24beeca18ece-tech/Target-Landing/docs/history/Autonomous_Parafoil_Targeted_Landing_COMPLETE_CONTEXT.pdf

# Autonomous Parafoil / CanSat Targeted-Landing System

Complete Technical Context, Iteration History, Code Archive, Tests,

# Logs, and Open Issues

Compiled from the conversation history, user-provided source files, test logs, and project memory

## 5 October 2026

# Contents

1 Purpose of this document | 3
2 Executive project state | 3
3 Hardware and wiring history | 3
4 Known verified sensor and calibration details | 4
5 Servo control history and the “both motors move” issue | 5
6 Navigation algorithm history | 5
7 Iteration timeline | 5
8 Python navigation logic testing | 6
9 Targeted landing simulation | 6
10 MATLAB live-monitor concept | 7
11 Most recent MATLAB screenshot diagnosis | 7
12 Why the standalone servo test works but the full code did not | 8
13 Current control law in equations | 8

Autonomous Parafoil / CanSat Targeted Landing | Technical Context Archive
14 How glide speed, descent rate, wind, and steering response are to be obtained | 9
15 Recommended next engineering sequence | 9
16 Known open questions / do not silently assume | 10
17 Compile/environment history | 10
18 Command reference | 10
A Source-code archive | 11
A.2 Archived source 2: Autonomous_Parafoil_Teensy41_FINAL_WDT_T4.ino . . . . | 31
B Artifact inventory and provenance notes | 401
C Final hand-off summary for another AI | 401

# 1 Purpose of this document

This document is a hand-off/context package for another AI model or engineer who will continue development of the autonomous parafoil targeted-landing system. It intentionally records the project history rather than silently replacing earlier designs. The archive distinguishes between verified observations, implemented code, proposed changes, and unresolved questions.

## The immediate project goal is an autonomous parafoil/CanSat system in which a Teensy 4.1

receives GPS position, computes the direction to a fixed or user-specified target coordinate, determines the required left/right steering action, actuates two ST-3009 serial bus servos, and reports the live system state to MATLAB. A later stage is intended to move from simple bearing-following to a more robust precision-landing controller using measured glide speed, descent rate, wind, steering response, and eventually a PD or predicted-landing controller.

# 2 Executive project state

Item | Current state
MCU | Teensy 4.1
GPS | Foxeer M10Q 180; proven standalone GPS baud is 38400 on Serial3
GPS pins | GPS TX →Teensy 15 (RX3); GPS RX →Teensy 14 (TX3)
Navigation sensors | GPS course above speed threshold; QMC5883 compass as low-speed
| fallback in current code
Compass | QMC5883 at I2C 0x0D; calibration values documented below; navi-
| gation mirror enabled
IMU | LSM6DSO32 at 0x6A on I2C
Barometer | BMP581 0x46/0x47; diagnostic only in current controller
Steering servos | 2 x ST-3009 serial bus servos, IDs 1 and 2, Serial1 half duplex, 1
| Mbps
Servo neutral | 2048
Current desired steering architecture | Single-servo bench/mechanical test: Servo 1 = left, Servo 2 = right;
| only requested brake servo moves from center
Deployment | SG90 on pin 8, currently manual in lab mode; prior automatic
| deployment implementation exists
Target capture | 35 m reference exists, but capture action is disabled because passing
| within 35 m while still high above ground is not equivalent to final
| landing within 35 m
Control law today | Deadband + linear course-error steering, saturated at ±450 counts;
| not a PD controller
MATLAB | Live GPS/servo monitoring and logging over Teensy USB serial;
| machine-readable NAVMAT telemetry
Most recent observed fail- ure | Servo-only test code moves the ST-3009s, but the full navigation
| code does not; screenshot shows HDOP 5.13 while the older/current
| strict navigation gate requires HDOP ≤ 3.5, causing navigation
| heading to become invalid and steering demand to remain zero

# 3 Hardware and wiring history

## 3.1 Teensy, GPS and buses

## The verified GPS arrangement is: GPS TX →Teensy pin 15 / RX3; GPS RX →Teensy pin 14 / TX3; common ground; GPS UART on

Serial3 at 38400 baud. The PC/MATLAB USB serial is separate and normally runs at 115200 baud.

## The I2C bus is shared on SDA pin 18 and SCL pin 19. The QMC5883 is at 0x0D, the LSM6DSO32

at 0x6A, and the BMP581 has been seen at 0x46 or 0x47.

## 3.2 ST-3009 servo bus

The ST-3009 devices are serial bus servos. Servo ID 1 and Servo ID 2 share the same half-duplex communication bus; the IDs distinguish the devices. They are not connected as “servo 1 to RX and servo 2 to TX”. The physical bus must use the same known-good half-duplex interface/wiring that worked in the standalone servo test. The servo supply is external and must share ground with the Teensy.
The current software uses SMS_STS st; from SCServo library version 1.0.2. Earlier compilation failed when the wrong class name SCServo was used; the working class is SMS_STS.

## 3.3 Deployment servo

SG90 signal is on pin 8. The current lab version leaves automatic deployment disabled; manual DEPLOY is preferred during bench testing.

# 4 Known verified sensor and calibration details

## 4.1 GPS

A standalone TinyGPSPlus test on Serial3 at 38400 baud was explicitly verified as working. The final controller therefore uses 38400 rather than the earlier 115200 experiments.

## 4.2 QMC5883 compass

The standalone compass implementation was verified. Initialization used register 0x0B = 0x01 and

## control register 0x09 = 0x1D. Calibration values were:

OFFSETX = 180.0000, | SCALEX = 0.956484,
OFFSETY = 336.0000, | SCALEY = 0.904406,
OFFSETZ = 615.0000, | SCALEZ = 1.178127.

## The tested navigation orientation was mirrored, so the controller contains

## navHeading = 360◦ − compassHeading

when the mirror flag is enabled. The standalone compass test itself was not mirrored; the mirror was only added for navigation.

## 4.3 IMU

The working library/API is Adafruit_LSM6DSOX; the device address is 0x6A. Prior setup used a 16 g accelerometer range, 2000 dps gyro range, and 208 Hz accelerometer and gyro data rates.

## 4.4 BMP581

BMP581 is used as a diagnostic presence check in the current controller. No altitude-based steering or deployment decision has been integrated yet.

# 5 Servo control history and the “both motors move” issue

The original final-lab steering implementation used differential steering. A positive demand was

## mapped to S1 = 2048 − d, S2 = 2048 + d

and a negative demand used the opposite signs. Both ST-3009s were therefore commanded on every steering change. This was intentional differential steering, not a software bug.
The project requirement was later clarified as a single-brake style bench/mechanical test: a LEFT command should move only the left servo from neutral while the right stays at 2048, and vice

## versa for RIGHT. The single-servo mapping is therefore:

CENTER : S1 = 2048, S2 = 2048, LEFT : S1 ̸= 2048, S2 = 2048, RIGHT : S1 = 2048, S2 ̸= 2048.

A direct jump from LEFT to RIGHT can still make both physical servos move because one must return to center while the other leaves center.
The standalone ST-3009 test code uses a servo command speed of 2400 and acceleration 50; this became an important reference because the full controller initially used a slower speed of 500.

# 6 Navigation algorithm history

## 6.1 Original basic target-following algorithm

## The original controller logic is:

1. Read current GPS latitude/longitude.
2. Compute distance to target.
3. Compute target bearing using the current position and target coordinate.

## 4. Select current direction: GPS course when speed is above 1.5 m/s, otherwise QMC5883

compass.
5. Compute course error as target bearing minus current direction.

## 6. Wrap course error to −180◦

to +180◦

## 7. Apply a ±5

- deadband.

## 8. Linearly map error from the deadband to ±450 servo counts at ±90◦

error.
9. Apply slew limiting of 60 counts per navigation update.
This is a proportional-like controller with deadband, saturation, and slew limiting. It is not a PD controller.

## 6.2 Target capture realization

The early design used distance ≤ 35 m as “target captured” and centered the servos. Simulation later demonstrated why this is unsafe for a parafoil: entering a 35 m horizontal circle while hundreds of metres above the ground does not imply a final landing within 35 m. The current MATLAB/Teensy lab design therefore keeps the 35 m circle as a reference and disables the capture action by default.

# 7 Iteration timeline

Stage | Artifact / concept | Main result or change
Early | hard-
ware | GPS, compass, IMU, BMP, ST-3009, SG90 integration | Pin mapping and sensor addresses established.

## Compass calibration

## QMC5883 standalone test Calibration offsets/scales established; navigation

mirror discovered.

## GPS standalone

TinyGPSPlus / Serial3 | 38400 baud verified.

## Initial guided code

## Autonomous parafoil controller

## GPS-to-target bearing, GPS-course/compass head-

ing, servo steering, state machine.

## Servo-bus de-bugging

SCServo / ST-3009 | Correct class identified as SMS_STS; IDs 1/2 and
half-duplex bus verified.

## Differential steering stage

## Original

## commandSteering()

## Both servos moved in opposite directions; later determined to be unsuitable for the desired single-

brake bench test.

## Python logic stage

## parafoil_nav_test.py

## and corrected version

## Offline distance/bearing/error/servo mapping checks; discovered that mislabeled test headings

can make all commands saturate.

## Targeted-flight simulation

targeted_landing_simulation.py 600 m, assumed 8 m/s glide speed, 4 m/s descent,

## no wind; a sample run produced 617.7 m final error despite entering the 35 m circle, exposing the

capture-logic problem.

## MATLAB live monitoring

## MATLAB COM monitor + NAVMAT telemetry

## Live GPS path, distance, target bearing, GPS course, heading, servo command/feedback and ap-

proach status.

## Single-servo final lab code

Teensy_Parafoil_Final_SingleServo_MATLAB.ino Added single-servo mapping and MATLAB telemetry, but inherited strict GPS-quality gate.

## Servo-fixed at-tempt

## Teensy_Parafoil_FINAL_SERVO_FIXED.ino Bench-oriented servo timing/speed improvements

were proposed/generated.

## Latest user test User-pasted 20261005 controller

## Standalone servo test works but final navigation

code does not move servos when GPS is moved.

## Screenshot shows HDOP 5.13; strict quality thresh-

old 3.5 blocks navigation.

# 8 Python navigation logic testing

The first Python test bench was designed to simulate current GPS position and heading. It calculated

## distance to target, target bearing, wrapped course error, the ±5

## - deadband, steering demand up

to ±450, and servo positions around neutral 2048. A corrected normal Python file was produced after the user attempted to execute a Jupyter “.ipynb“ as a normal Python script and got the error “NameError: name ’null’ is not defined“. The corrected distribution included both a normal .py script and a valid Jupyter notebook.
A key test mistake was identified in the initial run. With target latitude 32.7593400 and current

## latitude 32.6438366 at the same longitude, the target was north (bearing approximately 0◦ ). A test labeled “ALIGNED“ used heading 180◦ , which is actually exactly opposite the target. The saturated

−450 result was therefore correct. This was an important validation of the angle-wrapping and saturation logic, not evidence of a controller bug.

# 9 Targeted landing simulation

## The simplified 2D simulator used:

- Initial altitude = 600 m.
- Glide speed = 8 m/s (explicitly an assumed placeholder, not a measured value).
- Descent rate = 4 m/s (also an assumed placeholder).
- Constant or random wind options.
- Simplified maximum turn rate = 25 deg/s (model assumption).

- Servo demand to heading turn-rate model.
- 35 m target capture reference.

## One sample output was:

Initial altitude | : 600.0 m
Glide speed | : 8.00 m/s
Descent rate | : 4.00 m/s
Wind | : N +0.00 m/s, E +0.00 m/s
Flight time | : 150.10 s
Landing offset | : N -529.68 m, E +317.81 m
Landing error | : 617.70 m
Target captured | : YES
35 m requirement | : FAIL

The result was not treated as a real-flight prediction because the parafoil parameters were guessed. It was instead used to expose a real algorithmic issue: current-distance capture is not the same as predicted landing-point capture.

# 10 MATLAB live-monitor concept

## The intended data flow is:

## GPS → Teensy Serial3 → navigation code

## and

ST-3009 bus → Teensy Serial1 → feedback,

with the Teensy forwarding a machine-readable telemetry line over USB to MATLAB.

## The telemetry includes:

NAVMAT,millis,lat,lon,alt,speed,gpsCourse,heading, distance,bearing,error,demand,cmdS1,cmdS2,

## fbS1,fbS2,sats,hdop,state,headingSource,compass

MATLAB uses GPS movement direction and distance trend to tell whether the vehicle is approaching or moving away from the target. Servo feedback is read using ReadPos(), distinguishing actual feedback from commanded servo position.

# 11 Most recent MATLAB screenshot diagnosis

## The latest screenshot contained approximately:

## TARGET LAT : 32.6323559 LON : 75.0143343

## CURRENT GPS

LAT | : 32.6399383
LON | : 75.0137900
ALT | : 516.6 m
SAT | : 8

## HDOP : 5.13

DISTANCE | : 878.37 m

## TARGET BEARING : 176.45 deg

GPS COURSE | : 51.13 deg

## CONTROLLER HDG : 148.57 deg HEADING SOURCE : NONE

STEERING | : 0

The controller code currently defines a strict GPS maximum HDOP of 3.5 and aborts navigation calculations when gpsQualityOK() is false. Since 5.13 > 3.5, the code marks heading as invalid and the steering function intentionally centers/does not command the servos. This provides a concrete explanation for the observed “motors do not move when GPS is moved” behavior in the latest full code.
The screenshot also reveals a display issue: the controller heading field can still show a stale numeric value while the source field says “NONE”. The telemetry line prints the numeric

## currentDirection whether or not headingValid is true. A future MATLAB display should show

“INVALID” whenever heading source is NONE rather than displaying a stale number.

# 12 Why the standalone servo test works but the full code did not

The pure ST-3009 test removes GPS quality, state-machine, heading-validity, and navigation condi-

## tions. It sends direct commands such as:

LEFT | -> ID1 = 1748, ID2 = 2048
RIGHT | -> ID1 = 2048, ID2 = 1748

## CENTER -> ID1 = 2048, ID2 = 2048

Therefore, when this program works, it proves that the electrical bus, IDs, SCServo library, and basic WritePosEx() transaction can work.

## The full controller contains additional gates:

1. Servo bus must be healthy.
2. State must be STATE_AUTONAV for autonomous steering.
3. GPS quality must pass the configured satellite, freshness, and HDOP conditions.
4. A valid heading must exist.
5. The course error must produce a nonzero demand outside the deadband.
The latest observed HDOP failure is therefore sufficient to explain a zero steering command even though the servo hardware itself works.

# 13 Current control law in equations

For valid heading,

e = wrap[−180,180](Btarget − Hcurrent).

## If |e| ≤ 5

◦

## , then

u = 0.

Otherwise,

## |u| = 450 sat

|e| − 5
90 − 5

, 0, 1

,

with the sign of u equal to the sign of e. The single-servo mapping is then determined by the left/right configuration. With Servo 1 as LEFT,

u > 0 : S1 = 2048 + d, S2 = 2048,

where d is the positive steering magnitude adjusted by the configured direction sign, and for u < 0 the right servo moves from center.

The controller is therefore currently a proportional/lookup-like heading-error law. A future PD

## law would have the generic form u = Kpe + Kde,˙

## or, preferably for a parafoil using an IMU, a damped form using yaw rate such as

u = Kpe − Kdr.

No final PD gains have been established or validated.

# 14 How glide speed, descent rate, wind, and steering response are to be obtained

These values must be measured rather than guessed.

## 14.1 Glide speed

GPS speed is ground speed, not necessarily airspeed. Measure representative straight descents and calculate horizontal ground travel over time. Combine with vertical descent to estimate glide ratio. If wind is separately estimated, a better air-relative speed can be inferred.

## 14.2 Descent rate

## Measure altitude loss over time during a stable descent:

Vd = −

∆h
∆t

The current BMP581 is available for future altitude diagnostics, while GPS altitude may be logged for an initial experiment.

## 14.3 Wind

## The fundamental relationship is

V⃗

ground = V⃗

air + V⃗wind.

With enough straight-flight measurements in multiple directions, wind can be estimated as a vector. A simple out-and-back example can give a first scalar estimate, but a proper vector solution is preferred.

## 14.4 Steering response

For several controlled servo demands (for example 50, 100, 150, 200, 300, 450 counts), record GPS course and/or gyro yaw rate versus time. Derive a table or fitted model of servo demand versus turn rate and latency. Those measurements should drive the future simulation rather than the placeholder 25 deg/s used in the first simulator.

# 15 Recommended next engineering sequence

1. Prove the pure servo bus test.
2. In the full controller, prove PING1/PING2, positions and manual LEFT/RIGHT commands.
3. In lab mode, relax HDOP only for walking tests so the GPS course can be exercised; restore strict values for flight.
4. Verify that MATLAB shows heading source correctly and does not display stale heading values.
5. Move the system physically while logging GPS course, distance, altitude, servo commands, servo feedback, and gyro Z.

6. Characterize descent rate, glide speed, glide ratio, wind response and steering response.
7. Use the measured response to build a realistic MATLAB model.
8. Tune a PD/damped steering controller.
9. Add predicted landing point / energy-to-go logic instead of “current distance < 35 m” capture.
10. Validate the full flight-state machine and failsafe behavior.

# 16 Known open questions / do not silently assume

- Whether the Foxeer M10Q internal compass is actually accessible through the same interface has not been resolved in the final software; the implemented navigation code still uses the separate QMC5883 path.
- The exact physical half-duplex interface between Teensy Serial1 pins 0/1 and the ST-3009

## DATA bus must remain the known-good hardware arrangement; do not invent a direct TX/RX

wiring change without checking the existing working setup.
- The mechanical sign of LEFT/RIGHT steering must be verified with the actual parafoil linkage. Software sign flags alone cannot establish aerodynamic turn direction.
- Glide speed, descent rate, wind, and turn response are not yet measured; simulation values 8 m/s, 4 m/s, and 25 deg/s are placeholders only.
- The current algorithm is not yet a validated precision-landing controller.

# 17 Compile/environment history

The known compile environment included Teensy 4.1, Teensy core 1.62.0, TinyGPSPlus 1.0.3, SCServo 1.0.2, Adafruit LSM6DS 4.7.4, and the Teensy Servo library. One historical compilation issue was the use of a nonexistent SCServo class; the correct library class for the tested configuration is SMS_STS. A previous user log also showed a successful Teensy toolchain invocation with GCC/Teensy compile tools and the relevant library include paths.

# 18 Command reference

Command | Meaning
STATUS | Print complete system state, GPS quality, navigation, compass and servo
| information.
PING1, PING2 | Directly test communication with ST-3009 IDs 1 and 2.
POS1, POS2 | Read actual servo positions.
CENTER | Command both servos to 2048 and return to wait state.
LEFT | Manual left command; current single-servo design intends to move only
| the left servo.
RIGHT | Manual right command; current single-servo design intends to move only
| the right servo.
MOTORTEST | Automatic center-left-center-right-center sequence.
AUTONAV | Enable autonomous steering when GPS and servos pass readiness gates.
TARGET lat lon | Update the target coordinate without recompiling.
DEPLOY | Manually start the SG90 deployment sequence.
PREP | Move SG90 to preparation angle and detach.
RESET | Stop active tests/deployment state and return to waiting.
HELP | Print command list.

# A Source-code archive

The following appendices contain the actual project source files available in the working environment. The archive includes near-duplicate files where those files existed as separate conversation artifacts so that a future AI can reconstruct the iteration history rather than relying only on a summarized diff.

## A.1 Archived source 1: Autonomous_Parafoil_Teensy41_Final.ino

## Source file: Autonomous_Parafoil_Teensy41_Final.ino

1 | /*
2 | =====================================================================
3 | TEENSY 4.1 AUTONOMOUS PARAFOIL / TARGETED-LANDING SYSTEM
4 | =====================================================================

5
6 | REFERENCE USED:
7 | R2Home_rls_V0_9

8
9 | CURRENT HARDWARE:
10 | MCU | : Teensy 4.1
11 | GPS | : Foxeer M10Q 180 GPS + QMC5883 Compass
12 | Compass | : QMC5883 @ 0x0D
13 | IMU | : LSM6DSO32 @ 0x6A
14 | Barometer : BMP581 @ 0x46 / 0x47
15 | Servos | : 2 x ST-3009 serial bus TTL servos
16 | | Servo 1 = ID 1
17 | | Servo 2 = ID 2
18 | Deploy | : SG90
19 | SD | : Teensy 4.1 BUILTIN_SDCARD

20
21 | UARTS:
22 | Serial1 | : ST-3009 half-duplex servo bus
23 | | TX1 = pin 1, RX1 = pin 0
24 | Serial3 | : Foxeer GPS
25 | | GPS TX -> pin 15 / RX3
26 | | GPS RX -> pin 14 / TX3

27
28 | I2C:
29 | SDA = pin 18
30 | SCL = pin 19

31
32 | IMPORTANT:
33 | - System starts DISARMED.
34 | - Steering stays neutral until the wing is deployed.
35 | - TARGET,<lat>,<lon> sets the target.
36 | - ARM starts autonomous flight-state detection.
37 | - Deployment occurs at DEPLOY_ALTITUDE_M above the launch
38 | barometric level while descending.
39 | - The final left/right mechanical steering sign MUST be verified
40 | with the real parafoil/linkage. That mapping cannot be proven
41 | from bench servo rotation alone.

42
43 | =====================================================================
44 | */

45
46 | #include <Wire.h>
47 | #include <math.h>
48 | #include <string.h>
49 | #include <stdio.h>
50 | #include <stdlib.h>

51
52 | #include <TinyGPSPlus.h>
53 | #include <Adafruit_LSM6DSOX.h>
54 | #include <Adafruit_BMP5xx.h>
55 | #include <SCServo.h>
56 | #include <Servo.h>
57 | #include <SD.h>
58 | #include <Watchdog.h>

59
60 | // =====================================================================
61 | // | USER CONFIGURATION

62 // =====================================================================

63
64 | // ----------------------------- GPS ---------------------------------
65 | #define GPS_SERIAL Serial3
66 | #define GPS_BAUD 115200

67
68 | // ----------------------------- I2C ---------------------------------
69 | #define QMC5883_ADDR | 0x0D
70 | #define LSM6DSO32_ADDR 0x6A
71 | #define BMP_ADDR_1 | 0x46
72 | #define BMP_ADDR_2 | 0x47

73
74 | // ----------------------------- GPS PINS -----------------------------
75 | // Foxeer TX -> Teensy Pin 15 / RX3
76 | // Foxeer RX -> Teensy Pin 14 / TX3

77
78 | // ----------------------------- SERVO -------------------------------
79 | #define SERVO1_ID 1
80 | #define SERVO2_ID 2

81
82 | // ST-3009 position range used by your tested library/code
83 | const int SERVO_NEUTRAL = 2048;
84 | const int SERVO_MIN_POS = 200;
85 | const int SERVO_MAX_POS = 3895;

86
87 | // Maximum steering displacement from neutral.
88 | // 450 counts is about 39.6 degrees of encoder travel.
89 | const int MAX_STEER_COUNTS = 450;

90
91 | // Target-bearing error that produces full steering.
92 | const float FULL_STEER_ERROR_DEG = 90.0f;

93
94 | // Do not react aggressively to tiny GPS/heading errors.
95 | const float HEADING_DEADBAND_DEG = 5.0f;

96
97 | // GPS course is used when there is enough ground speed.
98 | const float GPS_COURSE_MIN_SPEED_MPS = 1.5f;

99
100 | // GPS navigation quality limits
101 | const uint32_t GPS_DATA_TIMEOUT_MS = 1500;
102 | const uint8_t | GPS_MIN_SATS = 5;
103 | const float | GPS_MAX_HDOP = 3.5f;

104
105 | // ------------------------ STEERING MAPPING --------------------------
106 | //
107 | // Positive steer means the target is to the RIGHT of the current
108 | // direction. With the default mapping:
109 | // | positive steer -> Servo 1 lower, Servo 2 higher
110 | // | negative steer -> Servo 1 higher, Servo 2 lower
111 | //
112 | // Change TURN_SIGN to -1 after mechanical testing if the parafoil
113 | // turns in the opposite direction.
114 | //
115 | const int TURN_SIGN = 1;

116
117 | // Individual servo direction reversal options.
118 | // The servos themselves were verified as:
119 | // lower position -> CCW
120 | // higher position -> CW
121 | //
122 | // These flags are for the actual linkage/mounting geometry.
123 | const bool SERVO1_REVERSE = false;
124 | const bool SERVO2_REVERSE = false;

125
126 | // Servo command rate
127 | const uint32_t SERVO_UPDATE_MS = 100;

128
129 | // Servo movement settings from your working ST-3009 tests
130 | const int SERVO_SPEED = 500;
131 | const int SERVO_ACCEL = 50;

132
133 | // -------------------------- DEPLOYMENT ------------------------------
134 | // R2Home reference used a PWM command corresponding to about 140 deg
135 | // before release and about 70 deg after release.
136 | #define DEPLOY_SERVO_PIN 8

137 | const int DEPLOY_PRELAUNCH_ANGLE = 140;
138 | const int DEPLOY_RELEASE_ANGLE | = 70;

139
140 | // Required deployment point above launch level.
141 | const float DEPLOY_ALTITUDE_M = 600.0f;

142
143 | // Wait for the parafoil to inflate/stabilize before steering.
144 | const uint32_t DEPLOY_STABILIZE_MS = 5000;

145
146 | // ------------------------- FLIGHT DETECTION -------------------------
147 | const float LAUNCH_ASCENT_VS_MPS = 1.0f;
148 | const uint32_t LAUNCH_CONFIRM_MS = 1000;

149
150 | const float DESCENT_VS_MPS = -0.5f;
151 | const uint32_t DESCENT_CONFIRM_MS = 1000;

152
153 | // --------------------------- LANDING -------------------------------
154 | const float LANDING_ALTITUDE_M = 12.0f;
155 | const float LANDING_MAX_ABS_VS_MPS = 0.6f;
156 | const uint32_t LANDING_CONFIRM_MS = 6000;

157
158 | // Target capture / final approach
159 | const float TARGET_CAPTURE_RADIUS_M = 35.0f;
160 | const float TARGET_RELEASE_RADIUS_M = 60.0f;

161
162 | // Reduce steering authority near the ground.
163 | const float FINAL_APPROACH_ALT_M = 120.0f;
164 | const float FINAL_STEER_SCALE = 0.70f;

165
166 | // -------------------------- COMPASS --------------------------------
167 | // Your existing compass code is used exactly for the numeric heading.
168 | // Leave this at 0 unless a fixed installation offset is measured.
169 | const float COMPASS_HEADING_OFFSET_DEG = 0.0f;

170
171 | // Your existing calibration values
172 | const float OFFSET_X = 180.0000f;
173 | const float OFFSET_Y = 336.0000f;
174 | const float OFFSET_Z = 615.0000f;

175
176 | const float SCALE_X = 0.956484f;
177 | const float SCALE_Y = 0.904406f;
178 | const float SCALE_Z = 1.178127f;

179
180 | // ------------------------- BAROMETER -------------------------------
181 | // Relative altitude is computed from the pressure captured at ARM.
182 | const float BARO_EXPONENT = 0.19029496f;

183
184 | // ------------------------------ SD ---------------------------------
185 | const int SD_CS = BUILTIN_SDCARD;
186 | const char *LOG_FILE = "AUTONAV.CSV";

187
188 | // =====================================================================
189 | // | OBJECTS / GLOBALS
190 | // =====================================================================

191
192 | TinyGPSPlus gps;
193 | Adafruit_LSM6DSOX lsm6dso;
194 | Adafruit_BMP5xx bmp;
195 | SMS_STS st;
196 | Servo deployServo;
197 | Watchdog watchdog;

198
199 | bool compassOK = false;
200 | bool imuOK = false;
201 | bool bmpOK = false;
202 | bool servo1OK = false;
203 | bool servo2OK = false;
204 | bool sdOK = false;

205
206 | // ------------------------------ Target ------------------------------
207 | double targetLat = 0.0;
208 | double targetLon = 0.0;
209 | bool targetSet = false;

210
211 // ------------------------------- GPS -------------------------------

212 | double gpsLat = 0.0;
213 | double gpsLon = 0.0;
214 | double gpsAlt = 0.0;
215 | double gpsSpeedMps = 0.0;
216 | double gpsCourseDeg = 0.0;
217 | uint32_t gpsSats = 0;
218 | double gpsHDOP = 99.9;
219 | bool gpsFix = false;
220 | uint32_t lastGPSLocationMs = 0;

221
222 | // ----------------------------- Compass -----------------------------
223 | int16_t rawX = 0;
224 | int16_t rawY = 0;
225 | int16_t rawZ = 0;
226 | float magX = 0.0f;
227 | float magY = 0.0f;
228 | float magZ = 0.0f;
229 | float compassHeading = 0.0f;

230
231 | // ------------------------------- IMU -------------------------------
232 | float ax = 0.0f;
233 | float ay = 0.0f;
234 | float az = 0.0f;
235 | float gx = 0.0f;
236 | float gy = 0.0f;
237 | float gz = 0.0f;
238 | float imuTemp = 0.0f;

239
240 | // ----------------------------- BMP581 ------------------------------
241 | float pressurePa = 0.0f;
242 | float bmpTemp = 0.0f;
243 | float baroAltRaw = 0.0f;
244 | float baroAltFiltered = 0.0f;
245 | float relativeAlt = 0.0f;
246 | float verticalSpeed = 0.0f;
247 | float launchPressurePa = 0.0f;
248 | bool baroFilterInitialized = false;

249
250 | // -------------------------- Navigation -----------------------------
251 | double targetDistanceM = 0.0;
252 | double targetBearingDeg = 0.0;
253 | float currentDirectionDeg = 0.0f;
254 | float courseErrorDeg = 0.0f;
255 | int steeringDemand = 0;
256 | char directionSource[8] = "NONE";

257
258 | // ----------------------------- Servos ------------------------------
259 | int servo1Command = SERVO_NEUTRAL;
260 | int servo2Command = SERVO_NEUTRAL;
261 | int servo1Actual = -1;
262 | int servo2Actual = -1;
263 | uint32_t lastServoWriteMs = 0;
264 | uint32_t lastServoHealthMs = 0;
265 | uint32_t lastServoReadMs = 0;

266
267 | // --------------------------- Deployment ----------------------------
268 | bool deployed = false;
269 | uint32_t deploymentMs = 0;

270
271 | // ------------------------- State machine ---------------------------
272 | enum FlightState
273 | {
274 | STATE_DISARMED = 0,
275 | STATE_ARMED = 1,
276 | STATE_ASCENT = 2,
277 | STATE_DESCENT = 3,
278 | STATE_DEPLOY_STABILIZE = 4,
279 | STATE_AUTONAV = 5,
280 | STATE_CAPTURED = 6,
281 | STATE_LANDED = 7,
282 | STATE_FAILSAFE = 8
283 | };

284
285 | FlightState state = STATE_DISARMED;
286 | FlightState previousState = STATE_DISARMED;

287
288 | uint32_t ascentStartMs = 0;
289 | uint32_t descentStartMs = 0;
290 | uint32_t landingStartMs = 0;
291 | uint32_t gpsGoodStartMs = 0;

292
293 | // ------------------------------ Timers -----------------------------
294 | uint32_t lastSensorMs = 0;
295 | uint32_t lastPrintMs = 0;
296 | uint32_t lastLogMs = 0;
297 | uint32_t lastNavMs = 0;

298
299 | // =====================================================================
300 | // | HELPER FUNCTIONS
301 | // =====================================================================

302
303 | float wrap360(float a)
304 | {
305 | while (a < 0.0f) a += 360.0f;
306 | while (a >= 360.0f) a -= 360.0f;
307 | return a;
308 | }

309
310 | float wrap180(float a)
311 | {
312 | while (a > 180.0f) a -= 360.0f;
313 | while (a <= -180.0f) a += 360.0f;
314 | return a;
315 | }

316
317 | int clampServoPosition(int p)
318 | {
319 | if (p < SERVO_MIN_POS) return SERVO_MIN_POS;
320 | if (p > SERVO_MAX_POS) return SERVO_MAX_POS;
321 | return p;
322 | }

323
324 | const char* stateName(FlightState s)
325 | {
326 | switch (s)
327 | {
328 | case STATE_DISARMED: | return "DISARMED";
329 | case STATE_ARMED: | return "ARMED";
330 | case STATE_ASCENT: | return "ASCENT";
331 | case STATE_DESCENT: | return "DESCENT";
332 | case STATE_DEPLOY_STABILIZE: return "DEPLOY_STAB";
333 | case STATE_AUTONAV: | return "AUTONAV";
334 | case STATE_CAPTURED: | return "CAPTURED";
335 | case STATE_LANDED: | return "LANDED";
336 | case STATE_FAILSAFE: | return "FAILSAFE";
337 | default: | return "UNKNOWN";
338 | }
339 | }

340
341 | bool gpsQualityOK()
342 | {
343 | if (!gpsFix) return false;
344 | if ((millis() - lastGPSLocationMs) > GPS_DATA_TIMEOUT_MS) return false;
345 | if (gpsSats < GPS_MIN_SATS) return false;
346 | if (gps.hdop.isValid() && gpsHDOP > GPS_MAX_HDOP) return false;
347 | return true;
348 | }

349
350 | // =====================================================================
351 | // | QMC5883 COMPASS
352 | // | EXACT WORKING IMPLEMENTATION STYLE
353 | // =====================================================================

354
355 | void writeRegister(byte reg, byte value)
356 | {
357 | Wire.beginTransmission(QMC5883_ADDR);
358 | Wire.write(reg);
359 | Wire.write(value);
360 | Wire.endTransmission();
361 | }

362
363 | bool readQMC5883(int16_t &x, int16_t &y, int16_t &z)
364 | {
365 | Wire.beginTransmission(QMC5883_ADDR);
366 | Wire.write(0x00);

367
368 | if (Wire.endTransmission(false) != 0)
369 | return false;

370
371 Wire.requestFrom(QMC5883_ADDR, 6);

372
373 | if (Wire.available() < 6)
374 | return false;

375
376 | uint8_t xl = Wire.read();
377 | uint8_t xh = Wire.read();
378 | uint8_t yl = Wire.read();
379 | uint8_t yh = Wire.read();
380 | uint8_t zl = Wire.read();
381 | uint8_t zh = Wire.read();

382
383 | x = (int16_t)((xh << 8) | xl);
384 | y = (int16_t)((yh << 8) | yl);
385 | z = (int16_t)((zh << 8) | zl);

386
387 | return true;
388 | }

389
390 | bool initializeQMC5883()
391 | {
392 | Wire.beginTransmission(QMC5883_ADDR);

393
394 | if (Wire.endTransmission() != 0)
395 | return false;

396
397 | // Same initialization as your verified compass code.
398 | writeRegister(0x0B, 0x01);
399 | delay(10);
400 | writeRegister(0x09, 0x1D);
401 | delay(100);

402
403 | return true;
404 | }

405
406 | bool updateCompass()
407 | {
408 | if (!readQMC5883(rawX, rawY, rawZ))
409 | return false;

410
411 | magX = (rawX - OFFSET_X) * SCALE_X;
412 | magY = (rawY - OFFSET_Y) * SCALE_Y;
413 | magZ = (rawZ - OFFSET_Z) * SCALE_Z;

414
415 float angle = atan2(magY, magX) * 180.0f / PI;

416
417 | if (angle < 0.0f)
418 | angle += 360.0f;

419
420 compassHeading = wrap360(angle + COMPASS_HEADING_OFFSET_DEG);

421
422 | return true;
423 | }

424
425 | // Same direction labels as your verified compass test. The numeric
426 | // heading used by navigation is unaffected by these display labels.
427 | const char* directionName(float h)
428 | {
429 | if (h >= 337.5f || h < 22.5f) return "NORTH";
430 | if (h < 67.5f) return "NORTH-EAST";
431 | if (h < 112.5f) return "WEST";
432 | if (h < 157.5f) return "SOUTH-EAST";
433 | if (h < 202.5f) return "SOUTH";
434 | if (h < 247.5f) return "SOUTH-WEST";
435 | if (h < 292.5f) return "EAST";
436 | return "NORTH-WEST";

437 }

438
439 | // =====================================================================
440 | // | IMU
441 | // =====================================================================

442
443 | bool initializeIMU()
444 | {
445 | | if (!lsm6dso.begin_I2C(LSM6DSO32_ADDR, &Wire))
446 | return false;

447
448 | | // Same ranges/data rates as your known working sensor code.
449 | | lsm6dso.setAccelRange(LSM6DS_ACCEL_RANGE_16_G);
450 | | lsm6dso.setGyroRange(LSM6DS_GYRO_RANGE_2000_DPS);
451 | | lsm6dso.setAccelDataRate(LSM6DS_RATE_208_HZ);
452 | | lsm6dso.setGyroDataRate(LSM6DS_RATE_208_HZ);

453
454 | return true;
455 | }

456
457 | void updateIMU()
458 | {
459 | if (!imuOK) return;

460
461 | sensors_event_t accel;
462 | sensors_event_t gyro;
463 | sensors_event_t temp;

464
465 | | lsm6dso.getEvent(&accel, &gyro, &temp);

466
467 | | ax = accel.acceleration.x / 9.80665f;
468 | | ay = accel.acceleration.y / 9.80665f;
469 | | az = accel.acceleration.z / 9.80665f;

470
471 | | gx = gyro.gyro.x * 57.2957795f;
472 | | gy = gyro.gyro.y * 57.2957795f;
473 | | gz = gyro.gyro.z * 57.2957795f;

474
475 | imuTemp = temp.temperature;
476 | }

477
478 | // =====================================================================
479 | // | BMP581
480 | // =====================================================================

481
482 | bool initializeBMP()
483 | {
484 | | if (bmp.begin(BMP_ADDR_1, &Wire))
485 | return true;

486
487 | | if (bmp.begin(BMP_ADDR_2, &Wire))
488 | return true;

489
490 | return false;
491 | }

492
493 | float pressureToRelativeAltitude(float p)
494 | {
495 | | if (!isfinite(p) || p <= 0.0f || launchPressurePa <= 0.0f)
496 | return 0.0f;

497
498 | return 44330.0f *
499 | | (1.0f - powf(p / launchPressurePa, BARO_EXPONENT));
500 | }

501
502 | void updateBMP()
503 | {
504 | if (!bmpOK) return;

505
506 | | float p = bmp.readPressure();
507 | | float t = bmp.readTemperature();

508
509 | | if (!isfinite(p) || !isfinite(t) || p <= 0.0f)
510 | return;

512 | pressurePa = p;
513 | bmpTemp = t;
514 | | baroAltRaw = pressureToRelativeAltitude(p);

515
516 | | // Slow filter to reduce pressure noise while retaining useful
517 | | // vertical-speed information.
518 | | if (!baroFilterInitialized)
519 | {
520 | | baroAltFiltered = baroAltRaw;
521 | | baroFilterInitialized = true;
522 | }
523 | else
524 | {
525 | | const float ALT_ALPHA = 0.25f;
526 | | baroAltFiltered += ALT_ALPHA * (baroAltRaw - baroAltFiltered);
527 | }

528
529 | | relativeAlt = baroAltFiltered;
530 | }

531
532 | // =====================================================================
533 | // | GPS
534 | // =====================================================================

535
536 | void updateGPS()
537 | {
538 | | while (GPS_SERIAL.available())
539 | | gps.encode(GPS_SERIAL.read());

540
541 | | // Update the timestamp only when a NEW position sentence has been
542 | | // decoded. This makes the GPS timeout a real communication timeout.
543 | | if (gps.location.isUpdated())
544 | {
545 | | gpsLat = gps.location.lat();
546 | | gpsLon = gps.location.lng();
547 | | lastGPSLocationMs = millis();
548 | }

549
550 | | gpsFix = gps.location.isValid();

551
552 | | if (gps.altitude.isValid())
553 | | gpsAlt = gps.altitude.meters();

554
555 | if (gps.speed.isValid())
556 | | gpsSpeedMps = gps.speed.mps();

557
558 | | if (gps.course.isValid())
559 | | gpsCourseDeg = gps.course.deg();

560
561 | | if (gps.satellites.isValid())
562 | | gpsSats = gps.satellites.value();

563
564 | if (gps.hdop.isValid())
565 | | gpsHDOP = gps.hdop.hdop();
566 | }

567
568 | // =====================================================================
569 | // | NAVIGATION CALCULATION
570 | // =====================================================================

571
572 | void updateNavigation()
573 | {
574 | | if (!targetSet || !gpsFix)
575 | {
576 | targetDistanceM = 0.0;
577 | | targetBearingDeg = 0.0;
578 | courseErrorDeg = 0.0f;
579 | steeringDemand = 0;
580 | | strcpy(directionSource, "NONE");
581 | return;
582 | }

583
584 | | targetDistanceM = TinyGPSPlus::distanceBetween(
585 | gpsLat,
586 | gpsLon,

587 | targetLat,
588 | targetLon
589 | );

590
591 | | targetBearingDeg = TinyGPSPlus::courseTo(
592 | gpsLat,
593 | gpsLon,
594 | targetLat,
595 | targetLon
596 | );

597
598 | bool gpsCourseUsable =
599 | gpsQualityOK() &&
600 | gps.course.isValid() &&
601 | | gpsSpeedMps >= GPS_COURSE_MIN_SPEED_MPS;

602
603 | if (gpsCourseUsable)
604 | {
605 | | currentDirectionDeg = wrap360((float)gpsCourseDeg);
606 | | strcpy(directionSource, "GPS");
607 | }
608 | else if (compassOK)
609 | {
610 | | currentDirectionDeg = compassHeading;
611 | | strcpy(directionSource, "COMPASS");
612 | }
613 | else
614 | {
615 | steeringDemand = 0;
616 | courseErrorDeg = 0.0f;
617 | | strcpy(directionSource, "NONE");
618 | return;
619 | }

620
621 | courseErrorDeg = wrap180(
622 | | (float)targetBearingDeg - currentDirectionDeg
623 | );

624
625 | | float absError = fabsf(courseErrorDeg);

626
627 | | if (absError <= HEADING_DEADBAND_DEG)
628 | {
629 | steeringDemand = 0;
630 | return;
631 | }

632
633 | | float normalized = absError / FULL_STEER_ERROR_DEG;
634 | | if (normalized > 1.0f) normalized = 1.0f;

635
636 | | float demand = normalized * MAX_STEER_COUNTS;

637
638 | | // Positive error = target to the right.
639 | | if (courseErrorDeg > 0.0f)
640 | demand = fabsf(demand);
641 | else
642 | | demand = -fabsf(demand);

643
644 demand *= TURN_SIGN;

645
646 | | // Reduce authority during final low-altitude approach.
647 | | if (relativeAlt < FINAL_APPROACH_ALT_M)
648 | | demand *= FINAL_STEER_SCALE;

649
650 | | steeringDemand = (int)roundf(demand);

651
652 | | // Capture zone: stop aggressive steering inside the target radius.
653 | | if (targetDistanceM <= TARGET_CAPTURE_RADIUS_M)
654 | {
655 | steeringDemand = 0;
656 | }
657 | }

658
659 | // =====================================================================
660 | // | SERVO CONTROL
661 | // =====================================================================

662
663 | int applyReverse(int position, bool reverse)
664 | {
665 | if (!reverse)
666 | return position;

667
668 | return SERVO_NEUTRAL - (position - SERVO_NEUTRAL);
669 | }

670
671 | void setSteeringNeutral(bool immediate = false)
672 | {
673 | servo1Command = SERVO_NEUTRAL;
674 | servo2Command = SERVO_NEUTRAL;

675
676 | if (immediate)
677 | {
678 | st.WritePosEx(SERVO1_ID, servo1Command, SERVO_SPEED, SERVO_ACCEL);
679 | st.WritePosEx(SERVO2_ID, servo2Command, SERVO_SPEED, SERVO_ACCEL);
680 | }
681 | }

682
683 | void setSteeringFromDemand(int demand)
684 | {
685 | demand = constrain(demand, -MAX_STEER_COUNTS, MAX_STEER_COUNTS);

686
687 | // Default differential-brake mapping:
688 | // demand > 0: Servo 1 lower, Servo 2 higher
689 | int s1 = SERVO_NEUTRAL - demand;
690 | int s2 = SERVO_NEUTRAL + demand;

691
692 | s1 = applyReverse(s1, SERVO1_REVERSE);
693 | s2 = applyReverse(s2, SERVO2_REVERSE);

694
695 | servo1Command = clampServoPosition(s1);
696 | servo2Command = clampServoPosition(s2);
697 | }

698
699 | void updateServos()
700 | {
701 | if (millis() - lastServoWriteMs < SERVO_UPDATE_MS)
702 | return;

703
704 lastServoWriteMs = millis();

705
706 | if (!deployed || state != STATE_AUTONAV)
707 | {
708 | servo1Command = SERVO_NEUTRAL;
709 | servo2Command = SERVO_NEUTRAL;
710 | }

711
712 | st.WritePosEx(
713 | SERVO1_ID,
714 | servo1Command,
715 | SERVO_SPEED,
716 | SERVO_ACCEL
717 | );

718
719 | st.WritePosEx(
720 | SERVO2_ID,
721 | servo2Command,
722 | SERVO_SPEED,
723 | SERVO_ACCEL
724 | );
725 | }

726
727 | void checkServoHealth()
728 | {
729 | if (millis() - lastServoHealthMs >= 2000)
730 | {
731 | lastServoHealthMs = millis();

732
733 | servo1OK = (st.Ping(SERVO1_ID) != -1);
734 | servo2OK = (st.Ping(SERVO2_ID) != -1);
735 | }

737 | | if (millis() - lastServoReadMs >= 500)
738 | {
739 | | lastServoReadMs = millis();

740
741 | | servo1Actual = st.ReadPos(SERVO1_ID);
742 | | servo2Actual = st.ReadPos(SERVO2_ID);
743 | }
744 | }

745
746 | bool servoBusOK()
747 | {
748 | | return servo1OK && servo2OK;
749 | }

750
751 | // =====================================================================
752 | // | DEPLOYMENT
753 | // =====================================================================

754
755 | void deployWing()
756 | {
757 | if (deployed)
758 | return;

759
760 | deployed = true;
761 | | deploymentMs = millis();

762
763 | | // R2Home reference behavior:
764 | | // pre-deployment approximately 140 deg, then return to approximately
765 | | // 70 deg after release.
766 | | deployServo.write(DEPLOY_RELEASE_ANGLE);

767
768 | | setSteeringNeutral(true);

769
770 | | Serial.println("*** WING DEPLOYED ***");
771 | }

772
773 | // =====================================================================
774 | // | LAUNCH / LANDING LOGIC
775 | // =====================================================================

776
777 | void updateLaunchAndDescentDetection()
778 | {
779 | | if (state == STATE_ARMED)
780 | {
781 | | if (verticalSpeed >= LAUNCH_ASCENT_VS_MPS)
782 | {
783 | | if (ascentStartMs == 0)
784 | | ascentStartMs = millis();

785
786 | | if (millis() - ascentStartMs >= LAUNCH_CONFIRM_MS)
787 | {
788 | | state = STATE_ASCENT;
789 | | ascentStartMs = 0;
790 | }
791 | }
792 | else
793 | {
794 | ascentStartMs = 0;
795 | }
796 | }

797
798 | | if (state == STATE_ASCENT)
799 | {
800 | | if (verticalSpeed <= DESCENT_VS_MPS)
801 | {
802 | | if (descentStartMs == 0)
803 | | descentStartMs = millis();

804
805 | | if (millis() - descentStartMs >= DESCENT_CONFIRM_MS)
806 | {
807 | | state = STATE_DESCENT;
808 | | descentStartMs = 0;
809 | }
810 | }
811 | else

812 | {
813 | descentStartMs = 0;
814 | }
815 | }

816
817 | | if (state == STATE_DESCENT)
818 | {
819 | | if (relativeAlt <= DEPLOY_ALTITUDE_M && verticalSpeed < 0.0f)
820 | {
821 | deployWing();
822 | | state = STATE_DEPLOY_STABILIZE;
823 | }
824 | }
825 | }

826
827 | void updateLandingDetection()
828 | {
829 | if (!deployed)
830 | return;

831
832 | | if (relativeAlt <= LANDING_ALTITUDE_M &&
833 | | fabsf(verticalSpeed) <= LANDING_MAX_ABS_VS_MPS)
834 | {
835 | | if (landingStartMs == 0)
836 | | landingStartMs = millis();

837
838 | | if (millis() - landingStartMs >= LANDING_CONFIRM_MS)
839 | {
840 | state = STATE_LANDED;
841 | | setSteeringNeutral(true);
842 | }
843 | }
844 | else
845 | {
846 | landingStartMs = 0;
847 | }
848 | }

849
850 | // =====================================================================
851 | // | AUTONOMOUS STATE MACHINE
852 | // =====================================================================

853
854 | void handleStateMachine()
855 | {
856 | switch (state)
857 | {
858 | case STATE_DISARMED:
859 | | setSteeringNeutral(false);
860 | break;

861
862 | case STATE_ARMED:
863 | | setSteeringNeutral(false);
864 | | updateLaunchAndDescentDetection();
865 | break;

866
867 | case STATE_ASCENT:
868 | | setSteeringNeutral(false);
869 | | updateLaunchAndDescentDetection();
870 | break;

871
872 | case STATE_DESCENT:
873 | | setSteeringNeutral(false);
874 | | updateLaunchAndDescentDetection();
875 | break;

876
877 | | case STATE_DEPLOY_STABILIZE:
878 | | setSteeringNeutral(false);

879
880 | | if (millis() - deploymentMs >= DEPLOY_STABILIZE_MS)
881 | {
882 | | if (gpsQualityOK() && targetSet && servoBusOK())
883 | | state = STATE_AUTONAV;
884 | else
885 | | state = STATE_FAILSAFE;
886 | }

887 | break;

888
889 | case STATE_AUTONAV:
890 | if (!targetSet || !gpsQualityOK() || !servoBusOK())
891 | {
892 | state = STATE_FAILSAFE;
893 | setSteeringNeutral(false);
894 | break;
895 | }

896
897 | if (targetDistanceM <= TARGET_CAPTURE_RADIUS_M)
898 | {
899 | state = STATE_CAPTURED;
900 | setSteeringNeutral(false);
901 | break;
902 | }

903
904 | if (targetDistanceM > TARGET_RELEASE_RADIUS_M)
905 | {
906 | state = STATE_AUTONAV;
907 | }
908 | break;

909
910 | case STATE_CAPTURED:
911 | setSteeringNeutral(false);

912
913 | // Allow re-entry if the vehicle drifts back out of the capture
914 | // radius before landing.
915 | if (targetDistanceM > TARGET_RELEASE_RADIUS_M)
916 | {
917 | state = STATE_AUTONAV;
918 | }
919 | break;

920
921 | case STATE_LANDED:
922 | setSteeringNeutral(false);
923 | break;

924
925 | case STATE_FAILSAFE:
926 | setSteeringNeutral(false);

927
928 | // Recover automatically after a stable GPS/servo recovery.
929 | if (deployed && targetSet && gpsQualityOK() && servoBusOK())
930 | {
931 | if (gpsGoodStartMs == 0)
932 | gpsGoodStartMs = millis();

933
934 | if (millis() - gpsGoodStartMs >= 3000)
935 | {
936 | state = STATE_AUTONAV;
937 | gpsGoodStartMs = 0;
938 | }
939 | }
940 | else
941 | {
942 | gpsGoodStartMs = 0;
943 | }
944 | break;
945 | }

946
947 | // Navigation commands are generated only in AUTONAV.
948 | if (state == STATE_AUTONAV)
949 | {
950 | if (millis() - lastNavMs >= 100)
951 | {
952 | lastNavMs = millis();
953 | updateNavigation();
954 | setSteeringFromDemand(steeringDemand);
955 | }
956 | }
957 | else
958 | {
959 | steeringDemand = 0;
960 | }

962 updateLandingDetection();

963
964 | | // Immediate neutral outside autonomous navigation.
965 | | if (state != STATE_AUTONAV)
966 | {
967 | | servo1Command = SERVO_NEUTRAL;
968 | | servo2Command = SERVO_NEUTRAL;
969 | }
970 | }

971
972 | // =====================================================================
973 | // | ARM / DISARM
974 | // =====================================================================

975
976 | bool armSystem()
977 | {
978 | if (!targetSet)
979 | {
980 | | Serial.println("ARM rejected: TARGET not set.");
981 | return false;
982 | }

983
984 | if (!gpsQualityOK())
985 | {
986 | | Serial.println("ARM rejected: GPS quality is not good.");
987 | return false;
988 | }

989
990 | if (!bmpOK)
991 | {
992 | | Serial.println("ARM rejected: BMP581 unavailable.");
993 | return false;
994 | }

995
996 | if (!servoBusOK())
997 | {
998 | | Serial.println("ARM rejected: ST-3009 servos not detected.");
999 | return false;
1000 | }

1001
1002 | | float p = bmp.readPressure();
1003 | | if (!isfinite(p) || p <= 0.0f)
1004 | {
1005 | | Serial.println("ARM rejected: invalid launch pressure.");
1006 | return false;
1007 | }

1008
1009 | launchPressurePa = p;
1010 | baroAltFiltered = 0.0f;
1011 | | baroFilterInitialized = false;
1012 | relativeAlt = 0.0f;
1013 | verticalSpeed = 0.0f;

1014
1015 | deployed = false;
1016 | deploymentMs = 0;
1017 | ascentStartMs = 0;
1018 | descentStartMs = 0;
1019 | landingStartMs = 0;
1020 | gpsGoodStartMs = 0;

1021
1022 | | deployServo.write(DEPLOY_PRELAUNCH_ANGLE);
1023 | setSteeringNeutral(true);

1024
1025 state = STATE_ARMED;

1026
1027 | | Serial.println("SYSTEM ARMED.");
1028 | | Serial.println("Waiting for ascent...");

1029
1030 | return true;
1031 | }

1032
1033 | void disarmSystem()
1034 | {
1035 | state = STATE_DISARMED;
1036 | deployed = false;

1037 | steeringDemand = 0;
1038 | setSteeringNeutral(true);
1039 | deployServo.write(DEPLOY_PRELAUNCH_ANGLE);

1040
1041 | Serial.println("SYSTEM DISARMED.");
1042 | }

1043
1044 | // =====================================================================
1045 | // | SERIAL COMMANDS
1046 | // =====================================================================

1047
1048 | void printHelp()
1049 | {
1050 | Serial.println();
1051 | Serial.println("COMMANDS:");
1052 | Serial.println(" | TARGET,<latitude>,<longitude>");
1053 | Serial.println(" | ARM");
1054 | Serial.println(" | DISARM");
1055 | Serial.println(" | STATUS");
1056 | Serial.println(" | ZERO | (reset launch barometer while disarmed)");
1057 | Serial.println(" | NEUTRAL | (center steering servos)");
1058 | Serial.println(" | HELP");
1059 | Serial.println();
1060 | }

1061
1062 | void printStatus()
1063 | {
1064 | Serial.println();
1065 | Serial.println("================ STATUS ================");
1066 | Serial.print("State | : "); Serial.println(stateName(state));
1067 | Serial.print("Target set | : "); Serial.println(targetSet ? "YES" : "NO");

1068
1069 | if (targetSet)
1070 | {
1071 | Serial.print("Target latitude | : "); Serial.println(targetLat, 7);
1072 | Serial.print("Target longitude | : "); Serial.println(targetLon, 7);
1073 | }

1074
1075 | Serial.print("GPS fix | : "); Serial.println(gpsFix ? "YES" : "NO");
1076 | Serial.print("GPS sats | : "); Serial.println(gpsSats);
1077 | Serial.print("GPS HDOP | : "); Serial.println(gpsHDOP, 2);
1078 | Serial.print("GPS speed | : "); Serial.println(gpsSpeedMps, 2);
1079 | Serial.print("GPS course | : "); Serial.println(gpsCourseDeg, 1);

1080
1081 | Serial.print("Compass heading | : "); Serial.print(compassHeading, 1);
1082 | Serial.print(" deg ("); Serial.print(directionName(compassHeading)); Serial.println(")");
1083 | Serial.print("Baro rel altitude : "); Serial.println(relativeAlt, 2);
1084 | Serial.print("Vertical speed | : "); Serial.println(verticalSpeed, 2);

1085
1086 | Serial.print("Distance to target: "); Serial.println(targetDistanceM, 1);
1087 | Serial.print("Target bearing | : "); Serial.println(targetBearingDeg, 1);
1088 | Serial.print("Current direction : "); Serial.println(currentDirectionDeg, 1);
1089 | Serial.print("Direction source | : "); Serial.println(directionSource);
1090 | Serial.print("Course error | : "); Serial.println(courseErrorDeg, 1);
1091 | Serial.print("Steering demand | : "); Serial.println(steeringDemand);

1092
1093 | Serial.print("Servo 1 command | : "); Serial.println(servo1Command);
1094 | Serial.print("Servo 2 command | : "); Serial.println(servo2Command);
1095 | Serial.print("Servo 1 actual | : "); Serial.println(servo1Actual);
1096 | Serial.print("Servo 2 actual | : "); Serial.println(servo2Actual);

1097
1098 | Serial.print("Deployed | : "); Serial.println(deployed ? "YES" : "NO");
1099 | Serial.print("Servo 1 bus | : "); Serial.println(servo1OK ? "OK" : "FAIL");
1100 | Serial.print("Servo 2 bus | : "); Serial.println(servo2OK ? "OK" : "FAIL");
1101 | Serial.println("========================================");
1102 | }

1103
1104 | void processCommand(char *cmd)
1105 | {
1106 | // Convert command to uppercase only for the command word.
1107 | // TARGET numeric values are left untouched because they are parsed
1108 | // from the remainder of the string.

1109
1110 | if (strncmp(cmd, "TARGET,", 7) == 0)
1111 | {

1112 | char *p = cmd + 7;
1113 | char *comma = strchr(p, ’,’);

1114
1115 | if (comma == NULL)
1116 | {
1117 | Serial.println("Invalid TARGET format.");
1118 | Serial.println("Use: TARGET,latitude,longitude");
1119 | return;
1120 | }

1121
1122 | *comma = ’\0’;

1123
1124 | double newLat = atof(p);
1125 | double newLon = atof(comma + 1);

1126
1127 | if (newLat < -90.0 || newLat > 90.0 ||
1128 | newLon < -180.0 || newLon > 180.0)
1129 | {
1130 | Serial.println("Invalid latitude/longitude range.");
1131 | return;
1132 | }

1133
1134 | targetLat = newLat;
1135 | targetLon = newLon;
1136 | targetSet = true;

1137
1138 | Serial.print("TARGET SET: ");
1139 | Serial.print(targetLat, 7);
1140 | Serial.print(", ");
1141 | Serial.println(targetLon, 7);
1142 | return;
1143 | }

1144
1145 | if (strcmp(cmd, "ARM") == 0)
1146 | {
1147 | armSystem();
1148 | return;
1149 | }

1150
1151 | if (strcmp(cmd, "DISARM") == 0)
1152 | {
1153 | disarmSystem();
1154 | return;
1155 | }

1156
1157 | if (strcmp(cmd, "STATUS") == 0)
1158 | {
1159 | printStatus();
1160 | return;
1161 | }

1162
1163 | if (strcmp(cmd, "ZERO") == 0)
1164 | {
1165 | if (state != STATE_DISARMED)
1166 | {
1167 | Serial.println("ZERO allowed only when DISARMED.");
1168 | return;
1169 | }

1170
1171 | if (bmpOK)
1172 | {
1173 | float p = bmp.readPressure();
1174 | if (isfinite(p) && p > 0.0f)
1175 | {
1176 | launchPressurePa = p;
1177 | relativeAlt = 0.0f;
1178 | baroAltFiltered = 0.0f;
1179 | Serial.println("Barometer zeroed.");
1180 | }
1181 | }
1182 | return;
1183 | }

1184
1185 | if (strcmp(cmd, "NEUTRAL") == 0)
1186 | {

1187 | setSteeringNeutral(true);
1188 | | Serial.println("Steering servos commanded to 2048.");
1189 | return;
1190 | }

1191
1192 | if (strcmp(cmd, "HELP") == 0)
1193 | {
1194 | printHelp();
1195 | return;
1196 | }

1197
1198 | | Serial.print("Unknown command: ");
1199 | Serial.println(cmd);
1200 | }

1201
1202 | void processSerialCommands()
1203 | {
1204 | static char line[100];
1205 | static uint8_t index = 0;

1206
1207 | while (Serial.available())
1208 | {
1209 | char c = Serial.read();

1210
1211 | if (c == ’\r’)
1212 | continue;

1213
1214 | if (c == ’\n’)
1215 | {
1216 | line[index] = ’\0’;

1217
1218 | if (index > 0)
1219 | {
1220 | processCommand(line);
1221 | }

1222
1223 | index = 0;
1224 | }
1225 | else
1226 | {
1227 | | if (index < sizeof(line) - 1)
1228 | {
1229 | line[index++] = c;
1230 | }
1231 | }
1232 | }
1233 | }

1234
1235 | // =====================================================================
1236 | // | SD LOGGING
1237 | // =====================================================================

1238
1239 | void initSD()
1240 | {
1241 | if (!SD.begin(SD_CS))
1242 | {
1243 | sdOK = false;
1244 | return;
1245 | }

1246
1247 sdOK = true;

1248
1249 | if (!SD.exists(LOG_FILE))
1250 | {
1251 | | File f = SD.open(LOG_FILE, FILE_WRITE);

1252
1253 | if (f)
1254 | {
1255 | f.println(
1256 | | "ms,state,targetLat,targetLon,lat,lon,gpsAlt,gpsSpeed,gpsCourse,sats,hdop,"
1257 | | "compass,baroAlt,verticalSpeed,targetDistance,targetBearing,currentDirection,"
1258 | | "directionSource,courseError,steerDemand,servo1Cmd,servo2Cmd,servo1Actual,"
1259 | | "servo2Actual,deployed,ax,ay,az,gx,gy,gz,bmpTemp,pressure"
1260 | );
1261 | f.close();

1262 | }
1263 | }
1264 | }

1265
1266 | void logData()
1267 | {
1268 | if (!sdOK)
1269 | return;

1270
1271 | | if (millis() - lastLogMs < 500)
1272 | return;

1273
1274 lastLogMs = millis();

1275
1276 | | File f = SD.open(LOG_FILE, FILE_WRITE);

1277
1278 | if (!f)
1279 | return;

1280
1281 | | f.print(millis()); f.print(’,’);
1282 | | f.print(stateName(state)); f.print(’,’);
1283 | | f.print(targetLat, 7); f.print(’,’);
1284 | | f.print(targetLon, 7); f.print(’,’);
1285 | | f.print(gpsLat, 7); f.print(’,’);
1286 | | f.print(gpsLon, 7); f.print(’,’);
1287 | | f.print(gpsAlt, 2); f.print(’,’);
1288 | | f.print(gpsSpeedMps, 2); f.print(’,’);
1289 | | f.print(gpsCourseDeg, 2); f.print(’,’);
1290 | | f.print(gpsSats); f.print(’,’);
1291 | | f.print(gpsHDOP, 2); f.print(’,’);
1292 | | f.print(compassHeading, 2); f.print(’,’);
1293 | | f.print(relativeAlt, 2); f.print(’,’);
1294 | | f.print(verticalSpeed, 2); f.print(’,’);
1295 | | f.print(targetDistanceM, 2); f.print(’,’);
1296 | | f.print(targetBearingDeg, 2); f.print(’,’);
1297 | | f.print(currentDirectionDeg, 2); f.print(’,’);
1298 | | f.print(directionSource); f.print(’,’);
1299 | | f.print(courseErrorDeg, 2); f.print(’,’);
1300 | | f.print(steeringDemand); f.print(’,’);
1301 | | f.print(servo1Command); f.print(’,’);
1302 | | f.print(servo2Command); f.print(’,’);
1303 | | f.print(servo1Actual); f.print(’,’);
1304 | | f.print(servo2Actual); f.print(’,’);
1305 | | f.print(deployed ? 1 : 0); f.print(’,’);
1306 | | f.print(ax, 3); f.print(’,’);
1307 | | f.print(ay, 3); f.print(’,’);
1308 | | f.print(az, 3); f.print(’,’);
1309 | | f.print(gx, 2); f.print(’,’);
1310 | | f.print(gy, 2); f.print(’,’);
1311 | | f.print(gz, 2); f.print(’,’);
1312 | | f.print(bmpTemp, 2); f.print(’,’);
1313 | f.println(pressurePa, 1);

1314
1315 | f.close();
1316 | }

1317
1318 | // =====================================================================
1319 | // | SERIAL MONITOR
1320 | // =====================================================================

1321
1322 | void printLiveData()
1323 | {
1324 | | if (millis() - lastPrintMs < 500)
1325 | return;

1326
1327 lastPrintMs = millis();

1328
1329 | Serial.println();
1330 | | Serial.println("----------------------------------------------------------");
1331 | | Serial.print("STATE = "); Serial.println(stateName(state));

1332
1333 | Serial.print("GPS: ");
1334 | if (gpsFix)
1335 | {
1336 | Serial.print(gpsLat, 7);

1337 | Serial.print(", ");
1338 | Serial.print(gpsLon, 7);
1339 | Serial.print(" | Sats=");
1340 | Serial.print(gpsSats);
1341 | Serial.print(" HDOP=");
1342 | Serial.print(gpsHDOP, 1);
1343 | Serial.print(" Speed=");
1344 | Serial.print(gpsSpeedMps, 2);
1345 | Serial.print("m/s Course=");
1346 | Serial.print(gpsCourseDeg, 1);
1347 | Serial.println("deg");
1348 | }
1349 | else
1350 | {
1351 | Serial.println("NO FIX");
1352 | }

1353
1354 | Serial.print("Compass: ");
1355 | if (compassOK)
1356 | {
1357 | Serial.print(compassHeading, 1);
1358 | Serial.println(" deg");
1359 | }
1360 | else
1361 | {
1362 | Serial.println("FAIL");
1363 | }

1364
1365 | Serial.print("Baro: Alt=");
1366 | Serial.print(relativeAlt, 2);
1367 | Serial.print("m VS=");
1368 | Serial.print(verticalSpeed, 2);
1369 | Serial.println("m/s");

1370
1371 | if (targetSet && gpsFix)
1372 | {
1373 | Serial.print("NAV: Bearing=");
1374 | Serial.print(targetBearingDeg, 1);
1375 | Serial.print("deg Distance=");
1376 | Serial.print(targetDistanceM, 1);
1377 | Serial.print("m Current=");
1378 | Serial.print(currentDirectionDeg, 1);
1379 | Serial.print("deg Error=");
1380 | Serial.print(courseErrorDeg, 1);
1381 | Serial.print("deg Source=");
1382 | Serial.println(directionSource);
1383 | }
1384 | else
1385 | {
1386 | Serial.println("NAV: target/GPS not ready");
1387 | }

1388
1389 | Serial.print("Steering: ");
1390 | Serial.print(servo1Command);
1391 | Serial.print(" / ");
1392 | Serial.print(servo2Command);
1393 | Serial.print(" | actual=");
1394 | Serial.print(servo1Actual);
1395 | Serial.print(" / ");
1396 | Serial.println(servo2Actual);

1397
1398 | Serial.print("Deploy=");
1399 | Serial.print(deployed ? "YES" : "NO");
1400 | Serial.print(" | ServoBus=");
1401 | Serial.println(servoBusOK() ? "OK" : "FAIL");

1402
1403 | Serial.println("----------------------------------------------------------");
1404 | }

1405
1406 | // =====================================================================
1407 | // | SETUP
1408 | // =====================================================================

1409
1410 | void setup()
1411 | {

1412 | Serial.begin(115200);
1413 | Serial.setTimeout(20);

1414
1415 delay(1500);

1416
1417 | Serial.println();
1418 | Serial.println("============================================================");
1419 | Serial.println(" | TEENSY 4.1 AUTONOMOUS PARAFOIL CONTROLLER");
1420 | Serial.println("============================================================");

1421
1422 | // ------------------------------ I2C ------------------------------
1423 | Wire.begin();
1424 | Wire.setClock(400000);

1425
1426 Serial.println("I2C: SDA 18 / SCL 19");

1427
1428 | // ---------------------------- Compass ---------------------------
1429 | compassOK = initializeQMC5883();
1430 | Serial.print("QMC5883: ");
1431 | Serial.println(compassOK ? "OK @ 0x0D" : "FAIL");

1432
1433 | // ------------------------------ IMU -----------------------------
1434 | imuOK = initializeIMU();
1435 | Serial.print("LSM6DSO32: ");
1436 | Serial.println(imuOK ? "OK @ 0x6A" : "FAIL");

1437
1438 | // ---------------------------- BMP581 ----------------------------
1439 | bmpOK = initializeBMP();
1440 | Serial.print("BMP581: ");
1441 | Serial.println(bmpOK ? "OK" : "FAIL");

1442
1443 | // ------------------------------- GPS ----------------------------
1444 | GPS_SERIAL.begin(GPS_BAUD);
1445 | Serial.println("GPS: Serial3 @ 115200");
1446 | Serial.println(" | GPS TX -> pin 15 / RX3");
1447 | Serial.println(" | GPS RX -> pin 14 / TX3");

1448
1449 | // ------------------------------ Servo ---------------------------
1450 | Serial1.begin(1000000, SERIAL_8N1_HALF_DUPLEX);
1451 | st.pSerial = &Serial1;

1452
1453 delay(1000);

1454
1455 | servo1OK = (st.Ping(SERVO1_ID) != -1);
1456 | servo2OK = (st.Ping(SERVO2_ID) != -1);

1457
1458 | Serial.print("ST-3009 ID1: ");
1459 | Serial.println(servo1OK ? "FOUND" : "NOT FOUND");

1460
1461 | Serial.print("ST-3009 ID2: ");
1462 | Serial.println(servo2OK ? "FOUND" : "NOT FOUND");

1463
1464 setSteeringNeutral(true);

1465
1466 | // -------------------------- Deploy servo ------------------------
1467 | deployServo.attach(DEPLOY_SERVO_PIN);
1468 | deployServo.write(DEPLOY_PRELAUNCH_ANGLE);
1469 | Serial.print("SG90 deploy pin: ");
1470 | Serial.println(DEPLOY_SERVO_PIN);

1471
1472 | // ------------------------------- SD -----------------------------
1473 | initSD();
1474 | Serial.print("SD logging: ");
1475 | Serial.println(sdOK ? "OK" : "FAIL");

1476
1477 | // ---------------------------- Watchdog --------------------------
1478 | watchdog.enable(Watchdog::TIMEOUT_2S);

1479
1480 | // ------------------------------ Info ----------------------------
1481 | Serial.println();
1482 | Serial.println("SYSTEM STARTED DISARMED");
1483 | Serial.println();
1484 | printHelp();
1485 | }

1487 | // =====================================================================
1488 | // | LOOP
1489 | // =====================================================================

1490
1491 | void loop()
1492 | {
1493 | // Keep serial parsing responsive.
1494 | processSerialCommands();

1495
1496 | // GPS must be serviced continuously.
1497 | updateGPS();

1498
1499 | // Sensors at approximately 100 Hz.
1500 | if (millis() - lastSensorMs >= 10)
1501 | {
1502 | lastSensorMs = millis();

1503
1504 | compassOK = updateCompass();
1505 | updateIMU();
1506 | updateBMP();
1507 | }

1508
1509 | // Navigation/flight-state logic.
1510 | updateLaunchAndDescentDetection();
1511 | handleStateMachine();

1512
1513 | // Servo bus health / encoder positions.
1514 | checkServoHealth();

1515
1516 | // In an active flight, losing both servos immediately forces neutral.
1517 | if (deployed && state == STATE_AUTONAV && !servoBusOK())
1518 | {
1519 | state = STATE_FAILSAFE;
1520 | setSteeringNeutral(true);
1521 | Serial.println("FAILSAFE: SERVO BUS FAULT");
1522 | }

1523
1524 updateServos();

1525
1526 | logData();
1527 | printLiveData();

1528
1529 | watchdog.reset();
1530 | }
A.2 | Archived source 2: Autonomous_Parafoil_Teensy41_FINAL_WDT_T4.ino

## Source file: Autonomous_Parafoil_Teensy41_FINAL_WDT_T4.ino

1 | /*
2 | =====================================================================
3 | TEENSY 4.1 AUTONOMOUS PARAFOIL / TARGETED-LANDING SYSTEM
4 | =====================================================================

5
6 | REFERENCE USED:
7 | R2Home_rls_V0_9

8
9 | CURRENT HARDWARE:
10 | MCU | : Teensy 4.1
11 | GPS | : Foxeer M10Q 180 GPS + QMC5883 Compass
12 | Compass | : QMC5883 @ 0x0D
13 | IMU | : LSM6DSO32 @ 0x6A
14 | Barometer : BMP581 @ 0x46 / 0x47
15 | Servos | : 2 x ST-3009 serial bus TTL servos
16 | | Servo 1 = ID 1
17 | | Servo 2 = ID 2
18 | Deploy | : SG90
19 | SD | : Teensy 4.1 BUILTIN_SDCARD

20
21 | UARTS:
22 | Serial1 | : ST-3009 half-duplex servo bus
23 | | TX1 = pin 1, RX1 = pin 0
24 | Serial3 | : Foxeer GPS

25 | GPS TX -> pin 15 / RX3
26 | GPS RX -> pin 14 / TX3

27
28 | I2C:
29 | SDA = pin 18
30 | SCL = pin 19

31
32 | IMPORTANT:
33 | - System starts DISARMED.
34 | - Steering stays neutral until the wing is deployed.
35 | - TARGET,<lat>,<lon> sets the target.
36 | - ARM starts autonomous flight-state detection.
37 | - Deployment occurs at DEPLOY_ALTITUDE_M above the launch
38 | barometric level while descending.
39 | - The final left/right mechanical steering sign MUST be verified
40 | with the real parafoil/linkage. That mapping cannot be proven
41 | from bench servo rotation alone.

42
43 | =====================================================================
44 | */

45
46 | #include <Wire.h>
47 | #include <math.h>
48 | #include <string.h>
49 | #include <stdio.h>
50 | #include <stdlib.h>

51
52 | #include <TinyGPSPlus.h>
53 | #include <Adafruit_LSM6DSOX.h>
54 | #include <Adafruit_BMP5xx.h>
55 | #include <SCServo.h>
56 | #include <Servo.h>
57 | #include <SD.h>
58 | // Optional Teensy 4.x hardware watchdog.
59 | // Install "Watchdog_t4" from Arduino Library Manager.
60 | #if __has_include(<Watchdog_t4.h>)
61 | #include <Watchdog_t4.h>
62 | #define HAVE_WATCHDOG_T4 1
63 | WDT_T4<WDT1> watchdog;
64 | #else
65 | #define HAVE_WATCHDOG_T4 0
66 | #endif

67
68 | // =====================================================================
69 | // | USER CONFIGURATION
70 | // =====================================================================

71
72 | // ----------------------------- GPS ---------------------------------
73 | #define GPS_SERIAL Serial3
74 | #define GPS_BAUD 115200

75
76 | // ----------------------------- I2C ---------------------------------
77 | #define QMC5883_ADDR | 0x0D
78 | #define LSM6DSO32_ADDR 0x6A
79 | #define BMP_ADDR_1 | 0x46
80 | #define BMP_ADDR_2 | 0x47

81
82 | // ----------------------------- GPS PINS -----------------------------
83 | // Foxeer TX -> Teensy Pin 15 / RX3
84 | // Foxeer RX -> Teensy Pin 14 / TX3

85
86 | // ----------------------------- SERVO -------------------------------
87 | #define SERVO1_ID 1
88 | #define SERVO2_ID 2

89
90 | // ST-3009 position range used by your tested library/code
91 | const int SERVO_NEUTRAL = 2048;
92 | const int SERVO_MIN_POS = 200;
93 | const int SERVO_MAX_POS = 3895;

94
95 | // Maximum steering displacement from neutral.
96 | // 450 counts is about 39.6 degrees of encoder travel.
97 | const int MAX_STEER_COUNTS = 450;

98
99 // Target-bearing error that produces full steering.

100 const float FULL_STEER_ERROR_DEG = 90.0f;

101
102 | // Do not react aggressively to tiny GPS/heading errors.
103 | const float HEADING_DEADBAND_DEG = 5.0f;

104
105 | // GPS course is used when there is enough ground speed.
106 | const float GPS_COURSE_MIN_SPEED_MPS = 1.5f;

107
108 | // GPS navigation quality limits
109 | const uint32_t GPS_DATA_TIMEOUT_MS = 1500;
110 | const uint8_t | GPS_MIN_SATS = 5;
111 | const float | GPS_MAX_HDOP = 3.5f;

112
113 | // ------------------------ STEERING MAPPING --------------------------
114 | //
115 | // Positive steer means the target is to the RIGHT of the current
116 | // direction. With the default mapping:
117 | // | positive steer -> Servo 1 lower, Servo 2 higher
118 | // | negative steer -> Servo 1 higher, Servo 2 lower
119 | //
120 | // Change TURN_SIGN to -1 after mechanical testing if the parafoil
121 | // turns in the opposite direction.
122 | //
123 | const int TURN_SIGN = 1;

124
125 | // Individual servo direction reversal options.
126 | // The servos themselves were verified as:
127 | // lower position -> CCW
128 | // higher position -> CW
129 | //
130 | // These flags are for the actual linkage/mounting geometry.
131 | const bool SERVO1_REVERSE = false;
132 | const bool SERVO2_REVERSE = false;

133
134 | // Servo command rate
135 | const uint32_t SERVO_UPDATE_MS = 100;

136
137 | // Servo movement settings from your working ST-3009 tests
138 | const int SERVO_SPEED = 500;
139 | const int SERVO_ACCEL = 50;

140
141 | // -------------------------- DEPLOYMENT ------------------------------
142 | // R2Home reference used a PWM command corresponding to about 140 deg
143 | // before release and about 70 deg after release.
144 | #define DEPLOY_SERVO_PIN 8
145 | const int DEPLOY_PRELAUNCH_ANGLE = 140;
146 | const int DEPLOY_RELEASE_ANGLE | = 70;

147
148 | // Required deployment point above launch level.
149 | const float DEPLOY_ALTITUDE_M = 600.0f;

150
151 | // Wait for the parafoil to inflate/stabilize before steering.
152 | const uint32_t DEPLOY_STABILIZE_MS = 5000;

153
154 | // ------------------------- FLIGHT DETECTION -------------------------
155 | const float LAUNCH_ASCENT_VS_MPS = 1.0f;
156 | const uint32_t LAUNCH_CONFIRM_MS = 1000;

157
158 | const float DESCENT_VS_MPS = -0.5f;
159 | const uint32_t DESCENT_CONFIRM_MS = 1000;

160
161 | // --------------------------- LANDING -------------------------------
162 | const float LANDING_ALTITUDE_M = 12.0f;
163 | const float LANDING_MAX_ABS_VS_MPS = 0.6f;
164 | const uint32_t LANDING_CONFIRM_MS = 6000;

165
166 | // Target capture / final approach
167 | const float TARGET_CAPTURE_RADIUS_M = 35.0f;
168 | const float TARGET_RELEASE_RADIUS_M = 60.0f;

169
170 | // Reduce steering authority near the ground.
171 | const float FINAL_APPROACH_ALT_M = 120.0f;
172 | const float FINAL_STEER_SCALE = 0.70f;

173
174 // -------------------------- COMPASS --------------------------------

175 | // Your existing compass code is used exactly for the numeric heading.
176 | // Leave this at 0 unless a fixed installation offset is measured.
177 | const float COMPASS_HEADING_OFFSET_DEG = 0.0f;
178 | // Your earlier 360-degree test showed the compass angle changed in the
179 | // opposite rotational sense to a normal clockwise compass heading.
180 | // Keep the tested raw code, but mirror the numeric heading for navigation
181 | // so GNSS true-course and compass fallback use the same clockwise frame.
182 | const bool COMPASS_MIRROR_FOR_NAV = true;

183
184 | // Your existing calibration values
185 | const float OFFSET_X = 180.0000f;
186 | const float OFFSET_Y = 336.0000f;
187 | const float OFFSET_Z = 615.0000f;

188
189 | const float SCALE_X = 0.956484f;
190 | const float SCALE_Y = 0.904406f;
191 | const float SCALE_Z = 1.178127f;

192
193 | // ------------------------- BAROMETER -------------------------------
194 | // Relative altitude is computed from the pressure captured at ARM.
195 | const float BARO_EXPONENT = 0.19029496f;

196
197 | // ------------------------------ SD ---------------------------------
198 | const int SD_CS = BUILTIN_SDCARD;
199 | const char *LOG_FILE = "AUTONAV.CSV";

200
201 | // =====================================================================
202 | // | OBJECTS / GLOBALS
203 | // =====================================================================

204
205 | TinyGPSPlus gps;
206 | Adafruit_LSM6DSOX lsm6dso;
207 | Adafruit_BMP5xx bmp;
208 | SMS_STS st;
209 | Servo deployServo;

210
211 | bool compassOK = false;
212 | bool imuOK = false;
213 | bool bmpOK = false;
214 | bool servo1OK = false;
215 | bool servo2OK = false;
216 | bool sdOK = false;

217
218 | // ------------------------------ Target ------------------------------
219 | double targetLat = 0.0;
220 | double targetLon = 0.0;
221 | bool targetSet = false;

222
223 | // ------------------------------- GPS -------------------------------
224 | double gpsLat = 0.0;
225 | double gpsLon = 0.0;
226 | double gpsAlt = 0.0;
227 | double gpsSpeedMps = 0.0;
228 | double gpsCourseDeg = 0.0;
229 | uint32_t gpsSats = 0;
230 | double gpsHDOP = 99.9;
231 | bool gpsFix = false;
232 | uint32_t lastGPSLocationMs = 0;

233
234 | // ----------------------------- Compass -----------------------------
235 | int16_t rawX = 0;
236 | int16_t rawY = 0;
237 | int16_t rawZ = 0;
238 | float magX = 0.0f;
239 | float magY = 0.0f;
240 | float magZ = 0.0f;
241 | float compassHeading = 0.0f;
242 | uint8_t compassReadFailCount = 0;
243 | uint32_t lastCompassRetryMs = 0;

244
245 | // ------------------------------- IMU -------------------------------
246 | float ax = 0.0f;
247 | float ay = 0.0f;
248 | float az = 0.0f;
249 | float gx = 0.0f;

250 | float gy = 0.0f;
251 | float gz = 0.0f;
252 | float imuTemp = 0.0f;

253
254 | // ----------------------------- BMP581 ------------------------------
255 | float pressurePa = 0.0f;
256 | float bmpTemp = 0.0f;
257 | float baroAltRaw = 0.0f;
258 | float baroAltFiltered = 0.0f;
259 | float relativeAlt = 0.0f;
260 | float verticalSpeed = 0.0f;
261 | float launchPressurePa = 0.0f;
262 | bool baroFilterInitialized = false;
263 | uint32_t lastBaroAltitudeMs = 0;
264 | float lastBaroAltitude = 0.0f;

265
266 | // -------------------------- Navigation -----------------------------
267 | double targetDistanceM = 0.0;
268 | double targetBearingDeg = 0.0;
269 | float currentDirectionDeg = 0.0f;
270 | float courseErrorDeg = 0.0f;
271 | int steeringDemand = 0;
272 | char directionSource[8] = "NONE";

273
274 | // ----------------------------- Servos ------------------------------
275 | int servo1Command = SERVO_NEUTRAL;
276 | int servo2Command = SERVO_NEUTRAL;
277 | int servo1Actual = -1;
278 | int servo2Actual = -1;
279 | uint32_t lastServoWriteMs = 0;
280 | uint32_t lastServoHealthMs = 0;
281 | uint32_t lastServoReadMs = 0;

282
283 | // --------------------------- Deployment ----------------------------
284 | bool deployed = false;
285 | uint32_t deploymentMs = 0;

286
287 | // ------------------------- State machine ---------------------------
288 | enum FlightState
289 | {
290 | STATE_DISARMED = 0,
291 | STATE_ARMED = 1,
292 | STATE_ASCENT = 2,
293 | STATE_DESCENT = 3,
294 | STATE_DEPLOY_STABILIZE = 4,
295 | STATE_AUTONAV = 5,
296 | STATE_CAPTURED = 6,
297 | STATE_LANDED = 7,
298 | STATE_FAILSAFE = 8
299 | };

300
301 | FlightState state = STATE_DISARMED;
302 | FlightState previousState = STATE_DISARMED;

303
304 | uint32_t ascentStartMs = 0;
305 | uint32_t descentStartMs = 0;
306 | uint32_t landingStartMs = 0;
307 | uint32_t gpsGoodStartMs = 0;

308
309 | // ------------------------------ Timers -----------------------------
310 | uint32_t lastSensorMs = 0;
311 | uint32_t lastPrintMs = 0;
312 | uint32_t lastLogMs = 0;
313 | uint32_t lastNavMs = 0;

314
315 | // =====================================================================
316 | // | HELPER FUNCTIONS
317 | // =====================================================================

318
319 | float wrap360(float a)
320 | {
321 | | while (a < 0.0f) a += 360.0f;
322 | | while (a >= 360.0f) a -= 360.0f;
323 | return a;
324 | }

325
326 | float wrap180(float a)
327 | {
328 | while (a > 180.0f) a -= 360.0f;
329 | while (a <= -180.0f) a += 360.0f;
330 | return a;
331 | }

332
333 | int clampServoPosition(int p)
334 | {
335 | if (p < SERVO_MIN_POS) return SERVO_MIN_POS;
336 | if (p > SERVO_MAX_POS) return SERVO_MAX_POS;
337 | return p;
338 | }

339
340 | const char* stateName(FlightState s)
341 | {
342 | switch (s)
343 | {
344 | case STATE_DISARMED: | return "DISARMED";
345 | case STATE_ARMED: | return "ARMED";
346 | case STATE_ASCENT: | return "ASCENT";
347 | case STATE_DESCENT: | return "DESCENT";
348 | case STATE_DEPLOY_STABILIZE: return "DEPLOY_STAB";
349 | case STATE_AUTONAV: | return "AUTONAV";
350 | case STATE_CAPTURED: | return "CAPTURED";
351 | case STATE_LANDED: | return "LANDED";
352 | case STATE_FAILSAFE: | return "FAILSAFE";
353 | default: | return "UNKNOWN";
354 | }
355 | }

356
357 | bool gpsQualityOK()
358 | {
359 | if (!gpsFix) return false;
360 | if ((millis() - lastGPSLocationMs) > GPS_DATA_TIMEOUT_MS) return false;
361 | if (gpsSats < GPS_MIN_SATS) return false;
362 | if (gps.hdop.isValid() && gpsHDOP > GPS_MAX_HDOP) return false;
363 | return true;
364 | }

365
366 | // =====================================================================
367 | // | QMC5883 COMPASS
368 | // | EXACT WORKING IMPLEMENTATION STYLE
369 | // =====================================================================

370
371 | void writeRegister(byte reg, byte value)
372 | {
373 | Wire.beginTransmission(QMC5883_ADDR);
374 | Wire.write(reg);
375 | Wire.write(value);
376 | Wire.endTransmission();
377 | }

378
379 | bool readQMC5883(int16_t &x, int16_t &y, int16_t &z)
380 | {
381 | Wire.beginTransmission(QMC5883_ADDR);
382 | Wire.write(0x00);

383
384 | if (Wire.endTransmission(false) != 0)
385 | return false;

386
387 Wire.requestFrom(QMC5883_ADDR, 6);

388
389 | if (Wire.available() < 6)
390 | return false;

391
392 | uint8_t xl = Wire.read();
393 | uint8_t xh = Wire.read();
394 | uint8_t yl = Wire.read();
395 | uint8_t yh = Wire.read();
396 | uint8_t zl = Wire.read();
397 | uint8_t zh = Wire.read();

398
399 x = (int16_t)((xh << 8) | xl);

400 | y = (int16_t)((yh << 8) | yl);
401 | z = (int16_t)((zh << 8) | zl);

402
403 | return true;
404 | }

405
406 | bool initializeQMC5883()
407 | {
408 | | Wire.beginTransmission(QMC5883_ADDR);

409
410 | | if (Wire.endTransmission() != 0)
411 | return false;

412
413 | | // Same initialization as your verified compass code.
414 | writeRegister(0x0B, 0x01);
415 | delay(10);
416 | writeRegister(0x09, 0x1D);
417 | delay(100);

418
419 | return true;
420 | }

421
422 | bool updateCompass()
423 | {
424 | | if (!readQMC5883(rawX, rawY, rawZ))
425 | return false;

426
427 | magX = (rawX - OFFSET_X) * SCALE_X;
428 | magY = (rawY - OFFSET_Y) * SCALE_Y;
429 | magZ = (rawZ - OFFSET_Z) * SCALE_Z;

430
431 | | // This is the exact numeric calculation from your proven compass test.
432 | | float angle = atan2(magY, magX) * 180.0f / PI;

433
434 | if (angle < 0.0f)
435 | angle += 360.0f;

436
437 | | compassHeading = wrap360(angle + COMPASS_HEADING_OFFSET_DEG);

438
439 | return true;
440 | }

441
442 | float navigationCompassHeading()
443 | {
444 | if (COMPASS_MIRROR_FOR_NAV)
445 | | return wrap360(360.0f - compassHeading);

446
447 | return compassHeading;
448 | }

449
450 | // Same direction labels as your verified compass test. The numeric
451 | // heading used by navigation is unaffected by these display labels.
452 | const char* directionName(float h)
453 | {
454 | | if (h >= 337.5f || h < 22.5f) return "NORTH";
455 | | if (h < 67.5f) return "NORTH-EAST";
456 | if (h < 112.5f) return "WEST";
457 | | if (h < 157.5f) return "SOUTH-EAST";
458 | | if (h < 202.5f) return "SOUTH";
459 | | if (h < 247.5f) return "SOUTH-WEST";
460 | if (h < 292.5f) return "EAST";
461 | return "NORTH-WEST";
462 | }

463
464 | // =====================================================================
465 | // | IMU
466 | // =====================================================================

467
468 | bool initializeIMU()
469 | {
470 | | if (!lsm6dso.begin_I2C(LSM6DSO32_ADDR, &Wire))
471 | return false;

472
473 | | // Same ranges/data rates as your known working sensor code.
474 | | lsm6dso.setAccelRange(LSM6DS_ACCEL_RANGE_16_G);

475 | | lsm6dso.setGyroRange(LSM6DS_GYRO_RANGE_2000_DPS);
476 | | lsm6dso.setAccelDataRate(LSM6DS_RATE_208_HZ);
477 | | lsm6dso.setGyroDataRate(LSM6DS_RATE_208_HZ);

478
479 | return true;
480 | }

481
482 | void updateIMU()
483 | {
484 | if (!imuOK) return;

485
486 | sensors_event_t accel;
487 | sensors_event_t gyro;
488 | sensors_event_t temp;

489
490 | | lsm6dso.getEvent(&accel, &gyro, &temp);

491
492 | | ax = accel.acceleration.x / 9.80665f;
493 | | ay = accel.acceleration.y / 9.80665f;
494 | | az = accel.acceleration.z / 9.80665f;

495
496 | | gx = gyro.gyro.x * 57.2957795f;
497 | | gy = gyro.gyro.y * 57.2957795f;
498 | | gz = gyro.gyro.z * 57.2957795f;

499
500 | imuTemp = temp.temperature;
501 | }

502
503 | // =====================================================================
504 | // | BMP581
505 | // =====================================================================

506
507 | bool initializeBMP()
508 | {
509 | | if (bmp.begin(BMP_ADDR_1, &Wire))
510 | return true;

511
512 | | if (bmp.begin(BMP_ADDR_2, &Wire))
513 | return true;

514
515 | return false;
516 | }

517
518 | float pressureToRelativeAltitude(float p)
519 | {
520 | | if (!isfinite(p) || p <= 0.0f || launchPressurePa <= 0.0f)
521 | return 0.0f;

522
523 | return 44330.0f *
524 | | (1.0f - powf(p / launchPressurePa, BARO_EXPONENT));
525 | }

526
527 | void updateBMP()
528 | {
529 | if (!bmpOK) return;

530
531 | | float p = bmp.readPressure();
532 | | float t = bmp.readTemperature();

533
534 | | if (!isfinite(p) || !isfinite(t) || p <= 0.0f)
535 | return;

536
537 | pressurePa = p;
538 | bmpTemp = t;
539 | | baroAltRaw = pressureToRelativeAltitude(p);

540
541 | | // Slow filter to reduce pressure noise.
542 | if (!baroFilterInitialized)
543 | {
544 | | baroAltFiltered = baroAltRaw;
545 | | baroFilterInitialized = true;
546 | | relativeAlt = baroAltFiltered;
547 | | lastBaroAltitude = relativeAlt;
548 | | lastBaroAltitudeMs = millis();
549 | verticalSpeed = 0.0f;

550 | return;
551 | }
552 | else
553 | {
554 | | const float ALT_ALPHA = 0.25f;
555 | | baroAltFiltered += ALT_ALPHA * (baroAltRaw - baroAltFiltered);
556 | }

557
558 | | relativeAlt = baroAltFiltered;

559
560 | | // Calculate vertical speed from filtered relative altitude.
561 | uint32_t now = millis();
562 | | uint32_t dtMs = now - lastBaroAltitudeMs;

563
564 | | if (dtMs >= 20 && dtMs <= 1000)
565 | {
566 | | float dt = dtMs * 0.001f;
567 | | float instantVS = (relativeAlt - lastBaroAltitude) / dt;

568
569 | | // Low-pass the derivative to suppress barometric noise.
570 | | const float VS_ALPHA = 0.20f;
571 | | verticalSpeed += VS_ALPHA * (instantVS - verticalSpeed);

572
573 | | lastBaroAltitude = relativeAlt;
574 | | lastBaroAltitudeMs = now;
575 | }
576 | }

577
578 | // =====================================================================
579 | // | GPS
580 | // =====================================================================

581
582 | void updateGPS()
583 | {
584 | | while (GPS_SERIAL.available())
585 | | gps.encode(GPS_SERIAL.read());

586
587 | | // Update the timestamp only when a NEW position sentence has been
588 | | // decoded. This makes the GPS timeout a real communication timeout.
589 | | if (gps.location.isUpdated())
590 | {
591 | | gpsLat = gps.location.lat();
592 | | gpsLon = gps.location.lng();
593 | | lastGPSLocationMs = millis();
594 | }

595
596 | | gpsFix = gps.location.isValid();

597
598 | | if (gps.altitude.isValid())
599 | | gpsAlt = gps.altitude.meters();

600
601 | if (gps.speed.isValid())
602 | | gpsSpeedMps = gps.speed.mps();

603
604 | | if (gps.course.isValid())
605 | | gpsCourseDeg = gps.course.deg();

606
607 | | if (gps.satellites.isValid())
608 | | gpsSats = gps.satellites.value();

609
610 | if (gps.hdop.isValid())
611 | | gpsHDOP = gps.hdop.hdop();
612 | }

613
614 | // =====================================================================
615 | // | NAVIGATION CALCULATION
616 | // =====================================================================

617
618 | void updateNavigation()
619 | {
620 | | if (!targetSet || !gpsFix)
621 | {
622 | targetDistanceM = 0.0;
623 | | targetBearingDeg = 0.0;
624 | courseErrorDeg = 0.0f;

625 | steeringDemand = 0;
626 | strcpy(directionSource, "NONE");
627 | return;
628 | }

629
630 | targetDistanceM = TinyGPSPlus::distanceBetween(
631 | gpsLat,
632 | gpsLon,
633 | targetLat,
634 | targetLon
635 | );

636
637 | targetBearingDeg = TinyGPSPlus::courseTo(
638 | gpsLat,
639 | gpsLon,
640 | targetLat,
641 | targetLon
642 | );

643
644 | bool gpsCourseUsable =
645 | gpsQualityOK() &&
646 | gps.course.isValid() &&
647 | gpsSpeedMps >= GPS_COURSE_MIN_SPEED_MPS;

648
649 | if (gpsCourseUsable)
650 | {
651 | currentDirectionDeg = wrap360((float)gpsCourseDeg);
652 | strcpy(directionSource, "GPS");
653 | }
654 | else if (compassOK)
655 | {
656 | currentDirectionDeg = navigationCompassHeading();
657 | strcpy(directionSource, "COMPASS");
658 | }
659 | else
660 | {
661 | steeringDemand = 0;
662 | courseErrorDeg = 0.0f;
663 | strcpy(directionSource, "NONE");
664 | return;
665 | }

666
667 | courseErrorDeg = wrap180(
668 | (float)targetBearingDeg - currentDirectionDeg
669 | );

670
671 float absError = fabsf(courseErrorDeg);

672
673 | if (absError <= HEADING_DEADBAND_DEG)
674 | {
675 | steeringDemand = 0;
676 | return;
677 | }

678
679 | float normalized = absError / FULL_STEER_ERROR_DEG;
680 | if (normalized > 1.0f) normalized = 1.0f;

681
682 float demand = normalized * MAX_STEER_COUNTS;

683
684 | // Positive error = target to the right.
685 | if (courseErrorDeg > 0.0f)
686 | demand = fabsf(demand);
687 | else
688 | demand = -fabsf(demand);

689
690 demand *= TURN_SIGN;

691
692 | // Reduce authority during final low-altitude approach.
693 | if (relativeAlt < FINAL_APPROACH_ALT_M)
694 | demand *= FINAL_STEER_SCALE;

695
696 steeringDemand = (int)roundf(demand);

697
698 | // Capture zone: stop aggressive steering inside the target radius.
699 | if (targetDistanceM <= TARGET_CAPTURE_RADIUS_M)

700 | {
701 | steeringDemand = 0;
702 | }
703 | }

704
705 | // =====================================================================
706 | // | SERVO CONTROL
707 | // =====================================================================

708
709 | int applyReverse(int position, bool reverse)
710 | {
711 | if (!reverse)
712 | return position;

713
714 | | return SERVO_NEUTRAL - (position - SERVO_NEUTRAL);
715 | }

716
717 | void setSteeringNeutral(bool immediate = false)
718 | {
719 | | servo1Command = SERVO_NEUTRAL;
720 | | servo2Command = SERVO_NEUTRAL;

721
722 | if (immediate)
723 | {
724 | | st.WritePosEx(SERVO1_ID, servo1Command, SERVO_SPEED, SERVO_ACCEL);
725 | | st.WritePosEx(SERVO2_ID, servo2Command, SERVO_SPEED, SERVO_ACCEL);
726 | }
727 | }

728
729 | void setSteeringFromDemand(int demand)
730 | {
731 | | demand = constrain(demand, -MAX_STEER_COUNTS, MAX_STEER_COUNTS);

732
733 | | // Default differential-brake mapping:
734 | | // demand > 0: Servo 1 lower, Servo 2 higher
735 | | int s1 = SERVO_NEUTRAL - demand;
736 | | int s2 = SERVO_NEUTRAL + demand;

737
738 | | s1 = applyReverse(s1, SERVO1_REVERSE);
739 | | s2 = applyReverse(s2, SERVO2_REVERSE);

740
741 | | servo1Command = clampServoPosition(s1);
742 | | servo2Command = clampServoPosition(s2);
743 | }

744
745 | void updateServos()
746 | {
747 | | if (millis() - lastServoWriteMs < SERVO_UPDATE_MS)
748 | return;

749
750 | | lastServoWriteMs = millis();

751
752 | | if (!deployed || state != STATE_AUTONAV)
753 | {
754 | | servo1Command = SERVO_NEUTRAL;
755 | | servo2Command = SERVO_NEUTRAL;
756 | }

757
758 | st.WritePosEx(
759 | SERVO1_ID,
760 | servo1Command,
761 | SERVO_SPEED,
762 | SERVO_ACCEL
763 | );

764
765 | st.WritePosEx(
766 | SERVO2_ID,
767 | servo2Command,
768 | SERVO_SPEED,
769 | SERVO_ACCEL
770 | );
771 | }

772
773 | void checkServoHealth()
774 | {

775 | | if (millis() - lastServoHealthMs >= 2000)
776 | {
777 | | lastServoHealthMs = millis();

778
779 | | servo1OK = (st.Ping(SERVO1_ID) != -1);
780 | | servo2OK = (st.Ping(SERVO2_ID) != -1);
781 | }

782
783 | | if (millis() - lastServoReadMs >= 500)
784 | {
785 | | lastServoReadMs = millis();

786
787 | | servo1Actual = st.ReadPos(SERVO1_ID);
788 | | servo2Actual = st.ReadPos(SERVO2_ID);
789 | }
790 | }

791
792 | bool servoBusOK()
793 | {
794 | | return servo1OK && servo2OK;
795 | }

796
797 | // =====================================================================
798 | // | DEPLOYMENT
799 | // =====================================================================

800
801 | void deployWing()
802 | {
803 | if (deployed)
804 | return;

805
806 | deployed = true;
807 | | deploymentMs = millis();

808
809 | | // R2Home reference behavior:
810 | | // pre-deployment approximately 140 deg, then return to approximately
811 | | // 70 deg after release.
812 | | deployServo.write(DEPLOY_RELEASE_ANGLE);

813
814 | | setSteeringNeutral(true);

815
816 | | Serial.println("*** WING DEPLOYED ***");
817 | }

818
819 | // =====================================================================
820 | // | LAUNCH / LANDING LOGIC
821 | // =====================================================================

822
823 | void updateLaunchAndDescentDetection()
824 | {
825 | | if (state == STATE_ARMED)
826 | {
827 | | if (verticalSpeed >= LAUNCH_ASCENT_VS_MPS)
828 | {
829 | | if (ascentStartMs == 0)
830 | | ascentStartMs = millis();

831
832 | | if (millis() - ascentStartMs >= LAUNCH_CONFIRM_MS)
833 | {
834 | | state = STATE_ASCENT;
835 | | ascentStartMs = 0;
836 | }
837 | }
838 | else
839 | {
840 | ascentStartMs = 0;
841 | }
842 | }

843
844 | | if (state == STATE_ASCENT)
845 | {
846 | | if (verticalSpeed <= DESCENT_VS_MPS)
847 | {
848 | | if (descentStartMs == 0)
849 | | descentStartMs = millis();

850
851 | | if (millis() - descentStartMs >= DESCENT_CONFIRM_MS)
852 | {
853 | | state = STATE_DESCENT;
854 | descentStartMs = 0;
855 | }
856 | }
857 | else
858 | {
859 | descentStartMs = 0;
860 | }
861 | }

862
863 | | if (state == STATE_DESCENT)
864 | {
865 | | if (relativeAlt <= DEPLOY_ALTITUDE_M && verticalSpeed < 0.0f)
866 | {
867 | deployWing();
868 | | state = STATE_DEPLOY_STABILIZE;
869 | }
870 | }
871 | }

872
873 | void updateLandingDetection()
874 | {
875 | if (!deployed)
876 | return;

877
878 | | if (relativeAlt <= LANDING_ALTITUDE_M &&
879 | | fabsf(verticalSpeed) <= LANDING_MAX_ABS_VS_MPS)
880 | {
881 | | if (landingStartMs == 0)
882 | | landingStartMs = millis();

883
884 | | if (millis() - landingStartMs >= LANDING_CONFIRM_MS)
885 | {
886 | state = STATE_LANDED;
887 | | setSteeringNeutral(true);
888 | }
889 | }
890 | else
891 | {
892 | landingStartMs = 0;
893 | }
894 | }

895
896 | // =====================================================================
897 | // | AUTONOMOUS STATE MACHINE
898 | // =====================================================================

899
900 | void handleStateMachine()
901 | {
902 | switch (state)
903 | {
904 | case STATE_DISARMED:
905 | | setSteeringNeutral(false);
906 | break;

907
908 | case STATE_ARMED:
909 | | setSteeringNeutral(false);
910 | | updateLaunchAndDescentDetection();
911 | break;

912
913 | case STATE_ASCENT:
914 | | setSteeringNeutral(false);
915 | | updateLaunchAndDescentDetection();
916 | break;

917
918 | case STATE_DESCENT:
919 | | setSteeringNeutral(false);
920 | | updateLaunchAndDescentDetection();
921 | break;

922
923 | | case STATE_DEPLOY_STABILIZE:
924 | | setSteeringNeutral(false);

925
926 | if (millis() - deploymentMs >= DEPLOY_STABILIZE_MS)
927 | {
928 | if (gpsQualityOK() && targetSet && servoBusOK())
929 | state = STATE_AUTONAV;
930 | else
931 | state = STATE_FAILSAFE;
932 | }
933 | break;

934
935 | case STATE_AUTONAV:
936 | if (!targetSet || !gpsQualityOK() || !servoBusOK())
937 | {
938 | state = STATE_FAILSAFE;
939 | setSteeringNeutral(false);
940 | break;
941 | }

942
943 | if (targetDistanceM <= TARGET_CAPTURE_RADIUS_M)
944 | {
945 | state = STATE_CAPTURED;
946 | setSteeringNeutral(false);
947 | break;
948 | }

949
950 | if (targetDistanceM > TARGET_RELEASE_RADIUS_M)
951 | {
952 | state = STATE_AUTONAV;
953 | }
954 | break;

955
956 | case STATE_CAPTURED:
957 | setSteeringNeutral(false);

958
959 | // Allow re-entry if the vehicle drifts back out of the capture
960 | // radius before landing.
961 | if (targetDistanceM > TARGET_RELEASE_RADIUS_M)
962 | {
963 | state = STATE_AUTONAV;
964 | }
965 | break;

966
967 | case STATE_LANDED:
968 | setSteeringNeutral(false);
969 | break;

970
971 | case STATE_FAILSAFE:
972 | setSteeringNeutral(false);

973
974 | // Recover automatically after a stable GPS/servo recovery.
975 | if (deployed && targetSet && gpsQualityOK() && servoBusOK())
976 | {
977 | if (gpsGoodStartMs == 0)
978 | gpsGoodStartMs = millis();

979
980 | if (millis() - gpsGoodStartMs >= 3000)
981 | {
982 | state = STATE_AUTONAV;
983 | gpsGoodStartMs = 0;
984 | }
985 | }
986 | else
987 | {
988 | gpsGoodStartMs = 0;
989 | }
990 | break;
991 | }

992
993 | // Navigation commands are generated only in AUTONAV.
994 | if (state == STATE_AUTONAV)
995 | {
996 | if (millis() - lastNavMs >= 100)
997 | {
998 | lastNavMs = millis();
999 | updateNavigation();

1000 | | setSteeringFromDemand(steeringDemand);
1001 | }
1002 | }
1003 | else
1004 | {
1005 | steeringDemand = 0;
1006 | }

1007
1008 updateLandingDetection();

1009
1010 | | // Immediate neutral outside autonomous navigation.
1011 | | if (state != STATE_AUTONAV)
1012 | {
1013 | | servo1Command = SERVO_NEUTRAL;
1014 | | servo2Command = SERVO_NEUTRAL;
1015 | }
1016 | }

1017
1018 | // =====================================================================
1019 | // | ARM / DISARM
1020 | // =====================================================================

1021
1022 | bool armSystem()
1023 | {
1024 | if (!targetSet)
1025 | {
1026 | | Serial.println("ARM rejected: TARGET not set.");
1027 | return false;
1028 | }

1029
1030 | if (!gpsQualityOK())
1031 | {
1032 | | Serial.println("ARM rejected: GPS quality is not good.");
1033 | return false;
1034 | }

1035
1036 | if (!bmpOK)
1037 | {
1038 | | Serial.println("ARM rejected: BMP581 unavailable.");
1039 | return false;
1040 | }

1041
1042 | if (!servoBusOK())
1043 | {
1044 | | Serial.println("ARM rejected: ST-3009 servos not detected.");
1045 | return false;
1046 | }

1047
1048 | | float p = bmp.readPressure();
1049 | | if (!isfinite(p) || p <= 0.0f)
1050 | {
1051 | | Serial.println("ARM rejected: invalid launch pressure.");
1052 | return false;
1053 | }

1054
1055 | launchPressurePa = p;
1056 | baroAltFiltered = 0.0f;
1057 | | baroFilterInitialized = false;
1058 | relativeAlt = 0.0f;
1059 | verticalSpeed = 0.0f;
1060 | lastBaroAltitude = 0.0f;
1061 | | lastBaroAltitudeMs = millis();

1062
1063 | deployed = false;
1064 | deploymentMs = 0;
1065 | ascentStartMs = 0;
1066 | descentStartMs = 0;
1067 | landingStartMs = 0;
1068 | gpsGoodStartMs = 0;

1069
1070 | | deployServo.write(DEPLOY_PRELAUNCH_ANGLE);
1071 | setSteeringNeutral(true);

1072
1073 state = STATE_ARMED;

1075 | Serial.println("SYSTEM ARMED.");
1076 | Serial.println("Waiting for ascent...");

1077
1078 | return true;
1079 | }

1080
1081 | void disarmSystem()
1082 | {
1083 | state = STATE_DISARMED;
1084 | deployed = false;
1085 | steeringDemand = 0;
1086 | setSteeringNeutral(true);
1087 | deployServo.write(DEPLOY_PRELAUNCH_ANGLE);

1088
1089 | Serial.println("SYSTEM DISARMED.");
1090 | }

1091
1092 | // =====================================================================
1093 | // | SERIAL COMMANDS
1094 | // =====================================================================

1095
1096 | void printHelp()
1097 | {
1098 | Serial.println();
1099 | Serial.println("COMMANDS:");
1100 | Serial.println(" | TARGET,<latitude>,<longitude>");
1101 | Serial.println(" | ARM");
1102 | Serial.println(" | DISARM");
1103 | Serial.println(" | STATUS");
1104 | Serial.println(" | ZERO | (reset launch barometer while disarmed)");
1105 | Serial.println(" | NEUTRAL | (center steering servos)");
1106 | Serial.println(" | HELP");
1107 | Serial.println();
1108 | }

1109
1110 | void printStatus()
1111 | {
1112 | Serial.println();
1113 | Serial.println("================ STATUS ================");
1114 | Serial.print("State | : "); Serial.println(stateName(state));
1115 | Serial.print("Target set | : "); Serial.println(targetSet ? "YES" : "NO");

1116
1117 | if (targetSet)
1118 | {
1119 | Serial.print("Target latitude | : "); Serial.println(targetLat, 7);
1120 | Serial.print("Target longitude | : "); Serial.println(targetLon, 7);
1121 | }

1122
1123 | Serial.print("GPS fix | : "); Serial.println(gpsFix ? "YES" : "NO");
1124 | Serial.print("GPS sats | : "); Serial.println(gpsSats);
1125 | Serial.print("GPS HDOP | : "); Serial.println(gpsHDOP, 2);
1126 | Serial.print("GPS speed | : "); Serial.println(gpsSpeedMps, 2);
1127 | Serial.print("GPS course | : "); Serial.println(gpsCourseDeg, 1);

1128
1129 | Serial.print("Compass heading | : "); Serial.print(compassHeading, 1);
1130 | Serial.print(" deg ("); Serial.print(directionName(compassHeading)); Serial.println(")");
1131 | Serial.print("Compass nav head. : "); Serial.print(navigationCompassHeading(), 1);
1132 | Serial.println(" deg");
1133 | Serial.print("Baro rel altitude : "); Serial.println(relativeAlt, 2);
1134 | Serial.print("Vertical speed | : "); Serial.println(verticalSpeed, 2);

1135
1136 | Serial.print("Distance to target: "); Serial.println(targetDistanceM, 1);
1137 | Serial.print("Target bearing | : "); Serial.println(targetBearingDeg, 1);
1138 | Serial.print("Current direction : "); Serial.println(currentDirectionDeg, 1);
1139 | Serial.print("Direction source | : "); Serial.println(directionSource);
1140 | Serial.print("Course error | : "); Serial.println(courseErrorDeg, 1);
1141 | Serial.print("Steering demand | : "); Serial.println(steeringDemand);

1142
1143 | Serial.print("Servo 1 command | : "); Serial.println(servo1Command);
1144 | Serial.print("Servo 2 command | : "); Serial.println(servo2Command);
1145 | Serial.print("Servo 1 actual | : "); Serial.println(servo1Actual);
1146 | Serial.print("Servo 2 actual | : "); Serial.println(servo2Actual);

1147
1148 | Serial.print("Deployed | : "); Serial.println(deployed ? "YES" : "NO");
1149 | Serial.print("Servo 1 bus | : "); Serial.println(servo1OK ? "OK" : "FAIL");

1150 | Serial.print("Servo 2 bus | : "); Serial.println(servo2OK ? "OK" : "FAIL");
1151 | Serial.println("========================================");
1152 | }

1153
1154 | void processCommand(char *cmd)
1155 | {
1156 | // Convert command to uppercase only for the command word.
1157 | // TARGET numeric values are left untouched because they are parsed
1158 | // from the remainder of the string.

1159
1160 | if (strncmp(cmd, "TARGET,", 7) == 0)
1161 | {
1162 | char *p = cmd + 7;
1163 | char *comma = strchr(p, ’,’);

1164
1165 | if (comma == NULL)
1166 | {
1167 | Serial.println("Invalid TARGET format.");
1168 | Serial.println("Use: TARGET,latitude,longitude");
1169 | return;
1170 | }

1171
1172 | *comma = ’\0’;

1173
1174 | double newLat = atof(p);
1175 | double newLon = atof(comma + 1);

1176
1177 | if (newLat < -90.0 || newLat > 90.0 ||
1178 | newLon < -180.0 || newLon > 180.0)
1179 | {
1180 | Serial.println("Invalid latitude/longitude range.");
1181 | return;
1182 | }

1183
1184 | targetLat = newLat;
1185 | targetLon = newLon;
1186 | targetSet = true;

1187
1188 | Serial.print("TARGET SET: ");
1189 | Serial.print(targetLat, 7);
1190 | Serial.print(", ");
1191 | Serial.println(targetLon, 7);
1192 | return;
1193 | }

1194
1195 | if (strcmp(cmd, "ARM") == 0)
1196 | {
1197 | armSystem();
1198 | return;
1199 | }

1200
1201 | if (strcmp(cmd, "DISARM") == 0)
1202 | {
1203 | disarmSystem();
1204 | return;
1205 | }

1206
1207 | if (strcmp(cmd, "STATUS") == 0)
1208 | {
1209 | printStatus();
1210 | return;
1211 | }

1212
1213 | if (strcmp(cmd, "ZERO") == 0)
1214 | {
1215 | if (state != STATE_DISARMED)
1216 | {
1217 | Serial.println("ZERO allowed only when DISARMED.");
1218 | return;
1219 | }

1220
1221 | if (bmpOK)
1222 | {
1223 | float p = bmp.readPressure();
1224 | if (isfinite(p) && p > 0.0f)

1225 | {
1226 | launchPressurePa = p;
1227 | relativeAlt = 0.0f;
1228 | baroAltFiltered = 0.0f;
1229 | verticalSpeed = 0.0f;
1230 | | lastBaroAltitude = 0.0f;
1231 | | lastBaroAltitudeMs = millis();
1232 | | baroFilterInitialized = false;
1233 | | Serial.println("Barometer zeroed.");
1234 | }
1235 | }
1236 | return;
1237 | }

1238
1239 | | if (strcmp(cmd, "NEUTRAL") == 0)
1240 | {
1241 | setSteeringNeutral(true);
1242 | | Serial.println("Steering servos commanded to 2048.");
1243 | return;
1244 | }

1245
1246 | if (strcmp(cmd, "HELP") == 0)
1247 | {
1248 | printHelp();
1249 | return;
1250 | }

1251
1252 | | Serial.print("Unknown command: ");
1253 | Serial.println(cmd);
1254 | }

1255
1256 | void processSerialCommands()
1257 | {
1258 | static char line[100];
1259 | static uint8_t index = 0;

1260
1261 | while (Serial.available())
1262 | {
1263 | char c = Serial.read();

1264
1265 | if (c == ’\r’)
1266 | continue;

1267
1268 | if (c == ’\n’)
1269 | {
1270 | line[index] = ’\0’;

1271
1272 | if (index > 0)
1273 | {
1274 | processCommand(line);
1275 | }

1276
1277 | index = 0;
1278 | }
1279 | else
1280 | {
1281 | | if (index < sizeof(line) - 1)
1282 | {
1283 | line[index++] = c;
1284 | }
1285 | }
1286 | }
1287 | }

1288
1289 | // =====================================================================
1290 | // | SD LOGGING
1291 | // =====================================================================

1292
1293 | void initSD()
1294 | {
1295 | if (!SD.begin(SD_CS))
1296 | {
1297 | sdOK = false;
1298 | return;
1299 | }

1300
1301 sdOK = true;

1302
1303 | if (!SD.exists(LOG_FILE))
1304 | {
1305 | | File f = SD.open(LOG_FILE, FILE_WRITE);

1306
1307 | if (f)
1308 | {
1309 | f.println(
1310 | | "ms,state,targetLat,targetLon,lat,lon,gpsAlt,gpsSpeed,gpsCourse,sats,hdop,"
1311 | | "compass,baroAlt,verticalSpeed,targetDistance,targetBearing,currentDirection,"
1312 | | "directionSource,courseError,steerDemand,servo1Cmd,servo2Cmd,servo1Actual,"
1313 | | "servo2Actual,deployed,ax,ay,az,gx,gy,gz,bmpTemp,pressure"
1314 | );
1315 | f.close();
1316 | }
1317 | }
1318 | }

1319
1320 | void logData()
1321 | {
1322 | if (!sdOK)
1323 | return;

1324
1325 | | if (millis() - lastLogMs < 500)
1326 | return;

1327
1328 lastLogMs = millis();

1329
1330 | | File f = SD.open(LOG_FILE, FILE_WRITE);

1331
1332 | if (!f)
1333 | return;

1334
1335 | | f.print(millis()); f.print(’,’);
1336 | | f.print(stateName(state)); f.print(’,’);
1337 | | f.print(targetLat, 7); f.print(’,’);
1338 | | f.print(targetLon, 7); f.print(’,’);
1339 | | f.print(gpsLat, 7); f.print(’,’);
1340 | | f.print(gpsLon, 7); f.print(’,’);
1341 | | f.print(gpsAlt, 2); f.print(’,’);
1342 | | f.print(gpsSpeedMps, 2); f.print(’,’);
1343 | | f.print(gpsCourseDeg, 2); f.print(’,’);
1344 | | f.print(gpsSats); f.print(’,’);
1345 | | f.print(gpsHDOP, 2); f.print(’,’);
1346 | | f.print(compassHeading, 2); f.print(’,’);
1347 | | f.print(relativeAlt, 2); f.print(’,’);
1348 | | f.print(verticalSpeed, 2); f.print(’,’);
1349 | | f.print(targetDistanceM, 2); f.print(’,’);
1350 | | f.print(targetBearingDeg, 2); f.print(’,’);
1351 | | f.print(currentDirectionDeg, 2); f.print(’,’);
1352 | | f.print(directionSource); f.print(’,’);
1353 | | f.print(courseErrorDeg, 2); f.print(’,’);
1354 | | f.print(steeringDemand); f.print(’,’);
1355 | | f.print(servo1Command); f.print(’,’);
1356 | | f.print(servo2Command); f.print(’,’);
1357 | | f.print(servo1Actual); f.print(’,’);
1358 | | f.print(servo2Actual); f.print(’,’);
1359 | | f.print(deployed ? 1 : 0); f.print(’,’);
1360 | | f.print(ax, 3); f.print(’,’);
1361 | | f.print(ay, 3); f.print(’,’);
1362 | | f.print(az, 3); f.print(’,’);
1363 | | f.print(gx, 2); f.print(’,’);
1364 | | f.print(gy, 2); f.print(’,’);
1365 | | f.print(gz, 2); f.print(’,’);
1366 | | f.print(bmpTemp, 2); f.print(’,’);
1367 | f.println(pressurePa, 1);

1368
1369 | f.close();
1370 | }

1371
1372 | // =====================================================================
1373 | // | SERIAL MONITOR
1374 | // =====================================================================

1375
1376 | void printLiveData()
1377 | {
1378 | if (millis() - lastPrintMs < 500)
1379 | return;

1380
1381 lastPrintMs = millis();

1382
1383 | Serial.println();
1384 | Serial.println("----------------------------------------------------------");
1385 | Serial.print("STATE = "); Serial.println(stateName(state));

1386
1387 | Serial.print("GPS: ");
1388 | if (gpsFix)
1389 | {
1390 | Serial.print(gpsLat, 7);
1391 | Serial.print(", ");
1392 | Serial.print(gpsLon, 7);
1393 | Serial.print(" | Sats=");
1394 | Serial.print(gpsSats);
1395 | Serial.print(" HDOP=");
1396 | Serial.print(gpsHDOP, 1);
1397 | Serial.print(" Speed=");
1398 | Serial.print(gpsSpeedMps, 2);
1399 | Serial.print("m/s Course=");
1400 | Serial.print(gpsCourseDeg, 1);
1401 | Serial.println("deg");
1402 | }
1403 | else
1404 | {
1405 | Serial.println("NO FIX");
1406 | }

1407
1408 | Serial.print("Compass: ");
1409 | if (compassOK)
1410 | {
1411 | Serial.print(compassHeading, 1);
1412 | Serial.println(" deg");
1413 | }
1414 | else
1415 | {
1416 | Serial.println("FAIL");
1417 | }

1418
1419 | Serial.print("Baro: Alt=");
1420 | Serial.print(relativeAlt, 2);
1421 | Serial.print("m VS=");
1422 | Serial.print(verticalSpeed, 2);
1423 | Serial.println("m/s");

1424
1425 | if (targetSet && gpsFix)
1426 | {
1427 | Serial.print("NAV: Bearing=");
1428 | Serial.print(targetBearingDeg, 1);
1429 | Serial.print("deg Distance=");
1430 | Serial.print(targetDistanceM, 1);
1431 | Serial.print("m Current=");
1432 | Serial.print(currentDirectionDeg, 1);
1433 | Serial.print("deg Error=");
1434 | Serial.print(courseErrorDeg, 1);
1435 | Serial.print("deg Source=");
1436 | Serial.println(directionSource);
1437 | }
1438 | else
1439 | {
1440 | Serial.println("NAV: target/GPS not ready");
1441 | }

1442
1443 | Serial.print("Steering: ");
1444 | Serial.print(servo1Command);
1445 | Serial.print(" / ");
1446 | Serial.print(servo2Command);
1447 | Serial.print(" | actual=");
1448 | Serial.print(servo1Actual);
1449 | Serial.print(" / ");

1450 Serial.println(servo2Actual);

1451
1452 | Serial.print("Deploy=");
1453 | Serial.print(deployed ? "YES" : "NO");
1454 | Serial.print(" | ServoBus=");
1455 | Serial.println(servoBusOK() ? "OK" : "FAIL");

1456
1457 | Serial.println("----------------------------------------------------------");
1458 | }

1459
1460 | // =====================================================================
1461 | // | SETUP
1462 | // =====================================================================

1463
1464 | void setup()
1465 | {
1466 | Serial.begin(115200);
1467 | Serial.setTimeout(20);

1468
1469 delay(1500);

1470
1471 | Serial.println();
1472 | Serial.println("============================================================");
1473 | Serial.println(" | TEENSY 4.1 AUTONOMOUS PARAFOIL CONTROLLER");
1474 | Serial.println("============================================================");

1475
1476 | // ------------------------------ I2C ------------------------------
1477 | Wire.begin();
1478 | Wire.setClock(400000);

1479
1480 Serial.println("I2C: SDA 18 / SCL 19");

1481
1482 | // ---------------------------- Compass ---------------------------
1483 | compassOK = initializeQMC5883();
1484 | compassReadFailCount = 0;
1485 | lastCompassRetryMs = millis();
1486 | Serial.print("QMC5883: ");
1487 | Serial.println(compassOK ? "OK @ 0x0D" : "FAIL");

1488
1489 | // ------------------------------ IMU -----------------------------
1490 | imuOK = initializeIMU();
1491 | Serial.print("LSM6DSO32: ");
1492 | Serial.println(imuOK ? "OK @ 0x6A" : "FAIL");

1493
1494 | // ---------------------------- BMP581 ----------------------------
1495 | bmpOK = initializeBMP();
1496 | Serial.print("BMP581: ");
1497 | Serial.println(bmpOK ? "OK" : "FAIL");

1498
1499 | // ------------------------------- GPS ----------------------------
1500 | GPS_SERIAL.begin(GPS_BAUD);
1501 | Serial.println("GPS: Serial3 @ 115200");
1502 | Serial.println(" | GPS TX -> pin 15 / RX3");
1503 | Serial.println(" | GPS RX -> pin 14 / TX3");

1504
1505 | // ------------------------------ Servo ---------------------------
1506 | Serial1.begin(1000000, SERIAL_8N1_HALF_DUPLEX);
1507 | st.pSerial = &Serial1;

1508
1509 delay(1000);

1510
1511 | servo1OK = (st.Ping(SERVO1_ID) != -1);
1512 | servo2OK = (st.Ping(SERVO2_ID) != -1);

1513
1514 | Serial.print("ST-3009 ID1: ");
1515 | Serial.println(servo1OK ? "FOUND" : "NOT FOUND");

1516
1517 | Serial.print("ST-3009 ID2: ");
1518 | Serial.println(servo2OK ? "FOUND" : "NOT FOUND");

1519
1520 setSteeringNeutral(true);

1521
1522 | // -------------------------- Deploy servo ------------------------
1523 | deployServo.attach(DEPLOY_SERVO_PIN);
1524 | deployServo.write(DEPLOY_PRELAUNCH_ANGLE);

1525 | | Serial.print("SG90 deploy pin: ");
1526 | | Serial.println(DEPLOY_SERVO_PIN);

1527
1528 | | // ------------------------------- SD -----------------------------
1529 | initSD();
1530 | Serial.print("SD logging: ");
1531 | | Serial.println(sdOK ? "OK" : "FAIL");

1532
1533 | | // ---------------------------- Watchdog --------------------------
1534 | #if HAVE_WATCHDOG_T4
1535 | WDT_timings_t wdtConfig;
1536 | wdtConfig.timeout = 2000;
1537 | watchdog.begin(wdtConfig);
1538 | | Serial.println("Watchdog: Watchdog_t4 / 2 s");
1539 | #else
1540 | | Serial.println("Watchdog: NOT INSTALLED (install Watchdog_t4 for flight)");
1541 | #endif

1542
1543 | | // ------------------------------ Info ----------------------------
1544 | Serial.println();
1545 | | Serial.println("SYSTEM STARTED DISARMED");
1546 | Serial.println();
1547 | printHelp();
1548 | }

1549
1550 | // =====================================================================
1551 | // | LOOP
1552 | // =====================================================================

1553
1554 | void loop()
1555 | {
1556 | | // Keep serial parsing responsive.
1557 | processSerialCommands();

1558
1559 | | // GPS must be serviced continuously.
1560 | updateGPS();

1561
1562 | | // Sensors at approximately 100 Hz.
1563 | | if (millis() - lastSensorMs >= 10)
1564 | {
1565 | lastSensorMs = millis();

1566
1567 | if (compassOK)
1568 | {
1569 | if (updateCompass())
1570 | {
1571 | compassReadFailCount = 0;
1572 | }
1573 | else
1574 | {
1575 | | if (compassReadFailCount < 255)
1576 | compassReadFailCount++;

1577
1578 | | // Ignore isolated I2C glitches. Only mark the compass bad after
1579 | | // several consecutive failed reads.
1580 | | if (compassReadFailCount >= 10)
1581 | {
1582 | compassOK = false;
1583 | | lastCompassRetryMs = millis();
1584 | | Serial.println("QMC5883: repeated read failure");
1585 | }
1586 | }
1587 | }
1588 | | else if (millis() - lastCompassRetryMs >= 1000)
1589 | {
1590 | | lastCompassRetryMs = millis();
1591 | if (initializeQMC5883())
1592 | {
1593 | compassOK = true;
1594 | compassReadFailCount = 0;
1595 | | Serial.println("QMC5883: reinitialized");
1596 | }
1597 | }

1598
1599 | updateIMU();

1600 | updateBMP();
1601 | }

1602
1603 | // Navigation/flight-state logic.
1604 | handleStateMachine();

1605
1606 | // Servo bus health / encoder positions.
1607 | checkServoHealth();

1608
1609 | // In an active flight, losing both servos immediately forces neutral.
1610 | if (deployed && state == STATE_AUTONAV && !servoBusOK())
1611 | {
1612 | state = STATE_FAILSAFE;
1613 | setSteeringNeutral(true);
1614 | Serial.println("FAILSAFE: SERVO BUS FAULT");
1615 | }

1616
1617 updateServos();

1618
1619 | logData();
1620 | printLiveData();

1621
1622 | #if HAVE_WATCHDOG_T4
1623 | watchdog.feed();
1624 | #endif
1625 | }
A.3 | Archived source 3: Pasted code(10).cpp

## Source file: Pasted code(10).cpp

1 | /*
2 | =================================================================
3 | TEENSY 4.1 AUTONOMOUS PARAFOIL
4 | GUIDED LANDING - FINAL LAB TEST
5 | =================================================================

6
7 TARGET IS FIXED IN CODE.

8
9 | CHANGE ONLY:
10 | TARGET_LAT
11 | TARGET_LON

12
13
14 | =================================================================
15 | HARDWARE
16 | =================================================================

17
18 TEENSY 4.1

19
20 | -----------------------------------------------------------------
21 | FOXEER M10Q 180 GPS
22 | -----------------------------------------------------------------

23
24 | GPS TX | -> Teensy Pin 15 (RX3)
25 | GPS RX | -> Teensy Pin 14 (TX3)
26 | GPS GND -> Teensy GND

27
28 | GPS UART = Serial3
29 | GPS BAUD = 38400

30
31 | -----------------------------------------------------------------
32 | I2C BUS
33 | -----------------------------------------------------------------

34
35 | SDA = Teensy Pin 18
36 | SCL = Teensy Pin 19

37
38 | -----------------------------------------------------------------
39 | QMC5883 COMPASS
40 | -----------------------------------------------------------------

41
42 | Address = 0x0D

43
44 | -----------------------------------------------------------------
45 | LSM6DSO32 IMU
46 | -----------------------------------------------------------------

47
48 | Address = 0x6A

49
50 | -----------------------------------------------------------------
51 | BMP581
52 | -----------------------------------------------------------------

53
54 | Address = 0x46 or 0x47
55 | Diagnostic only

56
57 | -----------------------------------------------------------------
58 | ST-3009
59 | -----------------------------------------------------------------

60
61 | Servo 1 ID = 1
62 | Servo 2 ID = 2

63
64 | Serial1
65 | Pin 0 = RX1
66 | Pin 1 = TX1

67
68 | 1 Mbps
69 | SERIAL_8N1_HALF_DUPLEX

70
71 | Servo neutral = 2048

72
73 | -----------------------------------------------------------------
74 | SG90 DEPLOYMENT SERVO
75 | -----------------------------------------------------------------

76
77 | Signal = Pin 8

78
79 | =================================================================
80 | NAVIGATION
81 | =================================================================

82
83 | Target bearing:
84 | GPS position -> target

85
86 Current heading:

87
88 | If speed >= 1.5 m/s:
89 | GPS course

90
91 | If speed < 1.5 m/s:
92 | QMC5883 compass

93
94 Course error:

95
96 | target bearing - current heading

97
98 | wrapped to -180 ... +180 degrees

99
100 Steering:

101
102 | error <= +/-5 degrees:
103 | neutral

104
105 | error reaches +/-90 degrees:
106 | maximum steering

107
108 | Maximum steering:
109 | +/-450 counts

110
111 Differential:

112
113 | Positive demand:
114 | Servo 1 = 2048 - demand
115 | Servo 2 = 2048 + demand

116
117 | Negative demand:

118 | Servo 1 = 2048 - demand
119 | Servo 2 = 2048 + demand

120
121 | Target capture:
122 | 35 m

123
124 | =================================================================
125 | STATE MACHINE
126 | =================================================================

127
128 | WAIT_READY
129 | |
130 | | GPS GOOD + Servo 1 + Servo 2
131 | v
132 | DEPLOYING
133 | |
134 | | 1.5 sec
135 | v
136 | STABILIZING
137 | |
138 | | 5 sec + GPS + servos
139 | v
140 | AUTONAV
141 | |
142 | | <=35 m
143 | v
144 | CAPTURED

145
146 | GPS or servo failure during AUTONAV:
147 | AUTONAV -> FAILSAFE

148
149 | 3 sec good GPS + servos:
150 | FAILSAFE -> AUTONAV

151
152 | =================================================================
153 | SERIAL COMMANDS
154 | =================================================================

155
156 | STATUS
157 | MOTORTEST
158 | LEFT
159 | RIGHT
160 | CENTER
161 | AUTONAV
162 | DEPLOY
163 | PREP
164 | RESET
165 | HELP

166
167 There is NO TARGET serial command.

168
169 | =================================================================
170 | */

171
172
173 | // =================================================================
174 | // LIBRARIES
175 | // =================================================================

176
177 | #include <Arduino.h>
178 | #include <Wire.h>
179 | #include <Servo.h>
180 | #include <TinyGPS++.h>
181 | #include <SCServo.h>
182 | #include <Adafruit_LSM6DSOX.h>

183
184 | #include <math.h>
185 | #include <string.h>

186
187
188 | // =================================================================
189 | // TARGET
190 | // =================================================================

191
192 const double TARGET_LAT = 32.6321769;

193 const double TARGET_LON = 75.0143889;

194
195
196 | // =================================================================
197 | // AUTO DEPLOY
198 | // =================================================================
199 | //
200 | // true | = deploy automatically after GPS + both ST-3009 ready
201 | // false = wait for DEPLOY command
202 | //
203 | // For the autonomous lab sequence use TRUE.
204 | // =================================================================

205
206 const bool AUTO_DEPLOY_AFTER_READY = true;

207
208
209 | // =================================================================
210 | // GPS
211 | // =================================================================

212
213 #define GPS_SERIAL Serial3

214
215 const uint32_t GPS_BAUD = 38400;

216
217 | const uint8_t GPS_RX_PIN = 15;
218 | const uint8_t GPS_TX_PIN = 14;

219
220 | // GPS data considered stale after this time
221 | const uint32_t GPS_DATA_TIMEOUT_MS = 2500;

222
223 | // Minimum satellites
224 | const uint8_t GPS_MIN_SATS = 5;

225
226 | // Maximum acceptable HDOP
227 | const double GPS_MAX_HDOP = 3.5;

228
229 | // GPS course is used only above this speed
230 | const double GPS_COURSE_MIN_SPEED_MPS = 1.5;

231
232
233 | // =================================================================
234 | // I2C
235 | // =================================================================

236
237 | const uint8_t I2C_SDA_PIN = 18;
238 | const uint8_t I2C_SCL_PIN = 19;

239
240
241 | // =================================================================
242 | // QMC5883
243 | // =================================================================

244
245 const uint8_t QMC5883_ADDR = 0x0D;

246
247
248 | // -----------------------------------------------------------------
249 | // Compass navigation orientation
250 | // -----------------------------------------------------------------
251 | //
252 | // Your tested compass direction was mirrored for navigation.
253 | //

254
255 const bool COMPASS_MIRROR_FOR_NAV = true;

256
257 const float COMPASS_HEADING_OFFSET_DEG = 0.0f;

258
259
260 | // -----------------------------------------------------------------
261 | // Calibration values from your working compass test
262 | // -----------------------------------------------------------------

263
264 | const float OFFSET_X = 180.0000f;
265 | const float OFFSET_Y = 336.0000f;
266 | const float OFFSET_Z = 615.0000f;

268 | const float SCALE_X = 0.956484f;
269 | const float SCALE_Y = 0.904406f;
270 | const float SCALE_Z = 1.178127f;

271
272
273 | // =================================================================
274 | // LSM6DSO32
275 | // =================================================================

276
277 const uint8_t LSM6DSO32_ADDR = 0x6A;

278
279 Adafruit_LSM6DSOX lsm6dso;

280
281 bool imuOK = false;

282
283
284 | // =================================================================
285 | // BMP581
286 | // =================================================================

287
288 | const uint8_t BMP581_ADDR_1 = 0x46;
289 | const uint8_t BMP581_ADDR_2 = 0x47;

290
291 bool bmpOK = false;

292
293 uint8_t bmpAddress = 0;

294
295
296 | // =================================================================
297 | // GPS VARIABLES
298 | // =================================================================

299
300 TinyGPSPlus gps;

301
302 bool gpsFix = false;

303
304 uint8_t gpsSats = 0;

305
306 double gpsHDOP = 99.9;

307
308 double currentSpeed = 0.0;

309
310 unsigned long lastGPSLocationMs = 0;

311
312
313 | // =================================================================
314 | // COMPASS VARIABLES
315 | // =================================================================

316
317 bool compassOK = false;

318
319 | int16_t rawMagX = 0;
320 | int16_t rawMagY = 0;
321 | int16_t rawMagZ = 0;

322
323 | float magX = 0.0f;
324 | float magY = 0.0f;
325 | float magZ = 0.0f;

326
327 | float compassHeading = 0.0f;
328 | float navCompassHeading = 0.0f;

329
330 uint8_t compassFailCount = 0;

331
332
333 | // =================================================================
334 | // IMU VARIABLES
335 | // =================================================================

336
337 | float accelX = 0.0f;
338 | float accelY = 0.0f;
339 | float accelZ = 0.0f;

340
341 | float gyroX = 0.0f;
342 | float gyroY = 0.0f;

343 float gyroZ = 0.0f;

344
345 unsigned long lastSensorUpdateMs = 0;

346
347
348 | // =================================================================
349 | // ST-3009
350 | // =================================================================
351 | //
352 | // IMPORTANT:
353 | // SCServo 1.0.2 uses:
354 | //
355 | // | SMS_STS
356 | //

357
358 SMS_STS st;

359
360
361 | // -----------------------------------------------------------------
362 | // Servo IDs
363 | // -----------------------------------------------------------------

364
365 | const uint8_t SERVO1_ID = 1;
366 | const uint8_t SERVO2_ID = 2;

367
368
369 | // -----------------------------------------------------------------
370 | // Servo positions
371 | // -----------------------------------------------------------------

372
373 const int SERVO_NEUTRAL = 2048;

374
375 | const int SERVO_MIN_POS = 200;
376 | const int SERVO_MAX_POS = 3895;

377
378
379 | // -----------------------------------------------------------------
380 | // Steering
381 | // -----------------------------------------------------------------

382
383 const int MAX_STEERING_COUNTS = 450;

384
385 | const int STEERING_SERVO_SPEED = 500;
386 | const int STEERING_SERVO_ACCEL = 50;

387
388 const int MAX_SLEW_COUNTS = 60;

389
390
391 | // -----------------------------------------------------------------
392 | // Servo health
393 | // -----------------------------------------------------------------

394
395 const unsigned long SERVO_HEALTH_INTERVAL_MS = 2000;

396
397 | bool servo1OK = false;
398 | bool servo2OK = false;
399 | bool servoBusReady = false;

400
401 unsigned long lastServoHealthMs = 0;

402
403
404 | // -----------------------------------------------------------------
405 | // Current positions
406 | // -----------------------------------------------------------------

407
408 | int servo1Position = SERVO_NEUTRAL;
409 | int servo2Position = SERVO_NEUTRAL;

410
411
412 | // -----------------------------------------------------------------
413 | // Current navigation demand
414 | // -----------------------------------------------------------------

415
416 int steeringDemand = 0;

418
419 | // =================================================================
420 | // SG90 DEPLOYMENT
421 | // =================================================================

422
423 Servo deployServo;

424
425 const uint8_t DEPLOY_SERVO_PIN = 8;

426
427 const int DEPLOY_ANGLE = 180;

428
429 const int PREP_ANGLE = 140;

430
431 const unsigned long DEPLOY_MOVE_TIME_MS = 1500;

432
433 const unsigned long DEPLOY_STABILIZE_TIME_MS = 5000;

434
435 bool deploymentServoActive = false;

436
437 bool deploymentDone = false;

438
439 unsigned long deploymentStartMs = 0;

440
441 unsigned long stabilizationStartMs = 0;

442
443
444 | // =================================================================
445 | // NAVIGATION
446 | // =================================================================

447
448 const double TARGET_CAPTURE_RADIUS_M = 35.0;

449
450 const double STEERING_DEADBAND_DEG = 5.0;

451
452 const double FULL_STEERING_ERROR_DEG = 90.0;

453
454
455 | // =================================================================
456 | // STATE MACHINE
457 | // =================================================================

458
459 | enum SystemState
460 | {
461 | STATE_WAIT_READY,
462 | STATE_DEPLOYING,
463 | STATE_STABILIZING,
464 | STATE_AUTONAV,
465 | STATE_CAPTURED,
466 | STATE_FAILSAFE,
467 | STATE_MANUAL_TEST
468 | };

469
470 SystemState state = STATE_WAIT_READY;

471
472 unsigned long stateEnteredMs = 0;

473
474
475 | // =================================================================
476 | // NAVIGATION VARIABLES
477 | // =================================================================

478
479 double currentLatitude = 0.0;

480
481 double currentLongitude = 0.0;

482
483 double distanceToTarget = 0.0;

484
485 double targetBearing = 0.0;

486
487 double currentDirection = 0.0;

488
489 double courseError = 0.0;

490
491 bool headingValid = false;

493 const char *headingSource = "NONE";

494
495
496 | // =================================================================
497 | // FAILSAFE
498 | // =================================================================

499
500 unsigned long failsafeGoodSinceMs = 0;

501
502 const unsigned long FAILSAFE_RECOVERY_MS = 3000;

503
504
505 | // =================================================================
506 | // SERIAL COMMAND BUFFER
507 | // =================================================================

508
509 #define COMMAND_BUFFER_SIZE 120

510
511 char commandBuffer[COMMAND_BUFFER_SIZE];

512
513 uint16_t commandIndex = 0;

514
515
516 | // =================================================================
517 | // TIMERS
518 | // =================================================================

519
520 unsigned long lastNavigationUpdateMs = 0;

521
522 const unsigned long NAVIGATION_UPDATE_INTERVAL_MS = 100;

523
524 unsigned long lastLivePrintMs = 0;

525
526 const unsigned long LIVE_PRINT_INTERVAL_MS = 1000;

527
528 unsigned long lastBMPCheckMs = 0;

529
530 const unsigned long BMP_CHECK_INTERVAL_MS = 3000;

531
532
533 | // =================================================================
534 | // MOTOR TEST
535 | // =================================================================

536
537 bool motorTestActive = false;

538
539 uint8_t motorTestStep = 0;

540
541 unsigned long motorTestTimer = 0;

542
543
544 | // =================================================================
545 | // FORWARD DECLARATIONS
546 | // =================================================================

547
548 | void processSerialCommands();
549 | void processCommand(char *cmd);

550
551 | void updateGPS();
552 | void updateCompass();
553 | void updateIMU();
554 | void updateServoHealth();

555
556 | void updateNavigation();
557 | void updateSteering();
558 | void updateStateMachine();

559
560 | void writeSteeringPositions(int pos1, int pos2);
561 | void centerServos();
562 | void commandSteering(int demand);

563
564 | void startDeployment();
565 | void prepareDeploymentServo();
566 | void resetSystem();

568 | void startMotorTest();
569 | void updateMotorTest();

570
571 | void printStatus();
572 | void printLiveData();

573
574 | bool gpsQualityOK();
575 | bool readQMC5883();
576 | bool initQMC5883();

577
578 | bool checkI2CDevice(uint8_t address);
579 | bool initIMU();

580
581 bool servosReady();

582
583 | float wrap360(float angle);
584 | double wrap180(double angle);
585 | float navigationCompassHeading();

586
587 const char *stateName(SystemState s);

588
589 | int slewTo(
590 | int currentValue,
591 | int targetValue,
592 | int maxStep
593 | );

594
595
596 | // =================================================================
597 | // SETUP
598 | // =================================================================

599
600 | void setup()
601 | {
602 | // ----------------------------------------------------------------
603 | // USB SERIAL
604 | // ----------------------------------------------------------------

605
606 Serial.begin(115200);

607
608 delay(1500);

609
610
611 | Serial.println();
612 | Serial.println(
613 | "================================================"
614 | );

615
616 | Serial.println(
617 | " TEENSY 4.1 AUTONOMOUS PARAFOIL"
618 | );

619
620 | Serial.println(
621 | " GUIDED LANDING - FINAL LAB TEST"
622 | );

623
624 | Serial.println(
625 | "================================================"
626 | );

627
628
629 | // ----------------------------------------------------------------
630 | // TARGET
631 | // ----------------------------------------------------------------

632
633 Serial.println();

634
635 | Serial.print(
636 | "TARGET LATITUDE | : "
637 | );

638
639 | Serial.println(
640 | TARGET_LAT,
641 | 7
642 | );

643
644
645 | Serial.print(
646 | "TARGET LONGITUDE : "
647 | );

648
649 | Serial.println(
650 | TARGET_LON,
651 | 7
652 | );

653
654
655 | // ----------------------------------------------------------------
656 | // I2C
657 | // ----------------------------------------------------------------

658
659 Wire.begin();

660
661 Wire.setClock(400000);

662
663
664 Serial.println();

665
666 | Serial.println(
667 | "I2C initialized"
668 | );

669
670 | Serial.println(
671 | "SDA = Pin 18"
672 | );

673
674 | Serial.println(
675 | "SCL = Pin 19"
676 | );

677
678
679 | // ----------------------------------------------------------------
680 | // QMC5883
681 | // ----------------------------------------------------------------

682
683 | if (initQMC5883())
684 | {
685 | compassOK = true;

686
687 | Serial.println(
688 | "QMC5883 : OK"
689 | );
690 | }
691 | else
692 | {
693 | compassOK = false;

694
695 | Serial.println(
696 | "QMC5883 : NOT FOUND"
697 | );
698 | }

699
700
701 | // ----------------------------------------------------------------
702 | // LSM6DSO32
703 | // ----------------------------------------------------------------

704
705 | if (initIMU())
706 | {
707 | imuOK = true;

708
709 | Serial.println(
710 | "LSM6DSO32 : OK"
711 | );
712 | }
713 | else
714 | {
715 | imuOK = false;

716
717 | Serial.println(

718 | "LSM6DSO32 : NOT FOUND"
719 | );
720 | }

721
722
723 | // ----------------------------------------------------------------
724 | // BMP581
725 | // ----------------------------------------------------------------

726
727 | if (checkI2CDevice(
728 | BMP581_ADDR_1))
729 | {
730 | bmpOK = true;

731
732 | bmpAddress =
733 | BMP581_ADDR_1;
734 | }
735 | else if (checkI2CDevice(
736 | | BMP581_ADDR_2))
737 | {
738 | bmpOK = true;

739
740 | bmpAddress =
741 | BMP581_ADDR_2;
742 | }
743 | else
744 | {
745 | bmpOK = false;

746
747 | bmpAddress = 0;
748 | }

749
750
751 | if (bmpOK)
752 | {
753 | Serial.print(
754 | "BMP581 : FOUND at 0x"
755 | );

756
757 | if (bmpAddress < 16)
758 | Serial.print("0");

759
760 | Serial.println(
761 | bmpAddress,
762 | HEX
763 | );
764 | }
765 | else
766 | {
767 | Serial.println(
768 | "BMP581 : NOT FOUND"
769 | );
770 | }

771
772
773 | // ----------------------------------------------------------------
774 | // GPS
775 | // ----------------------------------------------------------------
776 | //
777 | // EXACTLY MATCHES YOUR WORKING GPS TEST
778 | //

779
780 | GPS_SERIAL.begin(
781 | GPS_BAUD
782 | );

783
784
785 Serial.println();

786
787 | Serial.println(
788 | "GPS UART | : Serial3"
789 | );

790
791 | Serial.print(
792 | "GPS RX | : Pin "

793 | );

794
795 | Serial.println(
796 | GPS_RX_PIN
797 | );

798
799 | Serial.print(
800 | "GPS TX | : Pin "
801 | );

802
803 | Serial.println(
804 | GPS_TX_PIN
805 | );

806
807 | Serial.print(
808 | "GPS BAUD | : "
809 | );

810
811 | Serial.println(
812 | GPS_BAUD
813 | );

814
815
816 | // ----------------------------------------------------------------
817 | // ST-3009
818 | // ----------------------------------------------------------------

819
820 Serial.println();

821
822 | Serial.println(
823 | "Initializing ST-3009 bus..."
824 | );

825
826
827 | Serial1.begin(
828 | 1000000,
829 | SERIAL_8N1_HALF_DUPLEX
830 | );

831
832
833 | st.pSerial =
834 | &Serial1;

835
836
837 delay(500);

838
839
840 | // Force immediate first health test
841 | lastServoHealthMs =
842 | millis() -
843 | SERVO_HEALTH_INTERVAL_MS;

844
845
846 updateServoHealth();

847
848
849 | if (servosReady())
850 | {
851 | Serial.println(
852 | "ST-3009 ID 1 : OK"
853 | );

854
855 | Serial.println(
856 | "ST-3009 ID 2 : OK"
857 | );

858
859
860 | centerServos();
861 | }
862 | else
863 | {
864 | Serial.println(
865 | "ST-3009 : WAITING"
866 | );
867 | }

868
869
870 | // ----------------------------------------------------------------
871 | // SG90
872 | // ----------------------------------------------------------------

873
874 deployServo.detach();

875
876 | deploymentServoActive =
877 | false;

878
879
880 | // ----------------------------------------------------------------
881 | // State
882 | // ----------------------------------------------------------------

883
884 | state =
885 | STATE_WAIT_READY;

886
887 | stateEnteredMs =
888 | millis();

889
890
891 Serial.println();

892
893 | Serial.println(
894 | "================================================"
895 | );

896
897 | Serial.println(
898 | "SYSTEM READY"
899 | );

900
901 | Serial.println(
902 | "Target is fixed in code."
903 | );

904
905 | Serial.println(
906 | "================================================"
907 | );

908
909
910 Serial.println();

911
912 | Serial.println(
913 | "COMMANDS:"
914 | );

915
916 | Serial.println(
917 | "STATUS"
918 | );

919
920 | Serial.println(
921 | "MOTORTEST"
922 | );

923
924 | Serial.println(
925 | "LEFT"
926 | );

927
928 | Serial.println(
929 | "RIGHT"
930 | );

931
932 | Serial.println(
933 | "CENTER"
934 | );

935
936 | Serial.println(
937 | "AUTONAV"
938 | );

939
940 | Serial.println(
941 | "DEPLOY"
942 | );

943
944 | Serial.println(
945 | "PREP"
946 | );

947
948 | Serial.println(
949 | "RESET"
950 | );

951
952 | Serial.println(
953 | "HELP"
954 | );

955
956
957 Serial.println();

958
959 | Serial.println(
960 | "Waiting for GPS + ST-3009..."
961 | );
962 | }

963
964
965 | // =================================================================
966 | // LOOP
967 | // =================================================================

968
969 | void loop()
970 | {
971 | // GPS continuously
972 | updateGPS();

973
974
975 | // Serial commands
976 | processSerialCommands();

977
978
979 | // Sensors
980 | if (millis() -
981 | lastSensorUpdateMs >=
982 | 100)
983 | {
984 | lastSensorUpdateMs =
985 | millis();

986
987 | updateCompass();
988 | updateIMU();
989 | }

990
991
992 | // Servo health
993 | updateServoHealth();

994
995
996 | // Motor test
997 | if (motorTestActive)
998 | {
999 | updateMotorTest();
1000 | }

1001
1002
1003 | // State
1004 | updateStateMachine();

1005
1006
1007 | // Navigation
1008 | if (millis() -
1009 | lastNavigationUpdateMs >=
1010 | NAVIGATION_UPDATE_INTERVAL_MS)
1011 | {
1012 | lastNavigationUpdateMs =
1013 | millis();

1014
1015 | updateNavigation();
1016 | updateSteering();
1017 | }

1018
1019
1020 | // BMP check
1021 | if (millis() -
1022 | lastBMPCheckMs >=
1023 | BMP_CHECK_INTERVAL_MS)
1024 | {
1025 | lastBMPCheckMs =
1026 | millis();

1027
1028
1029 | if (!bmpOK)
1030 | {
1031 | if (checkI2CDevice(
1032 | BMP581_ADDR_1))
1033 | {
1034 | bmpOK = true;

1035
1036 | bmpAddress =
1037 | BMP581_ADDR_1;
1038 | }
1039 | else if (checkI2CDevice(
1040 | BMP581_ADDR_2))
1041 | {
1042 | bmpOK = true;

1043
1044 | bmpAddress =
1045 | BMP581_ADDR_2;
1046 | }
1047 | }
1048 | }

1049
1050
1051 | // Live data
1052 | if (millis() -
1053 | lastLivePrintMs >=
1054 | LIVE_PRINT_INTERVAL_MS)
1055 | {
1056 | lastLivePrintMs =
1057 | millis();

1058
1059 | printLiveData();
1060 | }
1061 | }

1062
1063
1064 | // =================================================================
1065 | // GPS UPDATE
1066 | // =================================================================

1067
1068 | void updateGPS()
1069 | {
1070 | while (GPS_SERIAL.available() > 0)
1071 | {
1072 | char c =
1073 | (char)GPS_SERIAL.read();

1074
1075 | gps.encode(c);
1076 | }

1077
1078
1079 | // Fresh GPS location
1080 | if (gps.location.isUpdated())
1081 | {
1082 | lastGPSLocationMs =
1083 | millis();
1084 | }

1085
1086
1087 | // Position
1088 | if (gps.location.isValid())
1089 | {
1090 | gpsFix = true;

1091
1092 | currentLatitude =

1093 | gps.location.lat();

1094
1095 | currentLongitude =
1096 | gps.location.lng();
1097 | }
1098 | else
1099 | {
1100 | gpsFix = false;
1101 | }

1102
1103
1104 | // Satellites
1105 | if (gps.satellites.isValid())
1106 | {
1107 | gpsSats =
1108 | gps.satellites.value();
1109 | }
1110 | else
1111 | {
1112 | gpsSats = 0;
1113 | }

1114
1115
1116 | // HDOP
1117 | if (gps.hdop.isValid())
1118 | {
1119 | gpsHDOP =
1120 | gps.hdop.hdop();
1121 | }
1122 | else
1123 | {
1124 | gpsHDOP = 99.9;
1125 | }

1126
1127
1128 | // Speed
1129 | if (gps.speed.isValid())
1130 | {
1131 | currentSpeed =
1132 | gps.speed.mps();
1133 | }
1134 | else
1135 | {
1136 | currentSpeed = 0.0;
1137 | }
1138 | }

1139
1140
1141 | // =================================================================
1142 | // GPS QUALITY
1143 | // =================================================================

1144
1145 | bool gpsQualityOK()
1146 | {
1147 | if (!gpsFix)
1148 | return false;

1149
1150
1151 | if (lastGPSLocationMs == 0)
1152 | return false;

1153
1154
1155 | if (millis() -
1156 | lastGPSLocationMs >
1157 | GPS_DATA_TIMEOUT_MS)
1158 | {
1159 | return false;
1160 | }

1161
1162
1163 | if (gpsSats <
1164 | GPS_MIN_SATS)
1165 | {
1166 | return false;
1167 | }

1168
1169
1170 | if (gps.hdop.isValid() &&
1171 | gpsHDOP >
1172 | GPS_MAX_HDOP)
1173 | {
1174 | return false;
1175 | }

1176
1177
1178 | return true;
1179 | }

1180
1181
1182 | // =================================================================
1183 | // QMC5883 INIT
1184 | // =================================================================

1185
1186 | bool initQMC5883()
1187 | {
1188 | // Check device
1189 | Wire.beginTransmission(
1190 | QMC5883_ADDR
1191 | );

1192
1193
1194 | if (Wire.endTransmission() != 0)
1195 | {
1196 | return false;
1197 | }

1198
1199
1200 | // SET/RESET period
1201 | Wire.beginTransmission(
1202 | QMC5883_ADDR
1203 | );

1204
1205 | Wire.write(0x0B);
1206 | Wire.write(0x01);

1207
1208 | if (Wire.endTransmission() != 0)
1209 | {
1210 | return false;
1211 | }

1212
1213
1214 delay(10);

1215
1216
1217 | // Control register
1218 | // Same setting used by your
1219 | // working compass test.
1220 | Wire.beginTransmission(
1221 | QMC5883_ADDR
1222 | );

1223
1224 | Wire.write(0x09);
1225 | Wire.write(0x1D);

1226
1227 | if (Wire.endTransmission() != 0)
1228 | {
1229 | return false;
1230 | }

1231
1232
1233 delay(100);

1234
1235
1236 | return true;
1237 | }

1238
1239
1240 | // =================================================================
1241 | // QMC5883 READ
1242 | // =================================================================

1243
1244 | bool readQMC5883()
1245 | {
1246 | Wire.beginTransmission(
1247 | QMC5883_ADDR
1248 | );

1249
1250 Wire.write(0x00);

1251
1252
1253 | if (Wire.endTransmission(false) != 0)
1254 | {
1255 | return false;
1256 | }

1257
1258
1259 | uint8_t count =
1260 | Wire.requestFrom(
1261 | QMC5883_ADDR,
1262 | (uint8_t)6
1263 | );

1264
1265
1266 | if (count != 6)
1267 | {
1268 | while (Wire.available())
1269 | {
1270 | Wire.read();
1271 | }

1272
1273 | return false;
1274 | }

1275
1276
1277 | uint8_t xl =
1278 | Wire.read();

1279
1280 | uint8_t xh =
1281 | Wire.read();

1282
1283
1284 | uint8_t yl =
1285 | Wire.read();

1286
1287 | uint8_t yh =
1288 | Wire.read();

1289
1290
1291 | uint8_t zl =
1292 | Wire.read();

1293
1294 | uint8_t zh =
1295 | Wire.read();

1296
1297
1298 | rawMagX =
1299 | (int16_t)(
1300 | (xh << 8) |
1301 | xl
1302 | );

1303
1304
1305 | rawMagY =
1306 | (int16_t)(
1307 | (yh << 8) |
1308 | yl
1309 | );

1310
1311
1312 | rawMagZ =
1313 | (int16_t)(
1314 | (zh << 8) |
1315 | zl
1316 | );

1318
1319 | return true;
1320 | }

1321
1322
1323 | // =================================================================
1324 | // COMPASS UPDATE
1325 | // =================================================================

1326
1327 | void updateCompass()
1328 | {
1329 | // --------------------------------------------------------------
1330 | // Read sensor
1331 | // --------------------------------------------------------------

1332
1333 | if (!readQMC5883())
1334 | {
1335 | compassFailCount++;

1336
1337
1338 | // Do not immediately declare compass dead.
1339 | // Reinitialize after 5 consecutive failures.

1340
1341 | if (compassFailCount >= 5)
1342 | {
1343 | if (initQMC5883())
1344 | {
1345 | compassOK = true;

1346
1347 | compassFailCount = 0;

1348
1349 | Serial.println(
1350 | "[COMPASS] Reinitialized OK"
1351 | );
1352 | }
1353 | else
1354 | {
1355 | compassOK = false;
1356 | }
1357 | }

1358
1359
1360 | return;
1361 | }

1362
1363
1364 | // Successful reading
1365 | compassFailCount = 0;
1366 | compassOK = true;

1367
1368
1369 | // --------------------------------------------------------------
1370 | // Apply your proven calibration
1371 | // --------------------------------------------------------------

1372
1373 | magX =
1374 | ((float)rawMagX -
1375 | OFFSET_X) *
1376 | SCALE_X;

1377
1378
1379 | magY =
1380 | ((float)rawMagY -
1381 | OFFSET_Y) *
1382 | SCALE_Y;

1383
1384
1385 | magZ =
1386 | ((float)rawMagZ -
1387 | OFFSET_Z) *
1388 | SCALE_Z;

1389
1390
1391 | // --------------------------------------------------------------
1392 | // Calculate heading

1393 // --------------------------------------------------------------

1394
1395 | float angle =
1396 | atan2(
1397 | magY,
1398 | magX
1399 | ) *
1400 | 180.0f /
1401 | PI;

1402
1403
1404 | if (angle < 0.0f)
1405 | angle += 360.0f;

1406
1407
1408 | compassHeading =
1409 | wrap360(
1410 | angle +
1411 | COMPASS_HEADING_OFFSET_DEG
1412 | );

1413
1414
1415 | // Navigation heading
1416 | navCompassHeading =
1417 | navigationCompassHeading();
1418 | }

1419
1420
1421 | // =================================================================
1422 | // NAVIGATION COMPASS
1423 | // =================================================================

1424
1425 | float navigationCompassHeading()
1426 | {
1427 | if (!COMPASS_MIRROR_FOR_NAV)
1428 | {
1429 | return compassHeading;
1430 | }

1431
1432
1433 | return wrap360(
1434 | 360.0f -
1435 | compassHeading
1436 | );
1437 | }

1438
1439
1440 | // =================================================================
1441 | // WRAP 0...360
1442 | // =================================================================

1443
1444 | float wrap360(float angle)
1445 | {
1446 | while (angle >= 360.0f)
1447 | angle -= 360.0f;

1448
1449
1450 | while (angle < 0.0f)
1451 | angle += 360.0f;

1452
1453
1454 | return angle;
1455 | }

1456
1457
1458 | // =================================================================
1459 | // WRAP -180...180
1460 | // =================================================================

1461
1462 | double wrap180(double angle)
1463 | {
1464 | while (angle > 180.0)
1465 | angle -= 360.0;

1466

1468 | while (angle < -180.0)
1469 | angle += 360.0;

1470
1471
1472 | return angle;
1473 | }

1474
1475
1476 | // =================================================================
1477 | // IMU INIT
1478 | // =================================================================

1479
1480 | bool initIMU()
1481 | {
1482 | if (!lsm6dso.begin_I2C(
1483 | LSM6DSO32_ADDR,
1484 | &Wire))
1485 | {
1486 | return false;
1487 | }

1488
1489
1490 | lsm6dso.setAccelRange(
1491 | LSM6DS_ACCEL_RANGE_16_G
1492 | );

1493
1494
1495 | lsm6dso.setGyroRange(
1496 | LSM6DS_GYRO_RANGE_2000_DPS
1497 | );

1498
1499
1500 | lsm6dso.setAccelDataRate(
1501 | LSM6DS_RATE_208_HZ
1502 | );

1503
1504
1505 | lsm6dso.setGyroDataRate(
1506 | LSM6DS_RATE_208_HZ
1507 | );

1508
1509
1510 | return true;
1511 | }

1512
1513
1514 | // =================================================================
1515 | // IMU UPDATE
1516 | // =================================================================

1517
1518 | void updateIMU()
1519 | {
1520 | if (!imuOK)
1521 | return;

1522
1523
1524 | sensors_event_t accel;
1525 | sensors_event_t gyro;
1526 | sensors_event_t temp;

1527
1528
1529 | lsm6dso.getEvent(
1530 | &accel,
1531 | &gyro,
1532 | &temp
1533 | );

1534
1535
1536 | accelX =
1537 | accel.acceleration.x;

1538
1539
1540 | accelY =
1541 | accel.acceleration.y;

1543
1544 | accelZ =
1545 | accel.acceleration.z;

1546
1547
1548 | gyroX =
1549 | gyro.gyro.x;

1550
1551
1552 | gyroY =
1553 | gyro.gyro.y;

1554
1555
1556 | gyroZ =
1557 | gyro.gyro.z;
1558 | }

1559
1560
1561 | // =================================================================
1562 | // I2C CHECK
1563 | // =================================================================

1564
1565 | bool checkI2CDevice(
1566 | uint8_t address)
1567 | {
1568 | Wire.beginTransmission(
1569 | address
1570 | );

1571
1572
1573 | return (
1574 | Wire.endTransmission() == 0
1575 | );
1576 | }

1577
1578
1579 | // =================================================================
1580 | // SERVO HEALTH
1581 | // =================================================================

1582
1583 | void updateServoHealth()
1584 | {
1585 | if (millis() -
1586 | lastServoHealthMs <
1587 | SERVO_HEALTH_INTERVAL_MS)
1588 | {
1589 | return;
1590 | }

1591
1592
1593 | lastServoHealthMs =
1594 | millis();

1595
1596
1597 | // Ping ID 1
1598 | int result1 =
1599 | st.Ping(
1600 | SERVO1_ID
1601 | );

1602
1603
1604 delay(10);

1605
1606
1607 | // Ping ID 2
1608 | int result2 =
1609 | st.Ping(
1610 | SERVO2_ID
1611 | );

1612
1613
1614 | servo1OK =
1615 | (result1 >= 0);

1616

1618 | | servo2OK =
1619 | | (result2 >= 0);

1620
1621
1622 | | servoBusReady =
1623 | | servo1OK &&
1624 | | servo2OK;
1625 | }

1626
1627
1628 | // =================================================================
1629 | // SERVO READY
1630 | // =================================================================

1631
1632 | bool servosReady()
1633 | {
1634 | | return
1635 | | servoBusReady &&
1636 | | servo1OK &&
1637 | | servo2OK;
1638 | }

1639
1640
1641 | // =================================================================
1642 | // CENTER BOTH SERVOS
1643 | // =================================================================

1644
1645 | void centerServos()
1646 | {
1647 | | if (!servosReady())
1648 | | return;

1649
1650
1651 | | st.WritePosEx(
1652 | | SERVO1_ID,
1653 | | SERVO_NEUTRAL,
1654 | | STEERING_SERVO_SPEED,
1655 | | STEERING_SERVO_ACCEL
1656 | );

1657
1658
1659 | | st.WritePosEx(
1660 | | SERVO2_ID,
1661 | | SERVO_NEUTRAL,
1662 | | STEERING_SERVO_SPEED,
1663 | | STEERING_SERVO_ACCEL
1664 | );

1665
1666
1667 | | servo1Position =
1668 | | SERVO_NEUTRAL;

1669
1670
1671 | | servo2Position =
1672 | | SERVO_NEUTRAL;

1673
1674
1675 | | steeringDemand = 0;
1676 | }

1677
1678
1679 | // =================================================================
1680 | // DIRECT STEERING COMMAND
1681 | // =================================================================
1682 | //
1683 | // demand = +300:
1684 | //
1685 | // | Servo 1 = 2048 - 300 = 1748
1686 | // | Servo 2 = 2048 + 300 = 2348
1687 | //
1688 | // demand = -300:
1689 | //
1690 | // | Servo 1 = 2048 + 300 = 2348
1691 | // | Servo 2 = 2048 - 300 = 1748
1692 | //

1693
1694 | void commandSteering(
1695 | int demand)
1696 | {
1697 | if (!servosReady())
1698 | {
1699 | Serial.println(
1700 | "ERROR: ST-3009 BUS NOT READY"
1701 | );

1702
1703 | return;
1704 | }

1705
1706
1707 | demand =
1708 | constrain(
1709 | demand,
1710 | -MAX_STEERING_COUNTS,
1711 | MAX_STEERING_COUNTS
1712 | );

1713
1714
1715 | int pos1 =
1716 | SERVO_NEUTRAL -
1717 | demand;

1718
1719
1720 | int pos2 =
1721 | SERVO_NEUTRAL +
1722 | demand;

1723
1724
1725 | pos1 =
1726 | constrain(
1727 | pos1,
1728 | SERVO_MIN_POS,
1729 | SERVO_MAX_POS
1730 | );

1731
1732
1733 | pos2 =
1734 | constrain(
1735 | pos2,
1736 | SERVO_MIN_POS,
1737 | SERVO_MAX_POS
1738 | );

1739
1740
1741 | st.WritePosEx(
1742 | SERVO1_ID,
1743 | pos1,
1744 | STEERING_SERVO_SPEED,
1745 | STEERING_SERVO_ACCEL
1746 | );

1747
1748
1749 | st.WritePosEx(
1750 | SERVO2_ID,
1751 | pos2,
1752 | STEERING_SERVO_SPEED,
1753 | STEERING_SERVO_ACCEL
1754 | );

1755
1756
1757 | servo1Position =
1758 | pos1;

1759
1760
1761 | servo2Position =
1762 | pos2;

1763
1764
1765 | steeringDemand =
1766 | demand;

1768
1769 | Serial.print(
1770 | "DEMAND="
1771 | );

1772
1773 | Serial.print(
1774 | demand
1775 | );

1776
1777 | Serial.print(
1778 | " | S1="
1779 | );

1780
1781 | Serial.print(
1782 | pos1
1783 | );

1784
1785 | Serial.print(
1786 | " | S2="
1787 | );

1788
1789 | Serial.println(
1790 | pos2
1791 | );
1792 | }

1793
1794
1795 | // =================================================================
1796 | // MOTOR TEST START
1797 | // =================================================================

1798
1799 | void startMotorTest()
1800 | {
1801 | if (!servosReady())
1802 | {
1803 | Serial.println(
1804 | | "MOTORTEST BLOCKED: "
1805 | | "ST-3009 NOT READY"
1806 | );

1807
1808 | return;
1809 | }

1810
1811
1812 | motorTestActive =
1813 | true;

1814
1815
1816 | state =
1817 | STATE_MANUAL_TEST;

1818
1819
1820 motorTestStep = 0;

1821
1822 | motorTestTimer =
1823 | millis();

1824
1825
1826 centerServos();

1827
1828
1829 Serial.println();

1830
1831 | Serial.println(
1832 | "========================================"
1833 | );

1834
1835 | Serial.println(
1836 | " | ST-3009 MOTOR TEST"
1837 | );

1838
1839 | Serial.println(
1840 | "========================================"
1841 | );

1843 | Serial.println(
1844 | "CENTER -> LEFT -> CENTER -> RIGHT -> CENTER"
1845 | );

1846
1847 | Serial.println();
1848 | }

1849
1850
1851 | // =================================================================
1852 | // MOTOR TEST UPDATE
1853 | // =================================================================

1854
1855 | void updateMotorTest()
1856 | {
1857 | if (!servosReady())
1858 | {
1859 | motorTestActive =
1860 | false;

1861
1862 | state =
1863 | STATE_WAIT_READY;

1864
1865 | return;
1866 | }

1867
1868
1869 | if (millis() -
1870 | motorTestTimer <
1871 | 1800)
1872 | {
1873 | return;
1874 | }

1875
1876
1877 | motorTestTimer =
1878 | millis();

1879
1880
1881 | switch (motorTestStep)
1882 | {
1883 | case 0:

1884
1885 | Serial.println(
1886 | "TEST: CENTER"
1887 | );

1888
1889 | commandSteering(0);

1890
1891 | motorTestStep++;

1892
1893 | break;

1894
1895
1896 | case 1:

1897
1898 | Serial.println(
1899 | "TEST: LEFT"
1900 | );

1901
1902 | commandSteering(
1903 | +300
1904 | );

1905
1906 | motorTestStep++;

1907
1908 | break;

1909
1910
1911 | case 2:

1912
1913 | Serial.println(
1914 | "TEST: CENTER"
1915 | );

1916
1917 | commandSteering(0);

1918
1919 | motorTestStep++;

1920
1921 | break;

1922
1923
1924 | case 3:

1925
1926 | Serial.println(
1927 | "TEST: RIGHT"
1928 | );

1929
1930 | commandSteering(
1931 | -300
1932 | );

1933
1934 | motorTestStep++;

1935
1936 | break;

1937
1938
1939 | case 4:

1940
1941 | Serial.println(
1942 | "TEST: CENTER"
1943 | );

1944
1945 | commandSteering(0);

1946
1947 | motorTestStep++;

1948
1949 | break;

1950
1951
1952 | default:

1953
1954 | motorTestActive =
1955 | false;

1956
1957
1958 | state =
1959 | STATE_WAIT_READY;

1960
1961
1962 | centerServos();

1963
1964
1965 | Serial.println();

1966
1967 | Serial.println(
1968 | "MOTOR TEST COMPLETE"
1969 | );

1970
1971 | Serial.println();

1972
1973 | break;
1974 | }
1975 | }

1976
1977
1978 | // =================================================================
1979 | // NAVIGATION CALCULATION
1980 | // =================================================================

1981
1982 | void updateNavigation()
1983 | {
1984 | if (!gpsQualityOK())
1985 | {
1986 | headingValid =
1987 | false;

1988
1989 | headingSource =
1990 | "NONE";

1991
1992 | return;

1993 | }

1994
1995
1996 | // --------------------------------------------------------------
1997 | // GPS position
1998 | // --------------------------------------------------------------

1999
2000 | currentLatitude =
2001 | gps.location.lat();

2002
2003
2004 | currentLongitude =
2005 | gps.location.lng();

2006
2007
2008 | // --------------------------------------------------------------
2009 | // Distance
2010 | // --------------------------------------------------------------

2011
2012 | distanceToTarget =
2013 | TinyGPSPlus::distanceBetween(
2014 | currentLatitude,
2015 | currentLongitude,
2016 | TARGET_LAT,
2017 | TARGET_LON
2018 | );

2019
2020
2021 | // --------------------------------------------------------------
2022 | // Bearing
2023 | // --------------------------------------------------------------

2024
2025 | targetBearing =
2026 | TinyGPSPlus::courseTo(
2027 | currentLatitude,
2028 | currentLongitude,
2029 | TARGET_LAT,
2030 | TARGET_LON
2031 | );

2032
2033
2034 | targetBearing =
2035 | wrap360(
2036 | targetBearing
2037 | );

2038
2039
2040 | // --------------------------------------------------------------
2041 | // Determine heading
2042 | // --------------------------------------------------------------

2043
2044 | headingValid =
2045 | false;

2046
2047
2048 | headingSource =
2049 | "NONE";

2050
2051
2052 | // GPS course when moving
2053 | if (gps.speed.isValid() &&
2054 | gps.course.isValid() &&
2055 | currentSpeed >=
2056 | GPS_COURSE_MIN_SPEED_MPS)
2057 | {
2058 | currentDirection =
2059 | wrap360(
2060 | gps.course.deg()
2061 | );

2062
2063
2064 | headingValid =
2065 | true;

2066

2068 | headingSource =
2069 | "GPS COURSE";
2070 | }

2071
2072
2073 | // Compass when slow/stationary
2074 | else if (compassOK)
2075 | {
2076 | currentDirection =
2077 | navigationCompassHeading();

2078
2079
2080 | headingValid =
2081 | true;

2082
2083
2084 | headingSource =
2085 | "COMPASS";
2086 | }

2087
2088
2089 | // --------------------------------------------------------------
2090 | // Course error
2091 | // --------------------------------------------------------------

2092
2093 | if (headingValid)
2094 | {
2095 | courseError =
2096 | wrap180(
2097 | targetBearing -
2098 | currentDirection
2099 | );
2100 | }
2101 | }

2102
2103
2104 | // =================================================================
2105 | // AUTONOMOUS STEERING
2106 | // =================================================================

2107
2108 | void updateSteering()
2109 | {
2110 | // Manual motor test owns the servos
2111 | if (motorTestActive)
2112 | return;

2113
2114
2115 | // Servo unavailable
2116 | if (!servosReady())
2117 | {
2118 | steeringDemand = 0;

2119
2120 | return;
2121 | }

2122
2123
2124 | // Only steer during AUTONAV
2125 | if (state !=
2126 | STATE_AUTONAV)
2127 | {
2128 | return;
2129 | }

2130
2131
2132 | // GPS required
2133 | if (!gpsQualityOK())
2134 | {
2135 | centerServos();

2136
2137 | return;
2138 | }

2139
2140
2141 | // Target captured
2142 | if (distanceToTarget <=

2143 | TARGET_CAPTURE_RADIUS_M)
2144 | {
2145 | centerServos();

2146
2147 | return;
2148 | }

2149
2150
2151 | // No heading
2152 | if (!headingValid)
2153 | {
2154 | centerServos();

2155
2156 | return;
2157 | }

2158
2159
2160 | // --------------------------------------------------------------
2161 | // Absolute error
2162 | // --------------------------------------------------------------

2163
2164 | double absoluteError =
2165 | fabs(courseError);

2166
2167
2168 | // --------------------------------------------------------------
2169 | // Deadband
2170 | // --------------------------------------------------------------

2171
2172 | if (absoluteError <=
2173 | STEERING_DEADBAND_DEG)
2174 | {
2175 | steeringDemand = 0;
2176 | }
2177 | else
2178 | {
2179 | double usableError =
2180 | absoluteError -
2181 | STEERING_DEADBAND_DEG;

2182
2183
2184 | double usableRange =
2185 | FULL_STEERING_ERROR_DEG -
2186 | STEERING_DEADBAND_DEG;

2187
2188
2189 | double normalized =
2190 | usableError /
2191 | usableRange;

2192
2193
2194 | normalized =
2195 | constrain(
2196 | normalized,
2197 | 0.0,
2198 | 1.0
2199 | );

2200
2201
2202 | int demand =
2203 | (int)round(
2204 | normalized *
2205 | MAX_STEERING_COUNTS
2206 | );

2207
2208
2209 | if (courseError > 0.0)
2210 | {
2211 | steeringDemand =
2212 | demand;
2213 | }
2214 | else
2215 | {
2216 | steeringDemand =
2217 | -demand;

2218 | }
2219 | }

2220
2221
2222 | // --------------------------------------------------------------
2223 | // Target positions
2224 | // --------------------------------------------------------------

2225
2226 | int target1 =
2227 | SERVO_NEUTRAL -
2228 | steeringDemand;

2229
2230
2231 | int target2 =
2232 | SERVO_NEUTRAL +
2233 | steeringDemand;

2234
2235
2236 | target1 =
2237 | constrain(
2238 | target1,
2239 | SERVO_MIN_POS,
2240 | SERVO_MAX_POS
2241 | );

2242
2243
2244 | target2 =
2245 | constrain(
2246 | target2,
2247 | SERVO_MIN_POS,
2248 | SERVO_MAX_POS
2249 | );

2250
2251
2252 | // --------------------------------------------------------------
2253 | // Slew limit
2254 | // --------------------------------------------------------------

2255
2256 | int new1 =
2257 | slewTo(
2258 | servo1Position,
2259 | target1,
2260 | MAX_SLEW_COUNTS
2261 | );

2262
2263
2264 | int new2 =
2265 | slewTo(
2266 | servo2Position,
2267 | target2,
2268 | MAX_SLEW_COUNTS
2269 | );

2270
2271
2272 | // --------------------------------------------------------------
2273 | // Send only if changed
2274 | // --------------------------------------------------------------

2275
2276 | if (new1 != servo1Position ||
2277 | new2 != servo2Position)
2278 | {
2279 | st.WritePosEx(
2280 | SERVO1_ID,
2281 | new1,
2282 | STEERING_SERVO_SPEED,
2283 | STEERING_SERVO_ACCEL
2284 | );

2285
2286
2287 | st.WritePosEx(
2288 | SERVO2_ID,
2289 | new2,
2290 | STEERING_SERVO_SPEED,
2291 | STEERING_SERVO_ACCEL
2292 | );

2293
2294
2295 | servo1Position =
2296 | new1;

2297
2298
2299 | servo2Position =
2300 | new2;
2301 | }
2302 | }

2303
2304
2305 | // =================================================================
2306 | // SLEW LIMIT
2307 | // =================================================================

2308
2309 | int slewTo(
2310 | int currentValue,
2311 | int targetValue,
2312 | int maxStep)
2313 | {
2314 | if (targetValue >
2315 | currentValue)
2316 | {
2317 | int difference =
2318 | targetValue -
2319 | currentValue;

2320
2321
2322 | if (difference >
2323 | maxStep)
2324 | {
2325 | return currentValue +
2326 | maxStep;
2327 | }

2328
2329
2330 | return targetValue;
2331 | }

2332
2333
2334 | if (targetValue <
2335 | currentValue)
2336 | {
2337 | int difference =
2338 | currentValue -
2339 | targetValue;

2340
2341
2342 | if (difference >
2343 | maxStep)
2344 | {
2345 | return currentValue -
2346 | maxStep;
2347 | }

2348
2349
2350 | return targetValue;
2351 | }

2352
2353
2354 | return currentValue;
2355 | }

2356
2357
2358 | // =================================================================
2359 | // DEPLOYMENT
2360 | // =================================================================

2361
2362 | void startDeployment()
2363 | {
2364 | if (deploymentDone)
2365 | {
2366 | Serial.println(
2367 | "DEPLOYMENT ALREADY COMPLETED"

2368 | );

2369
2370 | return;
2371 | }

2372
2373
2374 | if (!gpsQualityOK())
2375 | {
2376 | Serial.println(
2377 | "DEPLOY BLOCKED: GPS NOT READY"
2378 | );

2379
2380 | return;
2381 | }

2382
2383
2384 | if (!servosReady())
2385 | {
2386 | Serial.println(
2387 | "DEPLOY BLOCKED: ST-3009 NOT READY"
2388 | );

2389
2390 | return;
2391 | }

2392
2393
2394 | // Center steering first
2395 | centerServos();

2396
2397
2398 delay(100);

2399
2400
2401 | // Attach SG90
2402 | deployServo.attach(
2403 | DEPLOY_SERVO_PIN
2404 | );

2405
2406
2407 delay(100);

2408
2409
2410 | // Deployment position
2411 | deployServo.write(
2412 | DEPLOY_ANGLE
2413 | );

2414
2415
2416 | deploymentStartMs =
2417 | millis();

2418
2419
2420 | deploymentServoActive =
2421 | true;

2422
2423
2424 | deploymentDone =
2425 | true;

2426
2427
2428 | state =
2429 | STATE_DEPLOYING;

2430
2431
2432 | stateEnteredMs =
2433 | millis();

2434
2435
2436 Serial.println();

2437
2438 | Serial.println(
2439 | "========================================"
2440 | );

2441
2442 Serial.println(

2443 | "STARTING DEPLOYMENT"
2444 | );

2445
2446 | Serial.print(
2447 | "SG90 -> "
2448 | );

2449
2450 | Serial.print(
2451 | DEPLOY_ANGLE
2452 | );

2453
2454 | Serial.println(
2455 | " degrees"
2456 | );
2457 | }

2458
2459
2460 | // =================================================================
2461 | // SG90 PREP
2462 | // =================================================================

2463
2464 | void prepareDeploymentServo()
2465 | {
2466 | deployServo.attach(
2467 | DEPLOY_SERVO_PIN
2468 | );

2469
2470
2471 delay(100);

2472
2473
2474 | deployServo.write(
2475 | PREP_ANGLE
2476 | );

2477
2478
2479 | Serial.print(
2480 | "SG90 -> "
2481 | );

2482
2483 | Serial.print(
2484 | PREP_ANGLE
2485 | );

2486
2487 | Serial.println(
2488 | " degrees"
2489 | );

2490
2491
2492 delay(1000);

2493
2494
2495 deployServo.detach();

2496
2497
2498 | Serial.println(
2499 | "SG90 detached"
2500 | );
2501 | }

2502
2503
2504 | // =================================================================
2505 | // STATE MACHINE
2506 | // =================================================================

2507
2508 | void updateStateMachine()
2509 | {
2510 | // --------------------------------------------------------------
2511 | // Manual test
2512 | // --------------------------------------------------------------

2513
2514 | if (state ==
2515 | STATE_MANUAL_TEST)
2516 | {
2517 | return;

2518 | }

2519
2520
2521 | // --------------------------------------------------------------
2522 | // WAIT READY
2523 | // --------------------------------------------------------------

2524
2525 | if (state ==
2526 | STATE_WAIT_READY)
2527 | {
2528 | if (AUTO_DEPLOY_AFTER_READY &&
2529 | !deploymentDone &&
2530 | gpsQualityOK() &&
2531 | servosReady())
2532 | {
2533 | Serial.println();

2534
2535 | Serial.println(
2536 | "GPS + ST-3009 READY"
2537 | );

2538
2539 | Serial.println(
2540 | "AUTO DEPLOY ENABLED"
2541 | );

2542
2543
2544 | startDeployment();
2545 | }

2546
2547
2548 | return;
2549 | }

2550
2551
2552 | // --------------------------------------------------------------
2553 | // DEPLOYING
2554 | // --------------------------------------------------------------

2555
2556 | if (state ==
2557 | STATE_DEPLOYING)
2558 | {
2559 | steeringDemand =
2560 | 0;

2561
2562
2563 | if (millis() -
2564 | deploymentStartMs >=
2565 | DEPLOY_MOVE_TIME_MS)
2566 | {
2567 | // Detach SG90
2568 | deployServo.detach();

2569
2570
2571 | deploymentServoActive =
2572 | false;

2573
2574
2575 | // Center steering
2576 | if (servosReady())
2577 | {
2578 | centerServos();
2579 | }

2580
2581
2582 | // Stabilization starts
2583 | stabilizationStartMs =
2584 | millis();

2585
2586
2587 | state =
2588 | STATE_STABILIZING;

2589
2590
2591 | Serial.println();

2593 | Serial.println(
2594 | "SG90 detached"
2595 | );

2596
2597 | Serial.println(
2598 | "5 second stabilization started"
2599 | );
2600 | }

2601
2602
2603 | return;
2604 | }

2605
2606
2607 | // --------------------------------------------------------------
2608 | // STABILIZING
2609 | // --------------------------------------------------------------

2610
2611 | if (state ==
2612 | STATE_STABILIZING)
2613 | {
2614 | steeringDemand =
2615 | 0;

2616
2617
2618 | if (millis() -
2619 | stabilizationStartMs >=
2620 | DEPLOY_STABILIZE_TIME_MS)
2621 | {
2622 | if (gpsQualityOK() &&
2623 | servosReady())
2624 | {
2625 | state =
2626 | STATE_AUTONAV;

2627
2628
2629 | Serial.println();

2630
2631 | Serial.println(
2632 | "========================================"
2633 | );

2634
2635 | Serial.println(
2636 | "AUTONOMOUS NAVIGATION STARTED"
2637 | );

2638
2639 | Serial.println(
2640 | "========================================"
2641 | );
2642 | }
2643 | }

2644
2645
2646 | return;
2647 | }

2648
2649
2650 | // --------------------------------------------------------------
2651 | // AUTONAV
2652 | // --------------------------------------------------------------

2653
2654 | if (state ==
2655 | STATE_AUTONAV)
2656 | {
2657 | // GPS / servo failure
2658 | if (!gpsQualityOK() ||
2659 | !servosReady())
2660 | {
2661 | steeringDemand =
2662 | 0;

2663
2664
2665 | if (servosReady())
2666 | {
2667 | centerServos();

2668 | }

2669
2670
2671 | state =
2672 | STATE_FAILSAFE;

2673
2674
2675 | failsafeGoodSinceMs =
2676 | 0;

2677
2678
2679 | Serial.println();

2680
2681 | Serial.println(
2682 | "!!! NAVIGATION FAILSAFE !!!"
2683 | );

2684
2685 | Serial.println(
2686 | "GPS or ST-3009 unavailable"
2687 | );

2688
2689
2690 | return;
2691 | }

2692
2693
2694 | // Target capture
2695 | if (distanceToTarget <=
2696 | TARGET_CAPTURE_RADIUS_M)
2697 | {
2698 | centerServos();

2699
2700
2701 | state =
2702 | STATE_CAPTURED;

2703
2704
2705 | Serial.println();

2706
2707 | Serial.println(
2708 | "========================================"
2709 | );

2710
2711 | Serial.println(
2712 | "TARGET CAPTURED"
2713 | );

2714
2715 | Serial.print(
2716 | "Distance = "
2717 | );

2718
2719 | Serial.print(
2720 | distanceToTarget,
2721 | 2
2722 | );

2723
2724 | Serial.println(
2725 | " m"
2726 | );

2727
2728 | Serial.println(
2729 | "ST-3009 -> CENTER"
2730 | );

2731
2732 | Serial.println(
2733 | "========================================"
2734 | );
2735 | }

2736
2737
2738 | return;
2739 | }

2740
2741
2742 // --------------------------------------------------------------

2743 | // CAPTURED
2744 | // --------------------------------------------------------------

2745
2746 | if (state ==
2747 | STATE_CAPTURED)
2748 | {
2749 | steeringDemand =
2750 | 0;

2751
2752 | return;
2753 | }

2754
2755
2756 | // --------------------------------------------------------------
2757 | // FAILSAFE
2758 | // --------------------------------------------------------------

2759
2760 | if (state ==
2761 | STATE_FAILSAFE)
2762 | {
2763 | steeringDemand =
2764 | 0;

2765
2766
2767 | if (servosReady())
2768 | {
2769 | centerServos();
2770 | }

2771
2772
2773 | if (gpsQualityOK() &&
2774 | servosReady())
2775 | {
2776 | if (failsafeGoodSinceMs ==
2777 | 0)
2778 | {
2779 | failsafeGoodSinceMs =
2780 | millis();

2781
2782
2783 | Serial.println(
2784 | "GPS + ST-3009 recovered"
2785 | );

2786
2787
2788 | Serial.println(
2789 | "Waiting 3 seconds..."
2790 | );
2791 | }
2792 | else if (millis() -
2793 | failsafeGoodSinceMs >=
2794 | FAILSAFE_RECOVERY_MS)
2795 | {
2796 | state =
2797 | STATE_AUTONAV;

2798
2799
2800 | failsafeGoodSinceMs =
2801 | 0;

2802
2803
2804 | Serial.println(
2805 | "FAILSAFE RECOVERY COMPLETE"
2806 | );

2807
2808
2809 | Serial.println(
2810 | "AUTONAV RESUMED"
2811 | );
2812 | }
2813 | }
2814 | else
2815 | {
2816 | failsafeGoodSinceMs =
2817 | 0;

2818 | }

2819
2820
2821 | return;
2822 | }
2823 | }

2824
2825
2826 | // =================================================================
2827 | // SERIAL INPUT
2828 | // =================================================================

2829
2830 | void processSerialCommands()
2831 | {
2832 | while (Serial.available() > 0)
2833 | {
2834 | char c =
2835 | (char)Serial.read();

2836
2837
2838 | // --------------------------------------------------------------
2839 | // Newline
2840 | // --------------------------------------------------------------

2841
2842 | if (c == ’\r’ ||
2843 | c == ’\n’)
2844 | {
2845 | if (commandIndex > 0)
2846 | {
2847 | commandBuffer[
2848 | commandIndex] =
2849 | ’\0’;

2850
2851
2852 | processCommand(
2853 | commandBuffer
2854 | );

2855
2856
2857 | commandIndex =
2858 | 0;
2859 | }

2860
2861
2862 | continue;
2863 | }

2864
2865
2866 | // --------------------------------------------------------------
2867 | // Store
2868 | // --------------------------------------------------------------

2869
2870 | if (commandIndex <
2871 | COMMAND_BUFFER_SIZE - 1)
2872 | {
2873 | commandBuffer[
2874 | commandIndex++] =
2875 | c;
2876 | }
2877 | else
2878 | {
2879 | commandIndex = 0;

2880
2881 | Serial.println(
2882 | "ERROR: COMMAND TOO LONG"
2883 | );
2884 | }
2885 | }
2886 | }

2887
2888
2889 | // =================================================================
2890 | // COMMAND PROCESSOR
2891 | // =================================================================

2893 | void processCommand(
2894 | char *cmd)
2895 | {
2896 | // Remove leading spaces
2897 | while (*cmd == ’ ’ ||
2898 | *cmd == ’\t’)
2899 | {
2900 | cmd++;
2901 | }

2902
2903
2904 | // Remove trailing spaces
2905 | int len =
2906 | strlen(cmd);

2907
2908
2909 | while (len > 0 &&
2910 | (cmd[len - 1] == ’ ’ ||
2911 | cmd[len - 1] == ’\t’))
2912 | {
2913 | cmd[len - 1] =
2914 | ’\0’;

2915
2916 | len--;
2917 | }

2918
2919
2920 | if (len == 0)
2921 | return;

2922
2923
2924 | Serial.print(
2925 | "CMD RECEIVED: ["
2926 | );

2927
2928 | Serial.print(
2929 | cmd
2930 | );

2931
2932 | Serial.println(
2933 | "]"
2934 | );

2935
2936
2937 | // ==============================================================
2938 | // STATUS
2939 | // ==============================================================

2940
2941 | if (strcmp(
2942 | cmd,
2943 | "STATUS") == 0)
2944 | {
2945 | printStatus();
2946 | return;
2947 | }

2948
2949
2950 | // ==============================================================
2951 | // MOTORTEST
2952 | // ==============================================================

2953
2954 | if (strcmp(
2955 | cmd,
2956 | "MOTORTEST") == 0)
2957 | {
2958 | startMotorTest();
2959 | return;
2960 | }

2961
2962
2963 | // ==============================================================
2964 | // LEFT
2965 | // ==============================================================

2966
2967 if (strcmp(

2968 | cmd,
2969 | "LEFT") == 0)
2970 | {
2971 | motorTestActive =
2972 | false;

2973
2974
2975 | state =
2976 | STATE_MANUAL_TEST;

2977
2978
2979 | commandSteering(
2980 | +300
2981 | );

2982
2983
2984 | return;
2985 | }

2986
2987
2988 | // ==============================================================
2989 | // RIGHT
2990 | // ==============================================================

2991
2992 | if (strcmp(
2993 | cmd,
2994 | "RIGHT") == 0)
2995 | {
2996 | motorTestActive =
2997 | false;

2998
2999
3000 | state =
3001 | STATE_MANUAL_TEST;

3002
3003
3004 | commandSteering(
3005 | -300
3006 | );

3007
3008
3009 | return;
3010 | }

3011
3012
3013 | // ==============================================================
3014 | // CENTER
3015 | // ==============================================================

3016
3017 | if (strcmp(
3018 | cmd,
3019 | "CENTER") == 0)
3020 | {
3021 | motorTestActive =
3022 | false;

3023
3024
3025 | if (servosReady())
3026 | {
3027 | centerServos();

3028
3029
3030 | Serial.println(
3031 | "ST-3009 -> CENTER"
3032 | );
3033 | }
3034 | else
3035 | {
3036 | Serial.println(
3037 | "ST-3009 BUS NOT READY"
3038 | );
3039 | }

3040
3041
3042 | state =

3043 | STATE_WAIT_READY;

3044
3045
3046 | return;
3047 | }

3048
3049
3050 | // ==============================================================
3051 | // AUTONAV
3052 | // ==============================================================

3053
3054 | if (strcmp(
3055 | cmd,
3056 | "AUTONAV") == 0)
3057 | {
3058 | motorTestActive =
3059 | false;

3060
3061
3062 | if (gpsQualityOK() &&
3063 | servosReady())
3064 | {
3065 | state =
3066 | STATE_AUTONAV;

3067
3068
3069 | Serial.println(
3070 | "AUTONAV ENABLED"
3071 | );
3072 | }
3073 | else
3074 | {
3075 | Serial.println(
3076 | "AUTONAV BLOCKED"
3077 | );

3078
3079
3080 | Serial.print(
3081 | "GPS = "
3082 | );

3083
3084 | Serial.println(
3085 | gpsQualityOK()
3086 | ? "GOOD"
3087 | : "BAD"
3088 | );

3089
3090
3091 | Serial.print(
3092 | "SERVO = "
3093 | );

3094
3095 | Serial.println(
3096 | servosReady()
3097 | ? "GOOD"
3098 | : "BAD"
3099 | );
3100 | }

3101
3102
3103 | return;
3104 | }

3105
3106
3107 | // ==============================================================
3108 | // DEPLOY
3109 | // ==============================================================

3110
3111 | if (strcmp(
3112 | cmd,
3113 | "DEPLOY") == 0)
3114 | {
3115 | motorTestActive =
3116 | false;

3118
3119 | startDeployment();

3120
3121 | return;
3122 | }

3123
3124
3125 | // ==============================================================
3126 | // PREP
3127 | // ==============================================================

3128
3129 | if (strcmp(
3130 | cmd,
3131 | "PREP") == 0)
3132 | {
3133 | motorTestActive =
3134 | false;

3135
3136
3137 | prepareDeploymentServo();

3138
3139 | return;
3140 | }

3141
3142
3143 | // ==============================================================
3144 | // RESET
3145 | // ==============================================================

3146
3147 | if (strcmp(
3148 | cmd,
3149 | "RESET") == 0)
3150 | {
3151 | motorTestActive =
3152 | false;

3153
3154
3155 | resetSystem();

3156
3157 | return;
3158 | }

3159
3160
3161 | // ==============================================================
3162 | // HELP
3163 | // ==============================================================

3164
3165 | if (strcmp(
3166 | cmd,
3167 | "HELP") == 0)
3168 | {
3169 | Serial.println();

3170
3171 | Serial.println(
3172 | "STATUS"
3173 | );

3174
3175 | Serial.println(
3176 | "MOTORTEST"
3177 | );

3178
3179 | Serial.println(
3180 | "LEFT"
3181 | );

3182
3183 | Serial.println(
3184 | "RIGHT"
3185 | );

3186
3187 | Serial.println(
3188 | "CENTER"
3189 | );

3190
3191 | Serial.println(
3192 | "AUTONAV"

3193 | );

3194
3195 | Serial.println(
3196 | "DEPLOY"
3197 | );

3198
3199 | Serial.println(
3200 | "PREP"
3201 | );

3202
3203 | Serial.println(
3204 | "RESET"
3205 | );

3206
3207 | Serial.println(
3208 | "HELP"
3209 | );

3210
3211
3212 | Serial.println();

3213
3214 | Serial.println(
3215 | "TARGET IS FIXED IN CODE"
3216 | );

3217
3218
3219 | return;
3220 | }

3221
3222
3223 | // Unknown
3224 | Serial.print(
3225 | "UNKNOWN COMMAND: "
3226 | );

3227
3228 | Serial.println(
3229 | cmd
3230 | );
3231 | }

3232
3233
3234 | // =================================================================
3235 | // RESET
3236 | // =================================================================

3237
3238 | void resetSystem()
3239 | {
3240 | // Stop deployment servo
3241 | if (deploymentServoActive)
3242 | {
3243 | deployServo.detach();

3244
3245 | deploymentServoActive =
3246 | false;
3247 | }

3248
3249
3250 | // Stop motor test
3251 | motorTestActive =
3252 | false;

3253
3254
3255 | // Center if available
3256 | if (servosReady())
3257 | {
3258 | centerServos();
3259 | }

3260
3261
3262 | // Reset flags
3263 | deploymentDone =
3264 | false;

3265
3266
3267 steeringDemand =

3268 | 0;

3269
3270
3271 | failsafeGoodSinceMs =
3272 | 0;

3273
3274
3275 | // Return to wait state
3276 | state =
3277 | STATE_WAIT_READY;

3278
3279
3280 | stateEnteredMs =
3281 | millis();

3282
3283
3284 Serial.println();

3285
3286 | Serial.println(
3287 | "========================================"
3288 | );

3289
3290 | Serial.println(
3291 | "SYSTEM RESET"
3292 | );

3293
3294 | Serial.print(
3295 | "TARGET = "
3296 | );

3297
3298 | Serial.print(
3299 | TARGET_LAT,
3300 | 7
3301 | );

3302
3303 | Serial.print(
3304 | ", "
3305 | );

3306
3307 | Serial.println(
3308 | TARGET_LON,
3309 | 7
3310 | );

3311
3312 | Serial.println(
3313 | "========================================"
3314 | );
3315 | }

3316
3317
3318 | // =================================================================
3319 | // STATUS
3320 | // =================================================================

3321
3322 | void printStatus()
3323 | {
3324 | Serial.println();

3325
3326 | Serial.println(
3327 | "================================================"
3328 | );

3329
3330 | Serial.println(
3331 | " | STATUS"
3332 | );

3333
3334 | Serial.println(
3335 | "================================================"
3336 | );

3337
3338
3339 | // System
3340 | Serial.print(
3341 | "State | : "
3342 | );

3343
3344 | Serial.println(
3345 | stateName(state)
3346 | );

3347
3348
3349 | // Target
3350 | Serial.print(
3351 | "Target latitude | : "
3352 | );

3353
3354 | Serial.println(
3355 | TARGET_LAT,
3356 | 7
3357 | );

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
3872
3873 | Serial.print(
3874 | navCompassHeading,
3875 | 1
3876 | );

3877
3878
3879 | // IMU
3880 | Serial.print(
3881 | " IMU="
3882 | );

3883
3884 | Serial.print(
3885 | imuOK
3886 | ? "OK"
3887 | : "FAIL"
3888 | );

3889
3890
3891 | // Servos
3892 | Serial.print(
3893 | " SERVO="
3894 | );

3895
3896 | Serial.println(
3897 | servosReady()
3898 | ? "OK"
3899 | : "FAIL"
3900 | );
3901 | }

3902
3903
3904 | // =================================================================
3905 | // STATE NAME
3906 | // =================================================================

3907
3908 | const char *stateName(
3909 | SystemState s)
3910 | {
3911 | switch (s)
3912 | {
3913 | case STATE_WAIT_READY:
3914 | return "WAIT_READY";

3915
3916
3917 | case STATE_DEPLOYING:
3918 | return "DEPLOYING";

3919
3920
3921 | case STATE_STABILIZING:
3922 | return "STABILIZING";

3923
3924
3925 | case STATE_AUTONAV:
3926 | return "AUTONAV";

3927
3928
3929 | case STATE_CAPTURED:
3930 | return "CAPTURED";

3931
3932
3933 | case STATE_FAILSAFE:
3934 | return "FAILSAFE";

3935
3936
3937 | case STATE_MANUAL_TEST:
3938 | return "MANUAL_TEST";

3939
3940
3941 | default:
3942 | return "UNKNOWN";

3943 | }
3944 | }
A.4 | Archived source 4: Pasted code(20261005-071236).cpp

## Source file: Pasted code(20261005-071236).cpp

1 | /*
2 | =================================================================
3 | TEENSY 4.1 AUTONOMOUS PARAFOIL
4 | GUIDED LANDING - FINAL LAB TEST
5 | =================================================================

6
7 TARGET IS FIXED IN CODE.

8
9 | CHANGE ONLY:
10 | TARGET_LAT
11 | TARGET_LON

12
13
14 | =================================================================
15 | HARDWARE
16 | =================================================================

17
18 TEENSY 4.1

19
20 | -----------------------------------------------------------------
21 | FOXEER M10Q 180 GPS
22 | -----------------------------------------------------------------

23
24 | GPS TX | -> Teensy Pin 15 (RX3)
25 | GPS RX | -> Teensy Pin 14 (TX3)
26 | GPS GND -> Teensy GND

27
28 | GPS UART = Serial3
29 | GPS BAUD = 38400

30
31 | -----------------------------------------------------------------
32 | I2C BUS
33 | -----------------------------------------------------------------

34
35 | SDA = Teensy Pin 18
36 | SCL = Teensy Pin 19

37
38 | -----------------------------------------------------------------
39 | QMC5883 COMPASS
40 | -----------------------------------------------------------------

41
42 | Address = 0x0D

43
44 | -----------------------------------------------------------------
45 | LSM6DSO32 IMU
46 | -----------------------------------------------------------------

47
48 | Address = 0x6A

49
50 | -----------------------------------------------------------------
51 | BMP581
52 | -----------------------------------------------------------------

53
54 | Address = 0x46 or 0x47
55 | Diagnostic only

56
57 | -----------------------------------------------------------------
58 | ST-3009
59 | -----------------------------------------------------------------

60
61 | Servo 1 ID = 1
62 | Servo 2 ID = 2

63
64 | Serial1
65 | Pin 0 = RX1
66 | Pin 1 = TX1

67
68 | 1 Mbps
69 | SERIAL_8N1_HALF_DUPLEX

70
71 | Servo neutral = 2048

72
73 | -----------------------------------------------------------------
74 | SG90 DEPLOYMENT SERVO
75 | -----------------------------------------------------------------

76
77 | Signal = Pin 8

78
79 | =================================================================
80 | NAVIGATION
81 | =================================================================

82
83 | Target bearing:
84 | GPS position -> target

85
86 Current heading:

87
88 | If speed >= 1.5 m/s:
89 | GPS course

90
91 | If speed < 1.5 m/s:
92 | QMC5883 compass

93
94 Course error:

95
96 | target bearing - current heading

97
98 | wrapped to -180 ... +180 degrees

99
100 Steering:

101
102 | error <= +/-5 degrees:
103 | neutral

104
105 | error reaches +/-90 degrees:
106 | maximum steering

107
108 | Maximum steering:
109 | +/-450 counts

110
111 Differential:

112
113 | Positive demand:
114 | Servo 1 = 2048 - demand
115 | Servo 2 = 2048 + demand

116
117 | Negative demand:
118 | Servo 1 = 2048 - demand
119 | Servo 2 = 2048 + demand

120
121 | Target capture:
122 | 35 m

123
124 | =================================================================
125 | STATE MACHINE
126 | =================================================================

127
128 | WAIT_READY
129 | |
130 | | GPS GOOD + Servo 1 + Servo 2
131 | v
132 | DEPLOYING
133 | |
134 | | 1.5 sec
135 | v
136 | STABILIZING
137 | |
138 | | 5 sec + GPS + servos
139 | v
140 | AUTONAV
141 | |

142 | | | <=35 m
143 | | v
144 | | CAPTURED

145
146 | GPS or servo failure during AUTONAV:
147 | | AUTONAV -> FAILSAFE

148
149 | 3 sec good GPS + servos:
150 | | FAILSAFE -> AUTONAV

151
152 | =================================================================
153 | SERIAL COMMANDS
154 | =================================================================

155
156 | STATUS
157 | MOTORTEST
158 | LEFT
159 | RIGHT
160 | CENTER
161 | AUTONAV
162 | DEPLOY
163 | PREP
164 | RESET
165 | HELP

166
167 There is NO TARGET serial command.

168
169 | =================================================================
170 | */

171
172
173 | // =================================================================
174 | // LIBRARIES
175 | // =================================================================

176
177 | #include <Arduino.h>
178 | #include <Wire.h>
179 | #include <Servo.h>
180 | #include <TinyGPS++.h>
181 | #include <SCServo.h>
182 | #include <Adafruit_LSM6DSOX.h>

183
184 | #include <math.h>
185 | #include <string.h>

186
187
188 | // =================================================================
189 | // TARGET
190 | // =================================================================

191
192 | const double TARGET_LAT = 32.6321769;
193 | const double TARGET_LON = 75.0143889;

194
195
196 | // =================================================================
197 | // AUTO DEPLOY
198 | // =================================================================
199 | //
200 | // true | = deploy automatically after GPS + both ST-3009 ready
201 | // false = wait for DEPLOY command
202 | //
203 | // For the autonomous lab sequence use TRUE.
204 | // =================================================================

205
206 const bool AUTO_DEPLOY_AFTER_READY = true;

207
208
209 | // =================================================================
210 | // GPS
211 | // =================================================================

212
213 #define GPS_SERIAL Serial3

214
215 const uint32_t GPS_BAUD = 38400;

217 | const uint8_t GPS_RX_PIN = 15;
218 | const uint8_t GPS_TX_PIN = 14;

219
220 | // GPS data considered stale after this time
221 | const uint32_t GPS_DATA_TIMEOUT_MS = 2500;

222
223 | // Minimum satellites
224 | const uint8_t GPS_MIN_SATS = 5;

225
226 | // Maximum acceptable HDOP
227 | const double GPS_MAX_HDOP = 3.5;

228
229 | // GPS course is used only above this speed
230 | const double GPS_COURSE_MIN_SPEED_MPS = 1.5;

231
232
233 | // =================================================================
234 | // I2C
235 | // =================================================================

236
237 | const uint8_t I2C_SDA_PIN = 18;
238 | const uint8_t I2C_SCL_PIN = 19;

239
240
241 | // =================================================================
242 | // QMC5883
243 | // =================================================================

244
245 const uint8_t QMC5883_ADDR = 0x0D;

246
247
248 | // -----------------------------------------------------------------
249 | // Compass navigation orientation
250 | // -----------------------------------------------------------------
251 | //
252 | // Your tested compass direction was mirrored for navigation.
253 | //

254
255 const bool COMPASS_MIRROR_FOR_NAV = true;

256
257 const float COMPASS_HEADING_OFFSET_DEG = 0.0f;

258
259
260 | // -----------------------------------------------------------------
261 | // Calibration values from your working compass test
262 | // -----------------------------------------------------------------

263
264 | const float OFFSET_X = 180.0000f;
265 | const float OFFSET_Y = 336.0000f;
266 | const float OFFSET_Z = 615.0000f;

267
268 | const float SCALE_X = 0.956484f;
269 | const float SCALE_Y = 0.904406f;
270 | const float SCALE_Z = 1.178127f;

271
272
273 | // =================================================================
274 | // LSM6DSO32
275 | // =================================================================

276
277 const uint8_t LSM6DSO32_ADDR = 0x6A;

278
279 Adafruit_LSM6DSOX lsm6dso;

280
281 bool imuOK = false;

282
283
284 | // =================================================================
285 | // BMP581
286 | // =================================================================

287
288 | const uint8_t BMP581_ADDR_1 = 0x46;
289 | const uint8_t BMP581_ADDR_2 = 0x47;

290
291 bool bmpOK = false;

292
293 uint8_t bmpAddress = 0;

294
295
296 | // =================================================================
297 | // GPS VARIABLES
298 | // =================================================================

299
300 TinyGPSPlus gps;

301
302 bool gpsFix = false;

303
304 uint8_t gpsSats = 0;

305
306 double gpsHDOP = 99.9;

307
308 double currentSpeed = 0.0;

309
310 unsigned long lastGPSLocationMs = 0;

311
312
313 | // =================================================================
314 | // COMPASS VARIABLES
315 | // =================================================================

316
317 bool compassOK = false;

318
319 | int16_t rawMagX = 0;
320 | int16_t rawMagY = 0;
321 | int16_t rawMagZ = 0;

322
323 | float magX = 0.0f;
324 | float magY = 0.0f;
325 | float magZ = 0.0f;

326
327 | float compassHeading = 0.0f;
328 | float navCompassHeading = 0.0f;

329
330 uint8_t compassFailCount = 0;

331
332
333 | // =================================================================
334 | // IMU VARIABLES
335 | // =================================================================

336
337 | float accelX = 0.0f;
338 | float accelY = 0.0f;
339 | float accelZ = 0.0f;

340
341 | float gyroX = 0.0f;
342 | float gyroY = 0.0f;
343 | float gyroZ = 0.0f;

344
345 unsigned long lastSensorUpdateMs = 0;

346
347
348 | // =================================================================
349 | // ST-3009
350 | // =================================================================
351 | //
352 | // IMPORTANT:
353 | // SCServo 1.0.2 uses:
354 | //
355 | // | SMS_STS
356 | //

357
358 SMS_STS st;

359
360
361 | // -----------------------------------------------------------------
362 | // Servo IDs
363 | // -----------------------------------------------------------------

364
365 | const uint8_t SERVO1_ID = 1;
366 | const uint8_t SERVO2_ID = 2;

367
368
369 | // -----------------------------------------------------------------
370 | // Servo positions
371 | // -----------------------------------------------------------------

372
373 const int SERVO_NEUTRAL = 2048;

374
375 | const int SERVO_MIN_POS = 200;
376 | const int SERVO_MAX_POS = 3895;

377
378
379 | // -----------------------------------------------------------------
380 | // Steering
381 | // -----------------------------------------------------------------

382
383 const int MAX_STEERING_COUNTS = 450;

384
385 | const int STEERING_SERVO_SPEED = 500;
386 | const int STEERING_SERVO_ACCEL = 50;

387
388 const int MAX_SLEW_COUNTS = 60;

389
390
391 | // -----------------------------------------------------------------
392 | // Servo health
393 | // -----------------------------------------------------------------

394
395 const unsigned long SERVO_HEALTH_INTERVAL_MS = 2000;

396
397 | bool servo1OK = false;
398 | bool servo2OK = false;
399 | bool servoBusReady = false;

400
401 unsigned long lastServoHealthMs = 0;

402
403
404 | // -----------------------------------------------------------------
405 | // Current positions
406 | // -----------------------------------------------------------------

407
408 | int servo1Position = SERVO_NEUTRAL;
409 | int servo2Position = SERVO_NEUTRAL;

410
411
412 | // -----------------------------------------------------------------
413 | // Current navigation demand
414 | // -----------------------------------------------------------------

415
416 int steeringDemand = 0;

417
418
419 | // =================================================================
420 | // SG90 DEPLOYMENT
421 | // =================================================================

422
423 Servo deployServo;

424
425 const uint8_t DEPLOY_SERVO_PIN = 8;

426
427 const int DEPLOY_ANGLE = 180;

428
429 const int PREP_ANGLE = 140;

430
431 const unsigned long DEPLOY_MOVE_TIME_MS = 1500;

432
433 const unsigned long DEPLOY_STABILIZE_TIME_MS = 5000;

434
435 bool deploymentServoActive = false;

436
437 bool deploymentDone = false;

438
439 unsigned long deploymentStartMs = 0;

440
441 unsigned long stabilizationStartMs = 0;

442
443
444 | // =================================================================
445 | // NAVIGATION
446 | // =================================================================

447
448 const double TARGET_CAPTURE_RADIUS_M = 35.0;

449
450 const double STEERING_DEADBAND_DEG = 5.0;

451
452 const double FULL_STEERING_ERROR_DEG = 90.0;

453
454
455 | // =================================================================
456 | // STATE MACHINE
457 | // =================================================================

458
459 | enum SystemState
460 | {
461 | STATE_WAIT_READY,
462 | STATE_DEPLOYING,
463 | STATE_STABILIZING,
464 | STATE_AUTONAV,
465 | STATE_CAPTURED,
466 | STATE_FAILSAFE,
467 | STATE_MANUAL_TEST
468 | };

469
470 SystemState state = STATE_WAIT_READY;

471
472 unsigned long stateEnteredMs = 0;

473
474
475 | // =================================================================
476 | // NAVIGATION VARIABLES
477 | // =================================================================

478
479 double currentLatitude = 0.0;

480
481 double currentLongitude = 0.0;

482
483 double distanceToTarget = 0.0;

484
485 double targetBearing = 0.0;

486
487 double currentDirection = 0.0;

488
489 double courseError = 0.0;

490
491 bool headingValid = false;

492
493 const char *headingSource = "NONE";

494
495
496 | // =================================================================
497 | // FAILSAFE
498 | // =================================================================

499
500 unsigned long failsafeGoodSinceMs = 0;

501
502 const unsigned long FAILSAFE_RECOVERY_MS = 3000;

503
504
505 | // =================================================================
506 | // SERIAL COMMAND BUFFER
507 | // =================================================================

508
509 #define COMMAND_BUFFER_SIZE 120

510
511 char commandBuffer[COMMAND_BUFFER_SIZE];

512
513 uint16_t commandIndex = 0;

514
515
516 // =================================================================

517 | // TIMERS
518 | // =================================================================

519
520 unsigned long lastNavigationUpdateMs = 0;

521
522 const unsigned long NAVIGATION_UPDATE_INTERVAL_MS = 100;

523
524 unsigned long lastLivePrintMs = 0;

525
526 const unsigned long LIVE_PRINT_INTERVAL_MS = 1000;

527
528 unsigned long lastBMPCheckMs = 0;

529
530 const unsigned long BMP_CHECK_INTERVAL_MS = 3000;

531
532
533 | // =================================================================
534 | // MOTOR TEST
535 | // =================================================================

536
537 bool motorTestActive = false;

538
539 uint8_t motorTestStep = 0;

540
541 unsigned long motorTestTimer = 0;

542
543
544 | // =================================================================
545 | // FORWARD DECLARATIONS
546 | // =================================================================

547
548 | void processSerialCommands();
549 | void processCommand(char *cmd);

550
551 | void updateGPS();
552 | void updateCompass();
553 | void updateIMU();
554 | void updateServoHealth();

555
556 | void updateNavigation();
557 | void updateSteering();
558 | void updateStateMachine();

559
560 | void writeSteeringPositions(int pos1, int pos2);
561 | void centerServos();
562 | void commandSteering(int demand);

563
564 | void startDeployment();
565 | void prepareDeploymentServo();
566 | void resetSystem();

567
568 | void startMotorTest();
569 | void updateMotorTest();

570
571 | void printStatus();
572 | void printLiveData();

573
574 | bool gpsQualityOK();
575 | bool readQMC5883();
576 | bool initQMC5883();

577
578 | bool checkI2CDevice(uint8_t address);
579 | bool initIMU();

580
581 bool servosReady();

582
583 | float wrap360(float angle);
584 | double wrap180(double angle);
585 | float navigationCompassHeading();

586
587 const char *stateName(SystemState s);

588
589 | int slewTo(
590 | int currentValue,
591 | int targetValue,

592 | int maxStep
593 | );

594
595
596 | // =================================================================
597 | // SETUP
598 | // =================================================================

599
600 | void setup()
601 | {
602 | // ----------------------------------------------------------------
603 | // USB SERIAL
604 | // ----------------------------------------------------------------

605
606 Serial.begin(115200);

607
608 delay(1500);

609
610
611 | Serial.println();
612 | Serial.println(
613 | "================================================"
614 | );

615
616 | Serial.println(
617 | " TEENSY 4.1 AUTONOMOUS PARAFOIL"
618 | );

619
620 | Serial.println(
621 | " GUIDED LANDING - FINAL LAB TEST"
622 | );

623
624 | Serial.println(
625 | "================================================"
626 | );

627
628
629 | // ----------------------------------------------------------------
630 | // TARGET
631 | // ----------------------------------------------------------------

632
633 Serial.println();

634
635 | Serial.print(
636 | "TARGET LATITUDE | : "
637 | );

638
639 | Serial.println(
640 | TARGET_LAT,
641 | 7
642 | );

643
644
645 | Serial.print(
646 | "TARGET LONGITUDE : "
647 | );

648
649 | Serial.println(
650 | TARGET_LON,
651 | 7
652 | );

653
654
655 | // ----------------------------------------------------------------
656 | // I2C
657 | // ----------------------------------------------------------------

658
659 Wire.begin();

660
661 Wire.setClock(400000);

662
663
664 Serial.println();

665
666 Serial.println(

667 | "I2C initialized"
668 | );

669
670 | Serial.println(
671 | "SDA = Pin 18"
672 | );

673
674 | Serial.println(
675 | "SCL = Pin 19"
676 | );

677
678
679 | // ----------------------------------------------------------------
680 | // QMC5883
681 | // ----------------------------------------------------------------

682
683 | if (initQMC5883())
684 | {
685 | compassOK = true;

686
687 | Serial.println(
688 | "QMC5883 : OK"
689 | );
690 | }
691 | else
692 | {
693 | compassOK = false;

694
695 | Serial.println(
696 | "QMC5883 : NOT FOUND"
697 | );
698 | }

699
700
701 | // ----------------------------------------------------------------
702 | // LSM6DSO32
703 | // ----------------------------------------------------------------

704
705 | if (initIMU())
706 | {
707 | imuOK = true;

708
709 | Serial.println(
710 | "LSM6DSO32 : OK"
711 | );
712 | }
713 | else
714 | {
715 | imuOK = false;

716
717 | Serial.println(
718 | "LSM6DSO32 : NOT FOUND"
719 | );
720 | }

721
722
723 | // ----------------------------------------------------------------
724 | // BMP581
725 | // ----------------------------------------------------------------

726
727 | if (checkI2CDevice(
728 | BMP581_ADDR_1))
729 | {
730 | bmpOK = true;

731
732 | bmpAddress =
733 | BMP581_ADDR_1;
734 | }
735 | else if (checkI2CDevice(
736 | BMP581_ADDR_2))
737 | {
738 | bmpOK = true;

739
740 | bmpAddress =
741 | BMP581_ADDR_2;

742 | }
743 | else
744 | {
745 | bmpOK = false;

746
747 | bmpAddress = 0;
748 | }

749
750
751 | if (bmpOK)
752 | {
753 | Serial.print(
754 | "BMP581 : FOUND at 0x"
755 | );

756
757 | if (bmpAddress < 16)
758 | Serial.print("0");

759
760 | Serial.println(
761 | bmpAddress,
762 | HEX
763 | );
764 | }
765 | else
766 | {
767 | Serial.println(
768 | "BMP581 : NOT FOUND"
769 | );
770 | }

771
772
773 | // ----------------------------------------------------------------
774 | // GPS
775 | // ----------------------------------------------------------------
776 | //
777 | // EXACTLY MATCHES YOUR WORKING GPS TEST
778 | //

779
780 | GPS_SERIAL.begin(
781 | GPS_BAUD
782 | );

783
784
785 Serial.println();

786
787 | Serial.println(
788 | "GPS UART | : Serial3"
789 | );

790
791 | Serial.print(
792 | "GPS RX | : Pin "
793 | );

794
795 | Serial.println(
796 | GPS_RX_PIN
797 | );

798
799 | Serial.print(
800 | "GPS TX | : Pin "
801 | );

802
803 | Serial.println(
804 | GPS_TX_PIN
805 | );

806
807 | Serial.print(
808 | "GPS BAUD | : "
809 | );

810
811 | Serial.println(
812 | GPS_BAUD
813 | );

814
815
816 // ----------------------------------------------------------------

817 | // ST-3009
818 | // ----------------------------------------------------------------

819
820 Serial.println();

821
822 | Serial.println(
823 | "Initializing ST-3009 bus..."
824 | );

825
826
827 | Serial1.begin(
828 | 1000000,
829 | SERIAL_8N1_HALF_DUPLEX
830 | );

831
832
833 | st.pSerial =
834 | &Serial1;

835
836
837 delay(500);

838
839
840 | // Force immediate first health test
841 | lastServoHealthMs =
842 | millis() -
843 | SERVO_HEALTH_INTERVAL_MS;

844
845
846 updateServoHealth();

847
848
849 | if (servosReady())
850 | {
851 | Serial.println(
852 | "ST-3009 ID 1 : OK"
853 | );

854
855 | Serial.println(
856 | "ST-3009 ID 2 : OK"
857 | );

858
859
860 | centerServos();
861 | }
862 | else
863 | {
864 | Serial.println(
865 | "ST-3009 : WAITING"
866 | );
867 | }

868
869
870 | // ----------------------------------------------------------------
871 | // SG90
872 | // ----------------------------------------------------------------

873
874 deployServo.detach();

875
876 | deploymentServoActive =
877 | false;

878
879
880 | // ----------------------------------------------------------------
881 | // State
882 | // ----------------------------------------------------------------

883
884 | state =
885 | STATE_WAIT_READY;

886
887 | stateEnteredMs =
888 | millis();

889
890
891 Serial.println();

892
893 | Serial.println(
894 | "================================================"
895 | );

896
897 | Serial.println(
898 | "SYSTEM READY"
899 | );

900
901 | Serial.println(
902 | "Target is fixed in code."
903 | );

904
905 | Serial.println(
906 | "================================================"
907 | );

908
909
910 Serial.println();

911
912 | Serial.println(
913 | "COMMANDS:"
914 | );

915
916 | Serial.println(
917 | "STATUS"
918 | );

919
920 | Serial.println(
921 | "MOTORTEST"
922 | );

923
924 | Serial.println(
925 | "LEFT"
926 | );

927
928 | Serial.println(
929 | "RIGHT"
930 | );

931
932 | Serial.println(
933 | "CENTER"
934 | );

935
936 | Serial.println(
937 | "AUTONAV"
938 | );

939
940 | Serial.println(
941 | "DEPLOY"
942 | );

943
944 | Serial.println(
945 | "PREP"
946 | );

947
948 | Serial.println(
949 | "RESET"
950 | );

951
952 | Serial.println(
953 | "HELP"
954 | );

955
956
957 Serial.println();

958
959 | Serial.println(
960 | "Waiting for GPS + ST-3009..."
961 | );
962 | }

963
964
965 | // =================================================================
966 | // LOOP

967 // =================================================================

968
969 | void loop()
970 | {
971 | // GPS continuously
972 | updateGPS();

973
974
975 | // Serial commands
976 | processSerialCommands();

977
978
979 | // Sensors
980 | if (millis() -
981 | lastSensorUpdateMs >=
982 | 100)
983 | {
984 | lastSensorUpdateMs =
985 | millis();

986
987 | updateCompass();
988 | updateIMU();
989 | }

990
991
992 | // Servo health
993 | updateServoHealth();

994
995
996 | // Motor test
997 | if (motorTestActive)
998 | {
999 | updateMotorTest();
1000 | }

1001
1002
1003 | // State
1004 | updateStateMachine();

1005
1006
1007 | // Navigation
1008 | if (millis() -
1009 | lastNavigationUpdateMs >=
1010 | NAVIGATION_UPDATE_INTERVAL_MS)
1011 | {
1012 | lastNavigationUpdateMs =
1013 | millis();

1014
1015 | updateNavigation();
1016 | updateSteering();
1017 | }

1018
1019
1020 | // BMP check
1021 | if (millis() -
1022 | lastBMPCheckMs >=
1023 | BMP_CHECK_INTERVAL_MS)
1024 | {
1025 | lastBMPCheckMs =
1026 | millis();

1027
1028
1029 | if (!bmpOK)
1030 | {
1031 | if (checkI2CDevice(
1032 | BMP581_ADDR_1))
1033 | {
1034 | bmpOK = true;

1035
1036 | bmpAddress =
1037 | BMP581_ADDR_1;
1038 | }
1039 | else if (checkI2CDevice(
1040 | BMP581_ADDR_2))
1041 | {

1042 | bmpOK = true;

1043
1044 | bmpAddress =
1045 | BMP581_ADDR_2;
1046 | }
1047 | }
1048 | }

1049
1050
1051 | // Live data
1052 | if (millis() -
1053 | lastLivePrintMs >=
1054 | LIVE_PRINT_INTERVAL_MS)
1055 | {
1056 | lastLivePrintMs =
1057 | millis();

1058
1059 | printLiveData();
1060 | }
1061 | }

1062
1063
1064 | // =================================================================
1065 | // GPS UPDATE
1066 | // =================================================================

1067
1068 | void updateGPS()
1069 | {
1070 | while (GPS_SERIAL.available() > 0)
1071 | {
1072 | char c =
1073 | (char)GPS_SERIAL.read();

1074
1075 | gps.encode(c);
1076 | }

1077
1078
1079 | // Fresh GPS location
1080 | if (gps.location.isUpdated())
1081 | {
1082 | lastGPSLocationMs =
1083 | millis();
1084 | }

1085
1086
1087 | // Position
1088 | if (gps.location.isValid())
1089 | {
1090 | gpsFix = true;

1091
1092 | currentLatitude =
1093 | gps.location.lat();

1094
1095 | currentLongitude =
1096 | gps.location.lng();
1097 | }
1098 | else
1099 | {
1100 | gpsFix = false;
1101 | }

1102
1103
1104 | // Satellites
1105 | if (gps.satellites.isValid())
1106 | {
1107 | gpsSats =
1108 | gps.satellites.value();
1109 | }
1110 | else
1111 | {
1112 | gpsSats = 0;
1113 | }

1114
1115
1116 | // HDOP

1117 | if (gps.hdop.isValid())
1118 | {
1119 | gpsHDOP =
1120 | gps.hdop.hdop();
1121 | }
1122 | else
1123 | {
1124 | gpsHDOP = 99.9;
1125 | }

1126
1127
1128 | // Speed
1129 | if (gps.speed.isValid())
1130 | {
1131 | currentSpeed =
1132 | gps.speed.mps();
1133 | }
1134 | else
1135 | {
1136 | currentSpeed = 0.0;
1137 | }
1138 | }

1139
1140
1141 | // =================================================================
1142 | // GPS QUALITY
1143 | // =================================================================

1144
1145 | bool gpsQualityOK()
1146 | {
1147 | if (!gpsFix)
1148 | return false;

1149
1150
1151 | if (lastGPSLocationMs == 0)
1152 | return false;

1153
1154
1155 | if (millis() -
1156 | lastGPSLocationMs >
1157 | GPS_DATA_TIMEOUT_MS)
1158 | {
1159 | return false;
1160 | }

1161
1162
1163 | if (gpsSats <
1164 | GPS_MIN_SATS)
1165 | {
1166 | return false;
1167 | }

1168
1169
1170 | if (gps.hdop.isValid() &&
1171 | gpsHDOP >
1172 | GPS_MAX_HDOP)
1173 | {
1174 | return false;
1175 | }

1176
1177
1178 | return true;
1179 | }

1180
1181
1182 | // =================================================================
1183 | // QMC5883 INIT
1184 | // =================================================================

1185
1186 | bool initQMC5883()
1187 | {
1188 | // Check device
1189 | Wire.beginTransmission(
1190 | QMC5883_ADDR
1191 | );

1192
1193
1194 | if (Wire.endTransmission() != 0)
1195 | {
1196 | return false;
1197 | }

1198
1199
1200 | // SET/RESET period
1201 | Wire.beginTransmission(
1202 | QMC5883_ADDR
1203 | );

1204
1205 | Wire.write(0x0B);
1206 | Wire.write(0x01);

1207
1208 | if (Wire.endTransmission() != 0)
1209 | {
1210 | return false;
1211 | }

1212
1213
1214 delay(10);

1215
1216
1217 | // Control register
1218 | // Same setting used by your
1219 | // working compass test.
1220 | Wire.beginTransmission(
1221 | QMC5883_ADDR
1222 | );

1223
1224 | Wire.write(0x09);
1225 | Wire.write(0x1D);

1226
1227 | if (Wire.endTransmission() != 0)
1228 | {
1229 | return false;
1230 | }

1231
1232
1233 delay(100);

1234
1235
1236 | return true;
1237 | }

1238
1239
1240 | // =================================================================
1241 | // QMC5883 READ
1242 | // =================================================================

1243
1244 | bool readQMC5883()
1245 | {
1246 | Wire.beginTransmission(
1247 | QMC5883_ADDR
1248 | );

1249
1250 Wire.write(0x00);

1251
1252
1253 | if (Wire.endTransmission(false) != 0)
1254 | {
1255 | return false;
1256 | }

1257
1258
1259 | uint8_t count =
1260 | Wire.requestFrom(
1261 | QMC5883_ADDR,
1262 | (uint8_t)6
1263 | );

1264
1265
1266 if (count != 6)

1267 | {
1268 | while (Wire.available())
1269 | {
1270 | Wire.read();
1271 | }

1272
1273 | return false;
1274 | }

1275
1276
1277 | uint8_t xl =
1278 | Wire.read();

1279
1280 | uint8_t xh =
1281 | Wire.read();

1282
1283
1284 | uint8_t yl =
1285 | Wire.read();

1286
1287 | uint8_t yh =
1288 | Wire.read();

1289
1290
1291 | uint8_t zl =
1292 | Wire.read();

1293
1294 | uint8_t zh =
1295 | Wire.read();

1296
1297
1298 | rawMagX =
1299 | (int16_t)(
1300 | (xh << 8) |
1301 | xl
1302 | );

1303
1304
1305 | rawMagY =
1306 | (int16_t)(
1307 | (yh << 8) |
1308 | yl
1309 | );

1310
1311
1312 | rawMagZ =
1313 | (int16_t)(
1314 | (zh << 8) |
1315 | zl
1316 | );

1317
1318
1319 | return true;
1320 | }

1321
1322
1323 | // =================================================================
1324 | // COMPASS UPDATE
1325 | // =================================================================

1326
1327 | void updateCompass()
1328 | {
1329 | // --------------------------------------------------------------
1330 | // Read sensor
1331 | // --------------------------------------------------------------

1332
1333 | if (!readQMC5883())
1334 | {
1335 | compassFailCount++;

1336
1337
1338 | // Do not immediately declare compass dead.
1339 | // Reinitialize after 5 consecutive failures.

1340
1341 | if (compassFailCount >= 5)

1342 | {
1343 | if (initQMC5883())
1344 | {
1345 | compassOK = true;

1346
1347 | compassFailCount = 0;

1348
1349 | Serial.println(
1350 | "[COMPASS] Reinitialized OK"
1351 | );
1352 | }
1353 | else
1354 | {
1355 | compassOK = false;
1356 | }
1357 | }

1358
1359
1360 | return;
1361 | }

1362
1363
1364 | // Successful reading
1365 | compassFailCount = 0;
1366 | compassOK = true;

1367
1368
1369 | // --------------------------------------------------------------
1370 | // Apply your proven calibration
1371 | // --------------------------------------------------------------

1372
1373 | magX =
1374 | ((float)rawMagX -
1375 | OFFSET_X) *
1376 | SCALE_X;

1377
1378
1379 | magY =
1380 | ((float)rawMagY -
1381 | OFFSET_Y) *
1382 | SCALE_Y;

1383
1384
1385 | magZ =
1386 | ((float)rawMagZ -
1387 | OFFSET_Z) *
1388 | SCALE_Z;

1389
1390
1391 | // --------------------------------------------------------------
1392 | // Calculate heading
1393 | // --------------------------------------------------------------

1394
1395 | float angle =
1396 | atan2(
1397 | magY,
1398 | magX
1399 | ) *
1400 | 180.0f /
1401 | PI;

1402
1403
1404 | if (angle < 0.0f)
1405 | angle += 360.0f;

1406
1407
1408 | compassHeading =
1409 | wrap360(
1410 | angle +
1411 | COMPASS_HEADING_OFFSET_DEG
1412 | );

1413
1414
1415 | // Navigation heading
1416 | navCompassHeading =

1417 | navigationCompassHeading();
1418 | }

1419
1420
1421 | // =================================================================
1422 | // NAVIGATION COMPASS
1423 | // =================================================================

1424
1425 | float navigationCompassHeading()
1426 | {
1427 | if (!COMPASS_MIRROR_FOR_NAV)
1428 | {
1429 | return compassHeading;
1430 | }

1431
1432
1433 | return wrap360(
1434 | 360.0f -
1435 | compassHeading
1436 | );
1437 | }

1438
1439
1440 | // =================================================================
1441 | // WRAP 0...360
1442 | // =================================================================

1443
1444 | float wrap360(float angle)
1445 | {
1446 | while (angle >= 360.0f)
1447 | angle -= 360.0f;

1448
1449
1450 | while (angle < 0.0f)
1451 | angle += 360.0f;

1452
1453
1454 | return angle;
1455 | }

1456
1457
1458 | // =================================================================
1459 | // WRAP -180...180
1460 | // =================================================================

1461
1462 | double wrap180(double angle)
1463 | {
1464 | while (angle > 180.0)
1465 | angle -= 360.0;

1466
1467
1468 | while (angle < -180.0)
1469 | angle += 360.0;

1470
1471
1472 | return angle;
1473 | }

1474
1475
1476 | // =================================================================
1477 | // IMU INIT
1478 | // =================================================================

1479
1480 | bool initIMU()
1481 | {
1482 | if (!lsm6dso.begin_I2C(
1483 | LSM6DSO32_ADDR,
1484 | &Wire))
1485 | {
1486 | return false;
1487 | }

1488
1489
1490 | lsm6dso.setAccelRange(
1491 | LSM6DS_ACCEL_RANGE_16_G

1492 | );

1493
1494
1495 | lsm6dso.setGyroRange(
1496 | LSM6DS_GYRO_RANGE_2000_DPS
1497 | );

1498
1499
1500 | lsm6dso.setAccelDataRate(
1501 | LSM6DS_RATE_208_HZ
1502 | );

1503
1504
1505 | lsm6dso.setGyroDataRate(
1506 | LSM6DS_RATE_208_HZ
1507 | );

1508
1509
1510 | return true;
1511 | }

1512
1513
1514 | // =================================================================
1515 | // IMU UPDATE
1516 | // =================================================================

1517
1518 | void updateIMU()
1519 | {
1520 | if (!imuOK)
1521 | return;

1522
1523
1524 | sensors_event_t accel;
1525 | sensors_event_t gyro;
1526 | sensors_event_t temp;

1527
1528
1529 | lsm6dso.getEvent(
1530 | &accel,
1531 | &gyro,
1532 | &temp
1533 | );

1534
1535
1536 | accelX =
1537 | accel.acceleration.x;

1538
1539
1540 | accelY =
1541 | accel.acceleration.y;

1542
1543
1544 | accelZ =
1545 | accel.acceleration.z;

1546
1547
1548 | gyroX =
1549 | gyro.gyro.x;

1550
1551
1552 | gyroY =
1553 | gyro.gyro.y;

1554
1555
1556 | gyroZ =
1557 | gyro.gyro.z;
1558 | }

1559
1560
1561 | // =================================================================
1562 | // I2C CHECK
1563 | // =================================================================

1564
1565 | bool checkI2CDevice(
1566 | uint8_t address)

1567 | {
1568 | Wire.beginTransmission(
1569 | address
1570 | );

1571
1572
1573 | return (
1574 | Wire.endTransmission() == 0
1575 | );
1576 | }

1577
1578
1579 | // =================================================================
1580 | // SERVO HEALTH
1581 | // =================================================================

1582
1583 | void updateServoHealth()
1584 | {
1585 | if (millis() -
1586 | lastServoHealthMs <
1587 | SERVO_HEALTH_INTERVAL_MS)
1588 | {
1589 | return;
1590 | }

1591
1592
1593 | lastServoHealthMs =
1594 | millis();

1595
1596
1597 | // Ping ID 1
1598 | int result1 =
1599 | st.Ping(
1600 | SERVO1_ID
1601 | );

1602
1603
1604 delay(10);

1605
1606
1607 | // Ping ID 2
1608 | int result2 =
1609 | st.Ping(
1610 | SERVO2_ID
1611 | );

1612
1613
1614 | servo1OK =
1615 | (result1 >= 0);

1616
1617
1618 | servo2OK =
1619 | (result2 >= 0);

1620
1621
1622 | servoBusReady =
1623 | servo1OK &&
1624 | servo2OK;
1625 | }

1626
1627
1628 | // =================================================================
1629 | // SERVO READY
1630 | // =================================================================

1631
1632 | bool servosReady()
1633 | {
1634 | return
1635 | servoBusReady &&
1636 | servo1OK &&
1637 | servo2OK;
1638 | }

1639
1640
1641 // =================================================================

1642 | // CENTER BOTH SERVOS
1643 | // =================================================================

1644
1645 | void centerServos()
1646 | {
1647 | | if (!servosReady())
1648 | | return;

1649
1650
1651 | | st.WritePosEx(
1652 | | SERVO1_ID,
1653 | | SERVO_NEUTRAL,
1654 | | STEERING_SERVO_SPEED,
1655 | | STEERING_SERVO_ACCEL
1656 | );

1657
1658
1659 | | st.WritePosEx(
1660 | | SERVO2_ID,
1661 | | SERVO_NEUTRAL,
1662 | | STEERING_SERVO_SPEED,
1663 | | STEERING_SERVO_ACCEL
1664 | );

1665
1666
1667 | | servo1Position =
1668 | | SERVO_NEUTRAL;

1669
1670
1671 | | servo2Position =
1672 | | SERVO_NEUTRAL;

1673
1674
1675 | | steeringDemand = 0;
1676 | }

1677
1678
1679 | // =================================================================
1680 | // DIRECT STEERING COMMAND
1681 | // =================================================================
1682 | //
1683 | // demand = +300:
1684 | //
1685 | // | Servo 1 = 2048 - 300 = 1748
1686 | // | Servo 2 = 2048 + 300 = 2348
1687 | //
1688 | // demand = -300:
1689 | //
1690 | // | Servo 1 = 2048 + 300 = 2348
1691 | // | Servo 2 = 2048 - 300 = 1748
1692 | //

1693
1694 | void commandSteering(
1695 | | int demand)
1696 | {
1697 | | if (!servosReady())
1698 | {
1699 | | Serial.println(
1700 | | "ERROR: ST-3009 BUS NOT READY"
1701 | | );

1702
1703 | | return;
1704 | }

1705
1706
1707 | | demand =
1708 | | constrain(
1709 | | demand,
1710 | | -MAX_STEERING_COUNTS,
1711 | | MAX_STEERING_COUNTS
1712 | | );

1713
1714
1715 | | int pos1 =
1716 | | SERVO_NEUTRAL -

1717 | demand;

1718
1719
1720 | int pos2 =
1721 | SERVO_NEUTRAL +
1722 | demand;

1723
1724
1725 | pos1 =
1726 | constrain(
1727 | | pos1,
1728 | | SERVO_MIN_POS,
1729 | | SERVO_MAX_POS
1730 | );

1731
1732
1733 | pos2 =
1734 | constrain(
1735 | | pos2,
1736 | | SERVO_MIN_POS,
1737 | | SERVO_MAX_POS
1738 | );

1739
1740
1741 | st.WritePosEx(
1742 | SERVO1_ID,
1743 | pos1,
1744 | STEERING_SERVO_SPEED,
1745 | STEERING_SERVO_ACCEL
1746 | );

1747
1748
1749 | st.WritePosEx(
1750 | SERVO2_ID,
1751 | pos2,
1752 | STEERING_SERVO_SPEED,
1753 | STEERING_SERVO_ACCEL
1754 | );

1755
1756
1757 | servo1Position =
1758 | pos1;

1759
1760
1761 | servo2Position =
1762 | pos2;

1763
1764
1765 | steeringDemand =
1766 | demand;

1767
1768
1769 | Serial.print(
1770 | "DEMAND="
1771 | );

1772
1773 | Serial.print(
1774 | demand
1775 | );

1776
1777 | Serial.print(
1778 | " | S1="
1779 | );

1780
1781 | Serial.print(
1782 | pos1
1783 | );

1784
1785 | Serial.print(
1786 | " | S2="
1787 | );

1788
1789 | Serial.println(
1790 | pos2
1791 | );

1792 }

1793
1794
1795 | // =================================================================
1796 | // MOTOR TEST START
1797 | // =================================================================

1798
1799 | void startMotorTest()
1800 | {
1801 | if (!servosReady())
1802 | {
1803 | Serial.println(
1804 | | "MOTORTEST BLOCKED: "
1805 | | "ST-3009 NOT READY"
1806 | );

1807
1808 | return;
1809 | }

1810
1811
1812 | motorTestActive =
1813 | true;

1814
1815
1816 | state =
1817 | STATE_MANUAL_TEST;

1818
1819
1820 motorTestStep = 0;

1821
1822 | motorTestTimer =
1823 | millis();

1824
1825
1826 centerServos();

1827
1828
1829 Serial.println();

1830
1831 | Serial.println(
1832 | "========================================"
1833 | );

1834
1835 | Serial.println(
1836 | " | ST-3009 MOTOR TEST"
1837 | );

1838
1839 | Serial.println(
1840 | "========================================"
1841 | );

1842
1843 | Serial.println(
1844 | "CENTER -> LEFT -> CENTER -> RIGHT -> CENTER"
1845 | );

1846
1847 | Serial.println();
1848 | }

1849
1850
1851 | // =================================================================
1852 | // MOTOR TEST UPDATE
1853 | // =================================================================

1854
1855 | void updateMotorTest()
1856 | {
1857 | if (!servosReady())
1858 | {
1859 | motorTestActive =
1860 | false;

1861
1862 | state =
1863 | | STATE_WAIT_READY;

1864
1865 | return;
1866 | }

1867
1868
1869 | if (millis() -
1870 | motorTestTimer <
1871 | 1800)
1872 | {
1873 | return;
1874 | }

1875
1876
1877 | motorTestTimer =
1878 | millis();

1879
1880
1881 | switch (motorTestStep)
1882 | {
1883 | case 0:

1884
1885 | Serial.println(
1886 | "TEST: CENTER"
1887 | );

1888
1889 | commandSteering(0);

1890
1891 | motorTestStep++;

1892
1893 | break;

1894
1895
1896 | case 1:

1897
1898 | Serial.println(
1899 | "TEST: LEFT"
1900 | );

1901
1902 | commandSteering(
1903 | +300
1904 | );

1905
1906 | motorTestStep++;

1907
1908 | break;

1909
1910
1911 | case 2:

1912
1913 | Serial.println(
1914 | "TEST: CENTER"
1915 | );

1916
1917 | commandSteering(0);

1918
1919 | motorTestStep++;

1920
1921 | break;

1922
1923
1924 | case 3:

1925
1926 | Serial.println(
1927 | "TEST: RIGHT"
1928 | );

1929
1930 | commandSteering(
1931 | -300
1932 | );

1933
1934 | motorTestStep++;

1935
1936 | break;

1937
1938
1939 | case 4:

1940
1941 | Serial.println(

1942 | "TEST: CENTER"
1943 | );

1944
1945 | commandSteering(0);

1946
1947 | motorTestStep++;

1948
1949 | break;

1950
1951
1952 | default:

1953
1954 | motorTestActive =
1955 | false;

1956
1957
1958 | state =
1959 | STATE_WAIT_READY;

1960
1961
1962 | centerServos();

1963
1964
1965 | Serial.println();

1966
1967 | Serial.println(
1968 | "MOTOR TEST COMPLETE"
1969 | );

1970
1971 | Serial.println();

1972
1973 | break;
1974 | }
1975 | }

1976
1977
1978 | // =================================================================
1979 | // NAVIGATION CALCULATION
1980 | // =================================================================

1981
1982 | void updateNavigation()
1983 | {
1984 | if (!gpsQualityOK())
1985 | {
1986 | headingValid =
1987 | false;

1988
1989 | headingSource =
1990 | "NONE";

1991
1992 | return;
1993 | }

1994
1995
1996 | // --------------------------------------------------------------
1997 | // GPS position
1998 | // --------------------------------------------------------------

1999
2000 | currentLatitude =
2001 | gps.location.lat();

2002
2003
2004 | currentLongitude =
2005 | gps.location.lng();

2006
2007
2008 | // --------------------------------------------------------------
2009 | // Distance
2010 | // --------------------------------------------------------------

2011
2012 | distanceToTarget =
2013 | TinyGPSPlus::distanceBetween(
2014 | currentLatitude,
2015 | currentLongitude,
2016 | TARGET_LAT,

2017 | TARGET_LON
2018 | );

2019
2020
2021 | // --------------------------------------------------------------
2022 | // Bearing
2023 | // --------------------------------------------------------------

2024
2025 | targetBearing =
2026 | TinyGPSPlus::courseTo(
2027 | currentLatitude,
2028 | currentLongitude,
2029 | TARGET_LAT,
2030 | TARGET_LON
2031 | );

2032
2033
2034 | targetBearing =
2035 | wrap360(
2036 | targetBearing
2037 | );

2038
2039
2040 | // --------------------------------------------------------------
2041 | // Determine heading
2042 | // --------------------------------------------------------------

2043
2044 | headingValid =
2045 | false;

2046
2047
2048 | headingSource =
2049 | "NONE";

2050
2051
2052 | // GPS course when moving
2053 | if (gps.speed.isValid() &&
2054 | gps.course.isValid() &&
2055 | currentSpeed >=
2056 | GPS_COURSE_MIN_SPEED_MPS)
2057 | {
2058 | currentDirection =
2059 | wrap360(
2060 | gps.course.deg()
2061 | );

2062
2063
2064 | headingValid =
2065 | true;

2066
2067
2068 | headingSource =
2069 | "GPS COURSE";
2070 | }

2071
2072
2073 | // Compass when slow/stationary
2074 | else if (compassOK)
2075 | {
2076 | currentDirection =
2077 | navigationCompassHeading();

2078
2079
2080 | headingValid =
2081 | true;

2082
2083
2084 | headingSource =
2085 | "COMPASS";
2086 | }

2087
2088
2089 | // --------------------------------------------------------------
2090 | // Course error
2091 | // --------------------------------------------------------------

2092
2093 | if (headingValid)
2094 | {
2095 | courseError =
2096 | wrap180(
2097 | targetBearing -
2098 | currentDirection
2099 | );
2100 | }
2101 | }

2102
2103
2104 | // =================================================================
2105 | // AUTONOMOUS STEERING
2106 | // =================================================================

2107
2108 | void updateSteering()
2109 | {
2110 | // Manual motor test owns the servos
2111 | if (motorTestActive)
2112 | return;

2113
2114
2115 | // Servo unavailable
2116 | if (!servosReady())
2117 | {
2118 | steeringDemand = 0;

2119
2120 | return;
2121 | }

2122
2123
2124 | // Only steer during AUTONAV
2125 | if (state !=
2126 | STATE_AUTONAV)
2127 | {
2128 | return;
2129 | }

2130
2131
2132 | // GPS required
2133 | if (!gpsQualityOK())
2134 | {
2135 | centerServos();

2136
2137 | return;
2138 | }

2139
2140
2141 | // Target captured
2142 | if (distanceToTarget <=
2143 | TARGET_CAPTURE_RADIUS_M)
2144 | {
2145 | centerServos();

2146
2147 | return;
2148 | }

2149
2150
2151 | // No heading
2152 | if (!headingValid)
2153 | {
2154 | centerServos();

2155
2156 | return;
2157 | }

2158
2159
2160 | // --------------------------------------------------------------
2161 | // Absolute error
2162 | // --------------------------------------------------------------

2163
2164 | double absoluteError =
2165 | fabs(courseError);

2167
2168 | // --------------------------------------------------------------
2169 | // Deadband
2170 | // --------------------------------------------------------------

2171
2172 | if (absoluteError <=
2173 | STEERING_DEADBAND_DEG)
2174 | {
2175 | steeringDemand = 0;
2176 | }
2177 | else
2178 | {
2179 | double usableError =
2180 | absoluteError -
2181 | STEERING_DEADBAND_DEG;

2182
2183
2184 | double usableRange =
2185 | FULL_STEERING_ERROR_DEG -
2186 | STEERING_DEADBAND_DEG;

2187
2188
2189 | double normalized =
2190 | usableError /
2191 | usableRange;

2192
2193
2194 | normalized =
2195 | constrain(
2196 | normalized,
2197 | 0.0,
2198 | 1.0
2199 | );

2200
2201
2202 | int demand =
2203 | (int)round(
2204 | normalized *
2205 | MAX_STEERING_COUNTS
2206 | );

2207
2208
2209 | if (courseError > 0.0)
2210 | {
2211 | steeringDemand =
2212 | demand;
2213 | }
2214 | else
2215 | {
2216 | steeringDemand =
2217 | -demand;
2218 | }
2219 | }

2220
2221
2222 | // --------------------------------------------------------------
2223 | // Target positions
2224 | // --------------------------------------------------------------

2225
2226 | int target1 =
2227 | SERVO_NEUTRAL -
2228 | steeringDemand;

2229
2230
2231 | int target2 =
2232 | SERVO_NEUTRAL +
2233 | steeringDemand;

2234
2235
2236 | target1 =
2237 | constrain(
2238 | target1,
2239 | SERVO_MIN_POS,
2240 | SERVO_MAX_POS
2241 | );

2242
2243
2244 | target2 =
2245 | constrain(
2246 | target2,
2247 | SERVO_MIN_POS,
2248 | SERVO_MAX_POS
2249 | );

2250
2251
2252 | // --------------------------------------------------------------
2253 | // Slew limit
2254 | // --------------------------------------------------------------

2255
2256 | int new1 =
2257 | slewTo(
2258 | servo1Position,
2259 | target1,
2260 | MAX_SLEW_COUNTS
2261 | );

2262
2263
2264 | int new2 =
2265 | slewTo(
2266 | servo2Position,
2267 | target2,
2268 | MAX_SLEW_COUNTS
2269 | );

2270
2271
2272 | // --------------------------------------------------------------
2273 | // Send only if changed
2274 | // --------------------------------------------------------------

2275
2276 | if (new1 != servo1Position ||
2277 | new2 != servo2Position)
2278 | {
2279 | st.WritePosEx(
2280 | SERVO1_ID,
2281 | new1,
2282 | STEERING_SERVO_SPEED,
2283 | STEERING_SERVO_ACCEL
2284 | );

2285
2286
2287 | st.WritePosEx(
2288 | SERVO2_ID,
2289 | new2,
2290 | STEERING_SERVO_SPEED,
2291 | STEERING_SERVO_ACCEL
2292 | );

2293
2294
2295 | servo1Position =
2296 | new1;

2297
2298
2299 | servo2Position =
2300 | new2;
2301 | }
2302 | }

2303
2304
2305 | // =================================================================
2306 | // SLEW LIMIT
2307 | // =================================================================

2308
2309 | int slewTo(
2310 | int currentValue,
2311 | int targetValue,
2312 | int maxStep)
2313 | {
2314 | if (targetValue >
2315 | currentValue)
2316 | {

2317 | int difference =
2318 | targetValue -
2319 | currentValue;

2320
2321
2322 | if (difference >
2323 | maxStep)
2324 | {
2325 | return currentValue +
2326 | maxStep;
2327 | }

2328
2329
2330 | return targetValue;
2331 | }

2332
2333
2334 | if (targetValue <
2335 | currentValue)
2336 | {
2337 | int difference =
2338 | currentValue -
2339 | targetValue;

2340
2341
2342 | if (difference >
2343 | maxStep)
2344 | {
2345 | return currentValue -
2346 | maxStep;
2347 | }

2348
2349
2350 | return targetValue;
2351 | }

2352
2353
2354 | return currentValue;
2355 | }

2356
2357
2358 | // =================================================================
2359 | // DEPLOYMENT
2360 | // =================================================================

2361
2362 | void startDeployment()
2363 | {
2364 | if (deploymentDone)
2365 | {
2366 | Serial.println(
2367 | "DEPLOYMENT ALREADY COMPLETED"
2368 | );

2369
2370 | return;
2371 | }

2372
2373
2374 | if (!gpsQualityOK())
2375 | {
2376 | Serial.println(
2377 | "DEPLOY BLOCKED: GPS NOT READY"
2378 | );

2379
2380 | return;
2381 | }

2382
2383
2384 | if (!servosReady())
2385 | {
2386 | Serial.println(
2387 | "DEPLOY BLOCKED: ST-3009 NOT READY"
2388 | );

2389
2390 | return;
2391 | }

2392
2393
2394 | // Center steering first
2395 | centerServos();

2396
2397
2398 delay(100);

2399
2400
2401 | // Attach SG90
2402 | deployServo.attach(
2403 | DEPLOY_SERVO_PIN
2404 | );

2405
2406
2407 delay(100);

2408
2409
2410 | // Deployment position
2411 | deployServo.write(
2412 | DEPLOY_ANGLE
2413 | );

2414
2415
2416 | deploymentStartMs =
2417 | millis();

2418
2419
2420 | deploymentServoActive =
2421 | true;

2422
2423
2424 | deploymentDone =
2425 | true;

2426
2427
2428 | state =
2429 | STATE_DEPLOYING;

2430
2431
2432 | stateEnteredMs =
2433 | millis();

2434
2435
2436 Serial.println();

2437
2438 | Serial.println(
2439 | "========================================"
2440 | );

2441
2442 | Serial.println(
2443 | "STARTING DEPLOYMENT"
2444 | );

2445
2446 | Serial.print(
2447 | "SG90 -> "
2448 | );

2449
2450 | Serial.print(
2451 | DEPLOY_ANGLE
2452 | );

2453
2454 | Serial.println(
2455 | " degrees"
2456 | );
2457 | }

2458
2459
2460 | // =================================================================
2461 | // SG90 PREP
2462 | // =================================================================

2463
2464 | void prepareDeploymentServo()
2465 | {
2466 | deployServo.attach(

2467 | DEPLOY_SERVO_PIN
2468 | );

2469
2470
2471 delay(100);

2472
2473
2474 | deployServo.write(
2475 | PREP_ANGLE
2476 | );

2477
2478
2479 | Serial.print(
2480 | "SG90 -> "
2481 | );

2482
2483 | Serial.print(
2484 | PREP_ANGLE
2485 | );

2486
2487 | Serial.println(
2488 | " degrees"
2489 | );

2490
2491
2492 delay(1000);

2493
2494
2495 deployServo.detach();

2496
2497
2498 | Serial.println(
2499 | "SG90 detached"
2500 | );
2501 | }

2502
2503
2504 | // =================================================================
2505 | // STATE MACHINE
2506 | // =================================================================

2507
2508 | void updateStateMachine()
2509 | {
2510 | // --------------------------------------------------------------
2511 | // Manual test
2512 | // --------------------------------------------------------------

2513
2514 | if (state ==
2515 | STATE_MANUAL_TEST)
2516 | {
2517 | return;
2518 | }

2519
2520
2521 | // --------------------------------------------------------------
2522 | // WAIT READY
2523 | // --------------------------------------------------------------

2524
2525 | if (state ==
2526 | STATE_WAIT_READY)
2527 | {
2528 | if (AUTO_DEPLOY_AFTER_READY &&
2529 | !deploymentDone &&
2530 | gpsQualityOK() &&
2531 | servosReady())
2532 | {
2533 | Serial.println();

2534
2535 | Serial.println(
2536 | "GPS + ST-3009 READY"
2537 | );

2538
2539 | Serial.println(
2540 | "AUTO DEPLOY ENABLED"
2541 | );

2542
2543
2544 | startDeployment();
2545 | }

2546
2547
2548 | return;
2549 | }

2550
2551
2552 | // --------------------------------------------------------------
2553 | // DEPLOYING
2554 | // --------------------------------------------------------------

2555
2556 | if (state ==
2557 | STATE_DEPLOYING)
2558 | {
2559 | steeringDemand =
2560 | 0;

2561
2562
2563 | if (millis() -
2564 | deploymentStartMs >=
2565 | DEPLOY_MOVE_TIME_MS)
2566 | {
2567 | // Detach SG90
2568 | deployServo.detach();

2569
2570
2571 | deploymentServoActive =
2572 | false;

2573
2574
2575 | // Center steering
2576 | if (servosReady())
2577 | {
2578 | centerServos();
2579 | }

2580
2581
2582 | // Stabilization starts
2583 | stabilizationStartMs =
2584 | millis();

2585
2586
2587 | state =
2588 | STATE_STABILIZING;

2589
2590
2591 | Serial.println();

2592
2593 | Serial.println(
2594 | "SG90 detached"
2595 | );

2596
2597 | Serial.println(
2598 | "5 second stabilization started"
2599 | );
2600 | }

2601
2602
2603 | return;
2604 | }

2605
2606
2607 | // --------------------------------------------------------------
2608 | // STABILIZING
2609 | // --------------------------------------------------------------

2610
2611 | if (state ==
2612 | STATE_STABILIZING)
2613 | {
2614 | steeringDemand =
2615 | 0;

2617
2618 | if (millis() -
2619 | stabilizationStartMs >=
2620 | DEPLOY_STABILIZE_TIME_MS)
2621 | {
2622 | if (gpsQualityOK() &&
2623 | servosReady())
2624 | {
2625 | state =
2626 | STATE_AUTONAV;

2627
2628
2629 | Serial.println();

2630
2631 | Serial.println(
2632 | "========================================"
2633 | );

2634
2635 | Serial.println(
2636 | "AUTONOMOUS NAVIGATION STARTED"
2637 | );

2638
2639 | Serial.println(
2640 | "========================================"
2641 | );
2642 | }
2643 | }

2644
2645
2646 | return;
2647 | }

2648
2649
2650 | // --------------------------------------------------------------
2651 | // AUTONAV
2652 | // --------------------------------------------------------------

2653
2654 | if (state ==
2655 | STATE_AUTONAV)
2656 | {
2657 | // GPS / servo failure
2658 | if (!gpsQualityOK() ||
2659 | !servosReady())
2660 | {
2661 | steeringDemand =
2662 | 0;

2663
2664
2665 | if (servosReady())
2666 | {
2667 | centerServos();
2668 | }

2669
2670
2671 | state =
2672 | STATE_FAILSAFE;

2673
2674
2675 | failsafeGoodSinceMs =
2676 | 0;

2677
2678
2679 | Serial.println();

2680
2681 | Serial.println(
2682 | "!!! NAVIGATION FAILSAFE !!!"
2683 | );

2684
2685 | Serial.println(
2686 | "GPS or ST-3009 unavailable"
2687 | );

2688
2689
2690 | return;
2691 | }

2692
2693
2694 | // Target capture
2695 | if (distanceToTarget <=
2696 | TARGET_CAPTURE_RADIUS_M)
2697 | {
2698 | centerServos();

2699
2700
2701 | state =
2702 | STATE_CAPTURED;

2703
2704
2705 | Serial.println();

2706
2707 | Serial.println(
2708 | "========================================"
2709 | );

2710
2711 | Serial.println(
2712 | "TARGET CAPTURED"
2713 | );

2714
2715 | Serial.print(
2716 | "Distance = "
2717 | );

2718
2719 | Serial.print(
2720 | distanceToTarget,
2721 | 2
2722 | );

2723
2724 | Serial.println(
2725 | " m"
2726 | );

2727
2728 | Serial.println(
2729 | "ST-3009 -> CENTER"
2730 | );

2731
2732 | Serial.println(
2733 | "========================================"
2734 | );
2735 | }

2736
2737
2738 | return;
2739 | }

2740
2741
2742 | // --------------------------------------------------------------
2743 | // CAPTURED
2744 | // --------------------------------------------------------------

2745
2746 | if (state ==
2747 | STATE_CAPTURED)
2748 | {
2749 | steeringDemand =
2750 | 0;

2751
2752 | return;
2753 | }

2754
2755
2756 | // --------------------------------------------------------------
2757 | // FAILSAFE
2758 | // --------------------------------------------------------------

2759
2760 | if (state ==
2761 | STATE_FAILSAFE)
2762 | {
2763 | steeringDemand =
2764 | 0;

2765

2767 | if (servosReady())
2768 | {
2769 | centerServos();
2770 | }

2771
2772
2773 | if (gpsQualityOK() &&
2774 | servosReady())
2775 | {
2776 | if (failsafeGoodSinceMs ==
2777 | 0)
2778 | {
2779 | failsafeGoodSinceMs =
2780 | millis();

2781
2782
2783 | Serial.println(
2784 | "GPS + ST-3009 recovered"
2785 | );

2786
2787
2788 | Serial.println(
2789 | "Waiting 3 seconds..."
2790 | );
2791 | }
2792 | else if (millis() -
2793 | failsafeGoodSinceMs >=
2794 | FAILSAFE_RECOVERY_MS)
2795 | {
2796 | state =
2797 | STATE_AUTONAV;

2798
2799
2800 | failsafeGoodSinceMs =
2801 | 0;

2802
2803
2804 | Serial.println(
2805 | "FAILSAFE RECOVERY COMPLETE"
2806 | );

2807
2808
2809 | Serial.println(
2810 | "AUTONAV RESUMED"
2811 | );
2812 | }
2813 | }
2814 | else
2815 | {
2816 | failsafeGoodSinceMs =
2817 | 0;
2818 | }

2819
2820
2821 | return;
2822 | }
2823 | }

2824
2825
2826 | // =================================================================
2827 | // SERIAL INPUT
2828 | // =================================================================

2829
2830 | void processSerialCommands()
2831 | {
2832 | while (Serial.available() > 0)
2833 | {
2834 | char c =
2835 | (char)Serial.read();

2836
2837
2838 | // --------------------------------------------------------------
2839 | // Newline
2840 | // --------------------------------------------------------------

2842 | if (c == ’\r’ ||
2843 | c == ’\n’)
2844 | {
2845 | if (commandIndex > 0)
2846 | {
2847 | commandBuffer[
2848 | commandIndex] =
2849 | ’\0’;

2850
2851
2852 | processCommand(
2853 | commandBuffer
2854 | );

2855
2856
2857 | commandIndex =
2858 | 0;
2859 | }

2860
2861
2862 | continue;
2863 | }

2864
2865
2866 | // --------------------------------------------------------------
2867 | // Store
2868 | // --------------------------------------------------------------

2869
2870 | if (commandIndex <
2871 | COMMAND_BUFFER_SIZE - 1)
2872 | {
2873 | commandBuffer[
2874 | commandIndex++] =
2875 | c;
2876 | }
2877 | else
2878 | {
2879 | commandIndex = 0;

2880
2881 | Serial.println(
2882 | "ERROR: COMMAND TOO LONG"
2883 | );
2884 | }
2885 | }
2886 | }

2887
2888
2889 | // =================================================================
2890 | // COMMAND PROCESSOR
2891 | // =================================================================

2892
2893 | void processCommand(
2894 | char *cmd)
2895 | {
2896 | // Remove leading spaces
2897 | while (*cmd == ’ ’ ||
2898 | *cmd == ’\t’)
2899 | {
2900 | cmd++;
2901 | }

2902
2903
2904 | // Remove trailing spaces
2905 | int len =
2906 | strlen(cmd);

2907
2908
2909 | while (len > 0 &&
2910 | (cmd[len - 1] == ’ ’ ||
2911 | cmd[len - 1] == ’\t’))
2912 | {
2913 | cmd[len - 1] =
2914 | ’\0’;

2915
2916 | len--;

2917 | }

2918
2919
2920 | if (len == 0)
2921 | return;

2922
2923
2924 | Serial.print(
2925 | "CMD RECEIVED: ["
2926 | );

2927
2928 | Serial.print(
2929 | cmd
2930 | );

2931
2932 | Serial.println(
2933 | "]"
2934 | );

2935
2936
2937 | // ==============================================================
2938 | // STATUS
2939 | // ==============================================================

2940
2941 | if (strcmp(
2942 | cmd,
2943 | "STATUS") == 0)
2944 | {
2945 | printStatus();
2946 | return;
2947 | }

2948
2949
2950 | // ==============================================================
2951 | // MOTORTEST
2952 | // ==============================================================

2953
2954 | if (strcmp(
2955 | cmd,
2956 | "MOTORTEST") == 0)
2957 | {
2958 | startMotorTest();
2959 | return;
2960 | }

2961
2962
2963 | // ==============================================================
2964 | // LEFT
2965 | // ==============================================================

2966
2967 | if (strcmp(
2968 | cmd,
2969 | "LEFT") == 0)
2970 | {
2971 | motorTestActive =
2972 | false;

2973
2974
2975 | state =
2976 | STATE_MANUAL_TEST;

2977
2978
2979 | commandSteering(
2980 | +300
2981 | );

2982
2983
2984 | return;
2985 | }

2986
2987
2988 | // ==============================================================
2989 | // RIGHT
2990 | // ==============================================================

2992 | if (strcmp(
2993 | cmd,
2994 | "RIGHT") == 0)
2995 | {
2996 | motorTestActive =
2997 | false;

2998
2999
3000 | state =
3001 | STATE_MANUAL_TEST;

3002
3003
3004 | commandSteering(
3005 | -300
3006 | );

3007
3008
3009 | return;
3010 | }

3011
3012
3013 | // ==============================================================
3014 | // CENTER
3015 | // ==============================================================

3016
3017 | if (strcmp(
3018 | cmd,
3019 | "CENTER") == 0)
3020 | {
3021 | motorTestActive =
3022 | false;

3023
3024
3025 | if (servosReady())
3026 | {
3027 | centerServos();

3028
3029
3030 | Serial.println(
3031 | "ST-3009 -> CENTER"
3032 | );
3033 | }
3034 | else
3035 | {
3036 | Serial.println(
3037 | "ST-3009 BUS NOT READY"
3038 | );
3039 | }

3040
3041
3042 | state =
3043 | STATE_WAIT_READY;

3044
3045
3046 | return;
3047 | }

3048
3049
3050 | // ==============================================================
3051 | // AUTONAV
3052 | // ==============================================================

3053
3054 | if (strcmp(
3055 | cmd,
3056 | "AUTONAV") == 0)
3057 | {
3058 | motorTestActive =
3059 | false;

3060
3061
3062 | if (gpsQualityOK() &&
3063 | servosReady())
3064 | {
3065 | state =
3066 | STATE_AUTONAV;

3067
3068
3069 | Serial.println(
3070 | "AUTONAV ENABLED"
3071 | );
3072 | }
3073 | else
3074 | {
3075 | Serial.println(
3076 | "AUTONAV BLOCKED"
3077 | );

3078
3079
3080 | Serial.print(
3081 | "GPS = "
3082 | );

3083
3084 | Serial.println(
3085 | gpsQualityOK()
3086 | ? "GOOD"
3087 | : "BAD"
3088 | );

3089
3090
3091 | Serial.print(
3092 | "SERVO = "
3093 | );

3094
3095 | Serial.println(
3096 | servosReady()
3097 | ? "GOOD"
3098 | : "BAD"
3099 | );
3100 | }

3101
3102
3103 | return;
3104 | }

3105
3106
3107 | // ==============================================================
3108 | // DEPLOY
3109 | // ==============================================================

3110
3111 | if (strcmp(
3112 | cmd,
3113 | "DEPLOY") == 0)
3114 | {
3115 | motorTestActive =
3116 | false;

3117
3118
3119 | startDeployment();

3120
3121 | return;
3122 | }

3123
3124
3125 | // ==============================================================
3126 | // PREP
3127 | // ==============================================================

3128
3129 | if (strcmp(
3130 | cmd,
3131 | "PREP") == 0)
3132 | {
3133 | motorTestActive =
3134 | false;

3135
3136
3137 | prepareDeploymentServo();

3138
3139 | return;
3140 | }

3142
3143 | // ==============================================================
3144 | // RESET
3145 | // ==============================================================

3146
3147 | if (strcmp(
3148 | cmd,
3149 | "RESET") == 0)
3150 | {
3151 | motorTestActive =
3152 | false;

3153
3154
3155 | resetSystem();

3156
3157 | return;
3158 | }

3159
3160
3161 | // ==============================================================
3162 | // HELP
3163 | // ==============================================================

3164
3165 | if (strcmp(
3166 | cmd,
3167 | "HELP") == 0)
3168 | {
3169 | Serial.println();

3170
3171 | Serial.println(
3172 | "STATUS"
3173 | );

3174
3175 | Serial.println(
3176 | "MOTORTEST"
3177 | );

3178
3179 | Serial.println(
3180 | "LEFT"
3181 | );

3182
3183 | Serial.println(
3184 | "RIGHT"
3185 | );

3186
3187 | Serial.println(
3188 | "CENTER"
3189 | );

3190
3191 | Serial.println(
3192 | "AUTONAV"
3193 | );

3194
3195 | Serial.println(
3196 | "DEPLOY"
3197 | );

3198
3199 | Serial.println(
3200 | "PREP"
3201 | );

3202
3203 | Serial.println(
3204 | "RESET"
3205 | );

3206
3207 | Serial.println(
3208 | "HELP"
3209 | );

3210
3211
3212 | Serial.println();

3213
3214 | Serial.println(
3215 | "TARGET IS FIXED IN CODE"
3216 | );

3217
3218
3219 | return;
3220 | }

3221
3222
3223 | // Unknown
3224 | Serial.print(
3225 | "UNKNOWN COMMAND: "
3226 | );

3227
3228 | Serial.println(
3229 | cmd
3230 | );
3231 | }

3232
3233
3234 | // =================================================================
3235 | // RESET
3236 | // =================================================================

3237
3238 | void resetSystem()
3239 | {
3240 | // Stop deployment servo
3241 | if (deploymentServoActive)
3242 | {
3243 | deployServo.detach();

3244
3245 | deploymentServoActive =
3246 | false;
3247 | }

3248
3249
3250 | // Stop motor test
3251 | motorTestActive =
3252 | false;

3253
3254
3255 | // Center if available
3256 | if (servosReady())
3257 | {
3258 | centerServos();
3259 | }

3260
3261
3262 | // Reset flags
3263 | deploymentDone =
3264 | false;

3265
3266
3267 | steeringDemand =
3268 | 0;

3269
3270
3271 | failsafeGoodSinceMs =
3272 | 0;

3273
3274
3275 | // Return to wait state
3276 | state =
3277 | STATE_WAIT_READY;

3278
3279
3280 | stateEnteredMs =
3281 | millis();

3282
3283
3284 Serial.println();

3285
3286 | Serial.println(
3287 | "========================================"
3288 | );

3289
3290 | Serial.println(
3291 | "SYSTEM RESET"

3292 | );

3293
3294 | Serial.print(
3295 | "TARGET = "
3296 | );

3297
3298 | Serial.print(
3299 | TARGET_LAT,
3300 | 7
3301 | );

3302
3303 | Serial.print(
3304 | ", "
3305 | );

3306
3307 | Serial.println(
3308 | TARGET_LON,
3309 | 7
3310 | );

3311
3312 | Serial.println(
3313 | "========================================"
3314 | );
3315 | }

3316
3317
3318 | // =================================================================
3319 | // STATUS
3320 | // =================================================================

3321
3322 | void printStatus()
3323 | {
3324 | Serial.println();

3325
3326 | Serial.println(
3327 | "================================================"
3328 | );

3329
3330 | Serial.println(
3331 | " | STATUS"
3332 | );

3333
3334 | Serial.println(
3335 | "================================================"
3336 | );

3337
3338
3339 | // System
3340 | Serial.print(
3341 | "State | : "
3342 | );

3343
3344 | Serial.println(
3345 | stateName(state)
3346 | );

3347
3348
3349 | // Target
3350 | Serial.print(
3351 | "Target latitude | : "
3352 | );

3353
3354 | Serial.println(
3355 | TARGET_LAT,
3356 | 7
3357 | );

3358
3359
3360 | Serial.print(
3361 | "Target longitude | : "
3362 | );

3363
3364 | Serial.println(
3365 | TARGET_LON,
3366 | 7

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
3881 | " IMU="
3882 | );

3883
3884 | Serial.print(
3885 | imuOK
3886 | ? "OK"
3887 | : "FAIL"
3888 | );

3889
3890
3891 // Servos

3892 | Serial.print(
3893 | " SERVO="
3894 | );

3895
3896 | Serial.println(
3897 | servosReady()
3898 | ? "OK"
3899 | : "FAIL"
3900 | );
3901 | }

3902
3903
3904 | // =================================================================
3905 | // STATE NAME
3906 | // =================================================================

3907
3908 | const char *stateName(
3909 | SystemState s)
3910 | {
3911 | switch (s)
3912 | {
3913 | case STATE_WAIT_READY:
3914 | return "WAIT_READY";

3915
3916
3917 | case STATE_DEPLOYING:
3918 | return "DEPLOYING";

3919
3920
3921 | case STATE_STABILIZING:
3922 | return "STABILIZING";

3923
3924
3925 | case STATE_AUTONAV:
3926 | return "AUTONAV";

3927
3928
3929 | case STATE_CAPTURED:
3930 | return "CAPTURED";

3931
3932
3933 | case STATE_FAILSAFE:
3934 | return "FAILSAFE";

3935
3936
3937 | case STATE_MANUAL_TEST:
3938 | return "MANUAL_TEST";

3939
3940
3941 | default:
3942 | return "UNKNOWN";
3943 | }
3944 | }
A.5 | Archived source 5: Pasted text(20261003-150406).txt

## Source file: Pasted text(20261003-150406).txt

1 | /*
2 | =================================================================
3 | TEENSY 4.1 AUTONOMOUS PARAFOIL
4 | GUIDED LANDING - FINAL LAB TEST
5 | =================================================================

6
7 TARGET IS FIXED IN CODE.

8
9 | CHANGE ONLY:
10 | TARGET_LAT
11 | TARGET_LON

12
13
14 | =================================================================
15 | HARDWARE

16 =================================================================

17
18 TEENSY 4.1

19
20 | -----------------------------------------------------------------
21 | FOXEER M10Q 180 GPS
22 | -----------------------------------------------------------------

23
24 | GPS TX | -> Teensy Pin 15 (RX3)
25 | GPS RX | -> Teensy Pin 14 (TX3)
26 | GPS GND -> Teensy GND

27
28 | GPS UART = Serial3
29 | GPS BAUD = 38400

30
31 | -----------------------------------------------------------------
32 | I2C BUS
33 | -----------------------------------------------------------------

34
35 | SDA = Teensy Pin 18
36 | SCL = Teensy Pin 19

37
38 | -----------------------------------------------------------------
39 | QMC5883 COMPASS
40 | -----------------------------------------------------------------

41
42 | Address = 0x0D

43
44 | -----------------------------------------------------------------
45 | LSM6DSO32 IMU
46 | -----------------------------------------------------------------

47
48 | Address = 0x6A

49
50 | -----------------------------------------------------------------
51 | BMP581
52 | -----------------------------------------------------------------

53
54 | Address = 0x46 or 0x47
55 | Diagnostic only

56
57 | -----------------------------------------------------------------
58 | ST-3009
59 | -----------------------------------------------------------------

60
61 | Servo 1 ID = 1
62 | Servo 2 ID = 2

63
64 | Serial1
65 | Pin 0 = RX1
66 | Pin 1 = TX1

67
68 | 1 Mbps
69 | SERIAL_8N1_HALF_DUPLEX

70
71 | Servo neutral = 2048

72
73 | -----------------------------------------------------------------
74 | SG90 DEPLOYMENT SERVO
75 | -----------------------------------------------------------------

76
77 | Signal = Pin 8

78
79 | =================================================================
80 | NAVIGATION
81 | =================================================================

82
83 | Target bearing:
84 | GPS position -> target

85
86 Current heading:

87
88 | If speed >= 1.5 m/s:
89 | GPS course

91 | If speed < 1.5 m/s:
92 | QMC5883 compass

93
94 Course error:

95
96 | target bearing - current heading

97
98 | wrapped to -180 ... +180 degrees

99
100 Steering:

101
102 | error <= +/-5 degrees:
103 | neutral

104
105 | error reaches +/-90 degrees:
106 | maximum steering

107
108 | Maximum steering:
109 | +/-450 counts

110
111 Differential:

112
113 | Positive demand:
114 | Servo 1 = 2048 - demand
115 | Servo 2 = 2048 + demand

116
117 | Negative demand:
118 | Servo 1 = 2048 - demand
119 | Servo 2 = 2048 + demand

120
121 | Target capture:
122 | 35 m

123
124 | =================================================================
125 | STATE MACHINE
126 | =================================================================

127
128 | WAIT_READY
129 | |
130 | | GPS GOOD + Servo 1 + Servo 2
131 | v
132 | DEPLOYING
133 | |
134 | | 1.5 sec
135 | v
136 | STABILIZING
137 | |
138 | | 5 sec + GPS + servos
139 | v
140 | AUTONAV
141 | |
142 | | <=35 m
143 | v
144 | CAPTURED

145
146 | GPS or servo failure during AUTONAV:
147 | AUTONAV -> FAILSAFE

148
149 | 3 sec good GPS + servos:
150 | FAILSAFE -> AUTONAV

151
152 | =================================================================
153 | SERIAL COMMANDS
154 | =================================================================

155
156 | STATUS
157 | MOTORTEST
158 | LEFT
159 | RIGHT
160 | CENTER
161 | AUTONAV
162 | DEPLOY
163 | PREP
164 | RESET
165 | HELP

166
167 There is NO TARGET serial command.

168
169 | =================================================================
170 | */

171
172
173 | // =================================================================
174 | // LIBRARIES
175 | // =================================================================

176
177 | #include <Arduino.h>
178 | #include <Wire.h>
179 | #include <Servo.h>
180 | #include <TinyGPS++.h>
181 | #include <SCServo.h>
182 | #include <Adafruit_LSM6DSOX.h>

183
184 | #include <math.h>
185 | #include <string.h>

186
187
188 | // =================================================================
189 | // TARGET
190 | // =================================================================

191
192 | const double TARGET_LAT = 32.639340;
193 | const double TARGET_LON = 75.014533;

194
195
196 | // =================================================================
197 | // AUTO DEPLOY
198 | // =================================================================
199 | //
200 | // true | = deploy automatically after GPS + both ST-3009 ready
201 | // false = wait for DEPLOY command
202 | //
203 | // For the autonomous lab sequence use TRUE.
204 | // =================================================================

205
206 const bool AUTO_DEPLOY_AFTER_READY = true;

207
208
209 | // =================================================================
210 | // GPS
211 | // =================================================================

212
213 #define GPS_SERIAL Serial3

214
215 const uint32_t GPS_BAUD = 38400;

216
217 | const uint8_t GPS_RX_PIN = 15;
218 | const uint8_t GPS_TX_PIN = 14;

219
220 | // GPS data considered stale after this time
221 | const uint32_t GPS_DATA_TIMEOUT_MS = 2500;

222
223 | // Minimum satellites
224 | const uint8_t GPS_MIN_SATS = 5;

225
226 | // Maximum acceptable HDOP
227 | const double GPS_MAX_HDOP = 3.5;

228
229 | // GPS course is used only above this speed
230 | const double GPS_COURSE_MIN_SPEED_MPS = 1.5;

231
232
233 | // =================================================================
234 | // I2C
235 | // =================================================================

236
237 | const uint8_t I2C_SDA_PIN = 18;
238 | const uint8_t I2C_SCL_PIN = 19;

239

241 | // =================================================================
242 | // QMC5883
243 | // =================================================================

244
245 const uint8_t QMC5883_ADDR = 0x0D;

246
247
248 | // -----------------------------------------------------------------
249 | // Compass navigation orientation
250 | // -----------------------------------------------------------------
251 | //
252 | // Your tested compass direction was mirrored for navigation.
253 | //

254
255 const bool COMPASS_MIRROR_FOR_NAV = true;

256
257 const float COMPASS_HEADING_OFFSET_DEG = 0.0f;

258
259
260 | // -----------------------------------------------------------------
261 | // Calibration values from your working compass test
262 | // -----------------------------------------------------------------

263
264 | const float OFFSET_X = 180.0000f;
265 | const float OFFSET_Y = 336.0000f;
266 | const float OFFSET_Z = 615.0000f;

267
268 | const float SCALE_X = 0.956484f;
269 | const float SCALE_Y = 0.904406f;
270 | const float SCALE_Z = 1.178127f;

271
272
273 | // =================================================================
274 | // LSM6DSO32
275 | // =================================================================

276
277 const uint8_t LSM6DSO32_ADDR = 0x6A;

278
279 Adafruit_LSM6DSOX lsm6dso;

280
281 bool imuOK = false;

282
283
284 | // =================================================================
285 | // BMP581
286 | // =================================================================

287
288 | const uint8_t BMP581_ADDR_1 = 0x46;
289 | const uint8_t BMP581_ADDR_2 = 0x47;

290
291 bool bmpOK = false;

292
293 uint8_t bmpAddress = 0;

294
295
296 | // =================================================================
297 | // GPS VARIABLES
298 | // =================================================================

299
300 TinyGPSPlus gps;

301
302 bool gpsFix = false;

303
304 uint8_t gpsSats = 0;

305
306 double gpsHDOP = 99.9;

307
308 double currentSpeed = 0.0;

309
310 unsigned long lastGPSLocationMs = 0;

311
312
313 | // =================================================================
314 | // COMPASS VARIABLES
315 | // =================================================================

316
317 bool compassOK = false;

318
319 | int16_t rawMagX = 0;
320 | int16_t rawMagY = 0;
321 | int16_t rawMagZ = 0;

322
323 | float magX = 0.0f;
324 | float magY = 0.0f;
325 | float magZ = 0.0f;

326
327 | float compassHeading = 0.0f;
328 | float navCompassHeading = 0.0f;

329
330 uint8_t compassFailCount = 0;

331
332
333 | // =================================================================
334 | // IMU VARIABLES
335 | // =================================================================

336
337 | float accelX = 0.0f;
338 | float accelY = 0.0f;
339 | float accelZ = 0.0f;

340
341 | float gyroX = 0.0f;
342 | float gyroY = 0.0f;
343 | float gyroZ = 0.0f;

344
345 unsigned long lastSensorUpdateMs = 0;

346
347
348 | // =================================================================
349 | // ST-3009
350 | // =================================================================
351 | //
352 | // IMPORTANT:
353 | // SCServo 1.0.2 uses:
354 | //
355 | // | SMS_STS
356 | //

357
358 SMS_STS st;

359
360
361 | // -----------------------------------------------------------------
362 | // Servo IDs
363 | // -----------------------------------------------------------------

364
365 | const uint8_t SERVO1_ID = 1;
366 | const uint8_t SERVO2_ID = 2;

367
368
369 | // -----------------------------------------------------------------
370 | // Servo positions
371 | // -----------------------------------------------------------------

372
373 const int SERVO_NEUTRAL = 2048;

374
375 | const int SERVO_MIN_POS = 200;
376 | const int SERVO_MAX_POS = 3895;

377
378
379 | // -----------------------------------------------------------------
380 | // Steering
381 | // -----------------------------------------------------------------

382
383 const int MAX_STEERING_COUNTS = 450;

384
385 | const int STEERING_SERVO_SPEED = 500;
386 | const int STEERING_SERVO_ACCEL = 50;

387
388 const int MAX_SLEW_COUNTS = 60;

389

391 | // -----------------------------------------------------------------
392 | // Servo health
393 | // -----------------------------------------------------------------

394
395 const unsigned long SERVO_HEALTH_INTERVAL_MS = 2000;

396
397 | bool servo1OK = false;
398 | bool servo2OK = false;
399 | bool servoBusReady = false;

400
401 unsigned long lastServoHealthMs = 0;

402
403
404 | // -----------------------------------------------------------------
405 | // Current positions
406 | // -----------------------------------------------------------------

407
408 | int servo1Position = SERVO_NEUTRAL;
409 | int servo2Position = SERVO_NEUTRAL;

410
411
412 | // -----------------------------------------------------------------
413 | // Current navigation demand
414 | // -----------------------------------------------------------------

415
416 int steeringDemand = 0;

417
418
419 | // =================================================================
420 | // SG90 DEPLOYMENT
421 | // =================================================================

422
423 Servo deployServo;

424
425 const uint8_t DEPLOY_SERVO_PIN = 8;

426
427 const int DEPLOY_ANGLE = 180;

428
429 const int PREP_ANGLE = 140;

430
431 const unsigned long DEPLOY_MOVE_TIME_MS = 1500;

432
433 const unsigned long DEPLOY_STABILIZE_TIME_MS = 5000;

434
435 bool deploymentServoActive = false;

436
437 bool deploymentDone = false;

438
439 unsigned long deploymentStartMs = 0;

440
441 unsigned long stabilizationStartMs = 0;

442
443
444 | // =================================================================
445 | // NAVIGATION
446 | // =================================================================

447
448 const double TARGET_CAPTURE_RADIUS_M = 35.0;

449
450 const double STEERING_DEADBAND_DEG = 5.0;

451
452 const double FULL_STEERING_ERROR_DEG = 90.0;

453
454
455 | // =================================================================
456 | // STATE MACHINE
457 | // =================================================================

458
459 | enum SystemState
460 | {
461 | STATE_WAIT_READY,
462 | STATE_DEPLOYING,
463 | STATE_STABILIZING,
464 | STATE_AUTONAV,
465 | STATE_CAPTURED,

466 | STATE_FAILSAFE,
467 | STATE_MANUAL_TEST
468 | };

469
470 SystemState state = STATE_WAIT_READY;

471
472 unsigned long stateEnteredMs = 0;

473
474
475 | // =================================================================
476 | // NAVIGATION VARIABLES
477 | // =================================================================

478
479 double currentLatitude = 0.0;

480
481 double currentLongitude = 0.0;

482
483 double distanceToTarget = 0.0;

484
485 double targetBearing = 0.0;

486
487 double currentDirection = 0.0;

488
489 double courseError = 0.0;

490
491 bool headingValid = false;

492
493 const char *headingSource = "NONE";

494
495
496 | // =================================================================
497 | // FAILSAFE
498 | // =================================================================

499
500 unsigned long failsafeGoodSinceMs = 0;

501
502 const unsigned long FAILSAFE_RECOVERY_MS = 3000;

503
504
505 | // =================================================================
506 | // SERIAL COMMAND BUFFER
507 | // =================================================================

508
509 #define COMMAND_BUFFER_SIZE 120

510
511 char commandBuffer[COMMAND_BUFFER_SIZE];

512
513 uint16_t commandIndex = 0;

514
515
516 | // =================================================================
517 | // TIMERS
518 | // =================================================================

519
520 unsigned long lastNavigationUpdateMs = 0;

521
522 const unsigned long NAVIGATION_UPDATE_INTERVAL_MS = 100;

523
524 unsigned long lastLivePrintMs = 0;

525
526 const unsigned long LIVE_PRINT_INTERVAL_MS = 1000;

527
528 unsigned long lastBMPCheckMs = 0;

529
530 const unsigned long BMP_CHECK_INTERVAL_MS = 3000;

531
532
533 | // =================================================================
534 | // MOTOR TEST
535 | // =================================================================

536
537 bool motorTestActive = false;

538
539 uint8_t motorTestStep = 0;

541 unsigned long motorTestTimer = 0;

542
543
544 | // =================================================================
545 | // FORWARD DECLARATIONS
546 | // =================================================================

547
548 | void processSerialCommands();
549 | void processCommand(char *cmd);

550
551 | void updateGPS();
552 | void updateCompass();
553 | void updateIMU();
554 | void updateServoHealth();

555
556 | void updateNavigation();
557 | void updateSteering();
558 | void updateStateMachine();

559
560 | void writeSteeringPositions(int pos1, int pos2);
561 | void centerServos();
562 | void commandSteering(int demand);

563
564 | void startDeployment();
565 | void prepareDeploymentServo();
566 | void resetSystem();

567
568 | void startMotorTest();
569 | void updateMotorTest();

570
571 | void printStatus();
572 | void printLiveData();

573
574 | bool gpsQualityOK();
575 | bool readQMC5883();
576 | bool initQMC5883();

577
578 | bool checkI2CDevice(uint8_t address);
579 | bool initIMU();

580
581 bool servosReady();

582
583 | float wrap360(float angle);
584 | double wrap180(double angle);
585 | float navigationCompassHeading();

586
587 const char *stateName(SystemState s);

588
589 | int slewTo(
590 | int currentValue,
591 | int targetValue,
592 | int maxStep
593 | );

594
595
596 | // =================================================================
597 | // SETUP
598 | // =================================================================

599
600 | void setup()
601 | {
602 | // ----------------------------------------------------------------
603 | // USB SERIAL
604 | // ----------------------------------------------------------------

605
606 Serial.begin(115200);

607
608 delay(1500);

609
610
611 | Serial.println();
612 | Serial.println(
613 | "================================================"
614 | );

616 | Serial.println(
617 | " TEENSY 4.1 AUTONOMOUS PARAFOIL"
618 | );

619
620 | Serial.println(
621 | " GUIDED LANDING - FINAL LAB TEST"
622 | );

623
624 | Serial.println(
625 | "================================================"
626 | );

627
628
629 | // ----------------------------------------------------------------
630 | // TARGET
631 | // ----------------------------------------------------------------

632
633 Serial.println();

634
635 | Serial.print(
636 | "TARGET LATITUDE | : "
637 | );

638
639 | Serial.println(
640 | TARGET_LAT,
641 | 7
642 | );

643
644
645 | Serial.print(
646 | "TARGET LONGITUDE : "
647 | );

648
649 | Serial.println(
650 | TARGET_LON,
651 | 7
652 | );

653
654
655 | // ----------------------------------------------------------------
656 | // I2C
657 | // ----------------------------------------------------------------

658
659 Wire.begin();

660
661 Wire.setClock(400000);

662
663
664 Serial.println();

665
666 | Serial.println(
667 | "I2C initialized"
668 | );

669
670 | Serial.println(
671 | "SDA = Pin 18"
672 | );

673
674 | Serial.println(
675 | "SCL = Pin 19"
676 | );

677
678
679 | // ----------------------------------------------------------------
680 | // QMC5883
681 | // ----------------------------------------------------------------

682
683 | if (initQMC5883())
684 | {
685 | compassOK = true;

686
687 | Serial.println(
688 | "QMC5883 : OK"
689 | );
690 | }

691 | else
692 | {
693 | compassOK = false;

694
695 | Serial.println(
696 | "QMC5883 : NOT FOUND"
697 | );
698 | }

699
700
701 | // ----------------------------------------------------------------
702 | // LSM6DSO32
703 | // ----------------------------------------------------------------

704
705 | if (initIMU())
706 | {
707 | imuOK = true;

708
709 | Serial.println(
710 | "LSM6DSO32 : OK"
711 | );
712 | }
713 | else
714 | {
715 | imuOK = false;

716
717 | Serial.println(
718 | "LSM6DSO32 : NOT FOUND"
719 | );
720 | }

721
722
723 | // ----------------------------------------------------------------
724 | // BMP581
725 | // ----------------------------------------------------------------

726
727 | if (checkI2CDevice(
728 | BMP581_ADDR_1))
729 | {
730 | bmpOK = true;

731
732 | bmpAddress =
733 | BMP581_ADDR_1;
734 | }
735 | else if (checkI2CDevice(
736 | BMP581_ADDR_2))
737 | {
738 | bmpOK = true;

739
740 | bmpAddress =
741 | BMP581_ADDR_2;
742 | }
743 | else
744 | {
745 | bmpOK = false;

746
747 | bmpAddress = 0;
748 | }

749
750
751 | if (bmpOK)
752 | {
753 | Serial.print(
754 | "BMP581 : FOUND at 0x"
755 | );

756
757 | if (bmpAddress < 16)
758 | Serial.print("0");

759
760 | Serial.println(
761 | bmpAddress,
762 | HEX
763 | );
764 | }
765 | else

766 | {
767 | Serial.println(
768 | "BMP581 : NOT FOUND"
769 | );
770 | }

771
772
773 | // ----------------------------------------------------------------
774 | // GPS
775 | // ----------------------------------------------------------------
776 | //
777 | // EXACTLY MATCHES YOUR WORKING GPS TEST
778 | //

779
780 | GPS_SERIAL.begin(
781 | GPS_BAUD
782 | );

783
784
785 Serial.println();

786
787 | Serial.println(
788 | "GPS UART | : Serial3"
789 | );

790
791 | Serial.print(
792 | "GPS RX | : Pin "
793 | );

794
795 | Serial.println(
796 | GPS_RX_PIN
797 | );

798
799 | Serial.print(
800 | "GPS TX | : Pin "
801 | );

802
803 | Serial.println(
804 | GPS_TX_PIN
805 | );

806
807 | Serial.print(
808 | "GPS BAUD | : "
809 | );

810
811 | Serial.println(
812 | GPS_BAUD
813 | );

814
815
816 | // ----------------------------------------------------------------
817 | // ST-3009
818 | // ----------------------------------------------------------------

819
820 Serial.println();

821
822 | Serial.println(
823 | "Initializing ST-3009 bus..."
824 | );

825
826
827 | Serial1.begin(
828 | 1000000,
829 | SERIAL_8N1_HALF_DUPLEX
830 | );

831
832
833 | st.pSerial =
834 | &Serial1;

835
836
837 delay(500);

838
839
840 // Force immediate first health test

841 | lastServoHealthMs =
842 | millis() -
843 | SERVO_HEALTH_INTERVAL_MS;

844
845
846 updateServoHealth();

847
848
849 | if (servosReady())
850 | {
851 | Serial.println(
852 | "ST-3009 ID 1 : OK"
853 | );

854
855 | Serial.println(
856 | "ST-3009 ID 2 : OK"
857 | );

858
859
860 | centerServos();
861 | }
862 | else
863 | {
864 | Serial.println(
865 | "ST-3009 : WAITING"
866 | );
867 | }

868
869
870 | // ----------------------------------------------------------------
871 | // SG90
872 | // ----------------------------------------------------------------

873
874 deployServo.detach();

875
876 | deploymentServoActive =
877 | false;

878
879
880 | // ----------------------------------------------------------------
881 | // State
882 | // ----------------------------------------------------------------

883
884 | state =
885 | STATE_WAIT_READY;

886
887 | stateEnteredMs =
888 | millis();

889
890
891 Serial.println();

892
893 | Serial.println(
894 | "================================================"
895 | );

896
897 | Serial.println(
898 | "SYSTEM READY"
899 | );

900
901 | Serial.println(
902 | "Target is fixed in code."
903 | );

904
905 | Serial.println(
906 | "================================================"
907 | );

908
909
910 Serial.println();

911
912 | Serial.println(
913 | "COMMANDS:"
914 | );

916 | Serial.println(
917 | "STATUS"
918 | );

919
920 | Serial.println(
921 | "MOTORTEST"
922 | );

923
924 | Serial.println(
925 | "LEFT"
926 | );

927
928 | Serial.println(
929 | "RIGHT"
930 | );

931
932 | Serial.println(
933 | "CENTER"
934 | );

935
936 | Serial.println(
937 | "AUTONAV"
938 | );

939
940 | Serial.println(
941 | "DEPLOY"
942 | );

943
944 | Serial.println(
945 | "PREP"
946 | );

947
948 | Serial.println(
949 | "RESET"
950 | );

951
952 | Serial.println(
953 | "HELP"
954 | );

955
956
957 Serial.println();

958
959 | Serial.println(
960 | "Waiting for GPS + ST-3009..."
961 | );
962 | }

963
964
965 | // =================================================================
966 | // LOOP
967 | // =================================================================

968
969 | void loop()
970 | {
971 | // GPS continuously
972 | updateGPS();

973
974
975 | // Serial commands
976 | processSerialCommands();

977
978
979 | // Sensors
980 | if (millis() -
981 | lastSensorUpdateMs >=
982 | 100)
983 | {
984 | lastSensorUpdateMs =
985 | millis();

986
987 | updateCompass();
988 | updateIMU();
989 | }

991
992 | // Servo health
993 | updateServoHealth();

994
995
996 | // Motor test
997 | if (motorTestActive)
998 | {
999 | updateMotorTest();
1000 | }

1001
1002
1003 | // State
1004 | updateStateMachine();

1005
1006
1007 | // Navigation
1008 | if (millis() -
1009 | lastNavigationUpdateMs >=
1010 | NAVIGATION_UPDATE_INTERVAL_MS)
1011 | {
1012 | lastNavigationUpdateMs =
1013 | millis();

1014
1015 | updateNavigation();
1016 | updateSteering();
1017 | }

1018
1019
1020 | // BMP check
1021 | if (millis() -
1022 | lastBMPCheckMs >=
1023 | BMP_CHECK_INTERVAL_MS)
1024 | {
1025 | lastBMPCheckMs =
1026 | millis();

1027
1028
1029 | if (!bmpOK)
1030 | {
1031 | if (checkI2CDevice(
1032 | BMP581_ADDR_1))
1033 | {
1034 | bmpOK = true;

1035
1036 | bmpAddress =
1037 | BMP581_ADDR_1;
1038 | }
1039 | else if (checkI2CDevice(
1040 | BMP581_ADDR_2))
1041 | {
1042 | bmpOK = true;

1043
1044 | bmpAddress =
1045 | BMP581_ADDR_2;
1046 | }
1047 | }
1048 | }

1049
1050
1051 | // Live data
1052 | if (millis() -
1053 | lastLivePrintMs >=
1054 | LIVE_PRINT_INTERVAL_MS)
1055 | {
1056 | lastLivePrintMs =
1057 | millis();

1058
1059 | printLiveData();
1060 | }
1061 | }

1062
1063
1064 | // =================================================================
1065 | // GPS UPDATE

1066 // =================================================================

1067
1068 | void updateGPS()
1069 | {
1070 | while (GPS_SERIAL.available() > 0)
1071 | {
1072 | char c =
1073 | (char)GPS_SERIAL.read();

1074
1075 | gps.encode(c);
1076 | }

1077
1078
1079 | // Fresh GPS location
1080 | if (gps.location.isUpdated())
1081 | {
1082 | lastGPSLocationMs =
1083 | millis();
1084 | }

1085
1086
1087 | // Position
1088 | if (gps.location.isValid())
1089 | {
1090 | gpsFix = true;

1091
1092 | currentLatitude =
1093 | gps.location.lat();

1094
1095 | currentLongitude =
1096 | gps.location.lng();
1097 | }
1098 | else
1099 | {
1100 | gpsFix = false;
1101 | }

1102
1103
1104 | // Satellites
1105 | if (gps.satellites.isValid())
1106 | {
1107 | gpsSats =
1108 | gps.satellites.value();
1109 | }
1110 | else
1111 | {
1112 | gpsSats = 0;
1113 | }

1114
1115
1116 | // HDOP
1117 | if (gps.hdop.isValid())
1118 | {
1119 | gpsHDOP =
1120 | gps.hdop.hdop();
1121 | }
1122 | else
1123 | {
1124 | gpsHDOP = 99.9;
1125 | }

1126
1127
1128 | // Speed
1129 | if (gps.speed.isValid())
1130 | {
1131 | currentSpeed =
1132 | gps.speed.mps();
1133 | }
1134 | else
1135 | {
1136 | currentSpeed = 0.0;
1137 | }
1138 | }

1139

1141 | // =================================================================
1142 | // GPS QUALITY
1143 | // =================================================================

1144
1145 | bool gpsQualityOK()
1146 | {
1147 | if (!gpsFix)
1148 | return false;

1149
1150
1151 | if (lastGPSLocationMs == 0)
1152 | return false;

1153
1154
1155 | if (millis() -
1156 | lastGPSLocationMs >
1157 | GPS_DATA_TIMEOUT_MS)
1158 | {
1159 | return false;
1160 | }

1161
1162
1163 | if (gpsSats <
1164 | GPS_MIN_SATS)
1165 | {
1166 | return false;
1167 | }

1168
1169
1170 | if (gps.hdop.isValid() &&
1171 | gpsHDOP >
1172 | GPS_MAX_HDOP)
1173 | {
1174 | return false;
1175 | }

1176
1177
1178 | return true;
1179 | }

1180
1181
1182 | // =================================================================
1183 | // QMC5883 INIT
1184 | // =================================================================

1185
1186 | bool initQMC5883()
1187 | {
1188 | // Check device
1189 | Wire.beginTransmission(
1190 | QMC5883_ADDR
1191 | );

1192
1193
1194 | if (Wire.endTransmission() != 0)
1195 | {
1196 | return false;
1197 | }

1198
1199
1200 | // SET/RESET period
1201 | Wire.beginTransmission(
1202 | QMC5883_ADDR
1203 | );

1204
1205 | Wire.write(0x0B);
1206 | Wire.write(0x01);

1207
1208 | if (Wire.endTransmission() != 0)
1209 | {
1210 | return false;
1211 | }

1212
1213
1214 delay(10);

1216
1217 | // Control register
1218 | // Same setting used by your
1219 | // working compass test.
1220 | Wire.beginTransmission(
1221 | QMC5883_ADDR
1222 | );

1223
1224 | Wire.write(0x09);
1225 | Wire.write(0x1D);

1226
1227 | if (Wire.endTransmission() != 0)
1228 | {
1229 | return false;
1230 | }

1231
1232
1233 delay(100);

1234
1235
1236 | return true;
1237 | }

1238
1239
1240 | // =================================================================
1241 | // QMC5883 READ
1242 | // =================================================================

1243
1244 | bool readQMC5883()
1245 | {
1246 | Wire.beginTransmission(
1247 | QMC5883_ADDR
1248 | );

1249
1250 Wire.write(0x00);

1251
1252
1253 | if (Wire.endTransmission(false) != 0)
1254 | {
1255 | return false;
1256 | }

1257
1258
1259 | uint8_t count =
1260 | Wire.requestFrom(
1261 | QMC5883_ADDR,
1262 | (uint8_t)6
1263 | );

1264
1265
1266 | if (count != 6)
1267 | {
1268 | while (Wire.available())
1269 | {
1270 | Wire.read();
1271 | }

1272
1273 | return false;
1274 | }

1275
1276
1277 | uint8_t xl =
1278 | Wire.read();

1279
1280 | uint8_t xh =
1281 | Wire.read();

1282
1283
1284 | uint8_t yl =
1285 | Wire.read();

1286
1287 | uint8_t yh =
1288 | Wire.read();

1289

1291 | uint8_t zl =
1292 | Wire.read();

1293
1294 | uint8_t zh =
1295 | Wire.read();

1296
1297
1298 | rawMagX =
1299 | (int16_t)(
1300 | (xh << 8) |
1301 | xl
1302 | );

1303
1304
1305 | rawMagY =
1306 | (int16_t)(
1307 | (yh << 8) |
1308 | yl
1309 | );

1310
1311
1312 | rawMagZ =
1313 | (int16_t)(
1314 | (zh << 8) |
1315 | zl
1316 | );

1317
1318
1319 | return true;
1320 | }

1321
1322
1323 | // =================================================================
1324 | // COMPASS UPDATE
1325 | // =================================================================

1326
1327 | void updateCompass()
1328 | {
1329 | // --------------------------------------------------------------
1330 | // Read sensor
1331 | // --------------------------------------------------------------

1332
1333 | if (!readQMC5883())
1334 | {
1335 | compassFailCount++;

1336
1337
1338 | // Do not immediately declare compass dead.
1339 | // Reinitialize after 5 consecutive failures.

1340
1341 | if (compassFailCount >= 5)
1342 | {
1343 | if (initQMC5883())
1344 | {
1345 | compassOK = true;

1346
1347 | compassFailCount = 0;

1348
1349 | Serial.println(
1350 | "[COMPASS] Reinitialized OK"
1351 | );
1352 | }
1353 | else
1354 | {
1355 | compassOK = false;
1356 | }
1357 | }

1358
1359
1360 | return;
1361 | }

1362
1363
1364 | // Successful reading
1365 | compassFailCount = 0;

1366 compassOK = true;

1367
1368
1369 | // --------------------------------------------------------------
1370 | // Apply your proven calibration
1371 | // --------------------------------------------------------------

1372
1373 | magX =
1374 | ((float)rawMagX -
1375 | OFFSET_X) *
1376 | SCALE_X;

1377
1378
1379 | magY =
1380 | ((float)rawMagY -
1381 | OFFSET_Y) *
1382 | SCALE_Y;

1383
1384
1385 | magZ =
1386 | ((float)rawMagZ -
1387 | OFFSET_Z) *
1388 | SCALE_Z;

1389
1390
1391 | // --------------------------------------------------------------
1392 | // Calculate heading
1393 | // --------------------------------------------------------------

1394
1395 | float angle =
1396 | atan2(
1397 | magY,
1398 | magX
1399 | ) *
1400 | 180.0f /
1401 | PI;

1402
1403
1404 | if (angle < 0.0f)
1405 | angle += 360.0f;

1406
1407
1408 | compassHeading =
1409 | wrap360(
1410 | angle +
1411 | COMPASS_HEADING_OFFSET_DEG
1412 | );

1413
1414
1415 | // Navigation heading
1416 | navCompassHeading =
1417 | navigationCompassHeading();
1418 | }

1419
1420
1421 | // =================================================================
1422 | // NAVIGATION COMPASS
1423 | // =================================================================

1424
1425 | float navigationCompassHeading()
1426 | {
1427 | if (!COMPASS_MIRROR_FOR_NAV)
1428 | {
1429 | return compassHeading;
1430 | }

1431
1432
1433 | return wrap360(
1434 | 360.0f -
1435 | compassHeading
1436 | );
1437 | }

1438
1439
1440 // =================================================================

1441 | // WRAP 0...360
1442 | // =================================================================

1443
1444 | float wrap360(float angle)
1445 | {
1446 | while (angle >= 360.0f)
1447 | angle -= 360.0f;

1448
1449
1450 | while (angle < 0.0f)
1451 | angle += 360.0f;

1452
1453
1454 | return angle;
1455 | }

1456
1457
1458 | // =================================================================
1459 | // WRAP -180...180
1460 | // =================================================================

1461
1462 | double wrap180(double angle)
1463 | {
1464 | while (angle > 180.0)
1465 | angle -= 360.0;

1466
1467
1468 | while (angle < -180.0)
1469 | angle += 360.0;

1470
1471
1472 | return angle;
1473 | }

1474
1475
1476 | // =================================================================
1477 | // IMU INIT
1478 | // =================================================================

1479
1480 | bool initIMU()
1481 | {
1482 | if (!lsm6dso.begin_I2C(
1483 | LSM6DSO32_ADDR,
1484 | &Wire))
1485 | {
1486 | return false;
1487 | }

1488
1489
1490 | lsm6dso.setAccelRange(
1491 | LSM6DS_ACCEL_RANGE_16_G
1492 | );

1493
1494
1495 | lsm6dso.setGyroRange(
1496 | LSM6DS_GYRO_RANGE_2000_DPS
1497 | );

1498
1499
1500 | lsm6dso.setAccelDataRate(
1501 | LSM6DS_RATE_208_HZ
1502 | );

1503
1504
1505 | lsm6dso.setGyroDataRate(
1506 | LSM6DS_RATE_208_HZ
1507 | );

1508
1509
1510 | return true;
1511 | }

1512
1513
1514 | // =================================================================
1515 | // IMU UPDATE

1516 // =================================================================

1517
1518 | void updateIMU()
1519 | {
1520 | if (!imuOK)
1521 | return;

1522
1523
1524 | sensors_event_t accel;
1525 | sensors_event_t gyro;
1526 | sensors_event_t temp;

1527
1528
1529 | lsm6dso.getEvent(
1530 | &accel,
1531 | &gyro,
1532 | &temp
1533 | );

1534
1535
1536 | accelX =
1537 | accel.acceleration.x;

1538
1539
1540 | accelY =
1541 | accel.acceleration.y;

1542
1543
1544 | accelZ =
1545 | accel.acceleration.z;

1546
1547
1548 | gyroX =
1549 | gyro.gyro.x;

1550
1551
1552 | gyroY =
1553 | gyro.gyro.y;

1554
1555
1556 | gyroZ =
1557 | gyro.gyro.z;
1558 | }

1559
1560
1561 | // =================================================================
1562 | // I2C CHECK
1563 | // =================================================================

1564
1565 | bool checkI2CDevice(
1566 | uint8_t address)
1567 | {
1568 | Wire.beginTransmission(
1569 | address
1570 | );

1571
1572
1573 | return (
1574 | Wire.endTransmission() == 0
1575 | );
1576 | }

1577
1578
1579 | // =================================================================
1580 | // SERVO HEALTH
1581 | // =================================================================

1582
1583 | void updateServoHealth()
1584 | {
1585 | if (millis() -
1586 | lastServoHealthMs <
1587 | SERVO_HEALTH_INTERVAL_MS)
1588 | {
1589 | return;
1590 | }

1591
1592
1593 | lastServoHealthMs =
1594 | millis();

1595
1596
1597 | // Ping ID 1
1598 | int result1 =
1599 | st.Ping(
1600 | SERVO1_ID
1601 | );

1602
1603
1604 delay(10);

1605
1606
1607 | // Ping ID 2
1608 | int result2 =
1609 | st.Ping(
1610 | SERVO2_ID
1611 | );

1612
1613
1614 | servo1OK =
1615 | (result1 >= 0);

1616
1617
1618 | servo2OK =
1619 | (result2 >= 0);

1620
1621
1622 | servoBusReady =
1623 | servo1OK &&
1624 | servo2OK;
1625 | }

1626
1627
1628 | // =================================================================
1629 | // SERVO READY
1630 | // =================================================================

1631
1632 | bool servosReady()
1633 | {
1634 | return
1635 | servoBusReady &&
1636 | servo1OK &&
1637 | servo2OK;
1638 | }

1639
1640
1641 | // =================================================================
1642 | // CENTER BOTH SERVOS
1643 | // =================================================================

1644
1645 | void centerServos()
1646 | {
1647 | if (!servosReady())
1648 | return;

1649
1650
1651 | st.WritePosEx(
1652 | SERVO1_ID,
1653 | SERVO_NEUTRAL,
1654 | STEERING_SERVO_SPEED,
1655 | STEERING_SERVO_ACCEL
1656 | );

1657
1658
1659 | st.WritePosEx(
1660 | SERVO2_ID,
1661 | SERVO_NEUTRAL,
1662 | STEERING_SERVO_SPEED,
1663 | STEERING_SERVO_ACCEL
1664 | );

1666
1667 | | servo1Position =
1668 | | SERVO_NEUTRAL;

1669
1670
1671 | | servo2Position =
1672 | | SERVO_NEUTRAL;

1673
1674
1675 | | steeringDemand = 0;
1676 | }

1677
1678
1679 | // =================================================================
1680 | // DIRECT STEERING COMMAND
1681 | // =================================================================
1682 | //
1683 | // demand = +300:
1684 | //
1685 | // | Servo 1 = 2048 - 300 = 1748
1686 | // | Servo 2 = 2048 + 300 = 2348
1687 | //
1688 | // demand = -300:
1689 | //
1690 | // | Servo 1 = 2048 + 300 = 2348
1691 | // | Servo 2 = 2048 - 300 = 1748
1692 | //

1693
1694 | void commandSteering(
1695 | | int demand)
1696 | {
1697 | | if (!servosReady())
1698 | {
1699 | | Serial.println(
1700 | | "ERROR: ST-3009 BUS NOT READY"
1701 | | );

1702
1703 | | return;
1704 | }

1705
1706
1707 | | demand =
1708 | | constrain(
1709 | | demand,
1710 | | -MAX_STEERING_COUNTS,
1711 | | MAX_STEERING_COUNTS
1712 | | );

1713
1714
1715 | | int pos1 =
1716 | | SERVO_NEUTRAL -
1717 | | demand;

1718
1719
1720 | | int pos2 =
1721 | | SERVO_NEUTRAL +
1722 | | demand;

1723
1724
1725 | | pos1 =
1726 | | constrain(
1727 | | pos1,
1728 | | SERVO_MIN_POS,
1729 | | SERVO_MAX_POS
1730 | | );

1731
1732
1733 | | pos2 =
1734 | | constrain(
1735 | | pos2,
1736 | | SERVO_MIN_POS,
1737 | | SERVO_MAX_POS
1738 | | );

1739

1741 | st.WritePosEx(
1742 | SERVO1_ID,
1743 | pos1,
1744 | STEERING_SERVO_SPEED,
1745 | STEERING_SERVO_ACCEL
1746 | );

1747
1748
1749 | st.WritePosEx(
1750 | SERVO2_ID,
1751 | pos2,
1752 | STEERING_SERVO_SPEED,
1753 | STEERING_SERVO_ACCEL
1754 | );

1755
1756
1757 | servo1Position =
1758 | pos1;

1759
1760
1761 | servo2Position =
1762 | pos2;

1763
1764
1765 | steeringDemand =
1766 | demand;

1767
1768
1769 | Serial.print(
1770 | "DEMAND="
1771 | );

1772
1773 | Serial.print(
1774 | demand
1775 | );

1776
1777 | Serial.print(
1778 | " | S1="
1779 | );

1780
1781 | Serial.print(
1782 | pos1
1783 | );

1784
1785 | Serial.print(
1786 | " | S2="
1787 | );

1788
1789 | Serial.println(
1790 | pos2
1791 | );
1792 | }

1793
1794
1795 | // =================================================================
1796 | // MOTOR TEST START
1797 | // =================================================================

1798
1799 | void startMotorTest()
1800 | {
1801 | if (!servosReady())
1802 | {
1803 | Serial.println(
1804 | | "MOTORTEST BLOCKED: "
1805 | | "ST-3009 NOT READY"
1806 | );

1807
1808 | return;
1809 | }

1810
1811
1812 | motorTestActive =
1813 | true;

1814

1816 | state =
1817 | STATE_MANUAL_TEST;

1818
1819
1820 motorTestStep = 0;

1821
1822 | motorTestTimer =
1823 | millis();

1824
1825
1826 centerServos();

1827
1828
1829 Serial.println();

1830
1831 | Serial.println(
1832 | "========================================"
1833 | );

1834
1835 | Serial.println(
1836 | " | ST-3009 MOTOR TEST"
1837 | );

1838
1839 | Serial.println(
1840 | "========================================"
1841 | );

1842
1843 | Serial.println(
1844 | "CENTER -> LEFT -> CENTER -> RIGHT -> CENTER"
1845 | );

1846
1847 | Serial.println();
1848 | }

1849
1850
1851 | // =================================================================
1852 | // MOTOR TEST UPDATE
1853 | // =================================================================

1854
1855 | void updateMotorTest()
1856 | {
1857 | if (!servosReady())
1858 | {
1859 | motorTestActive =
1860 | false;

1861
1862 | state =
1863 | | STATE_WAIT_READY;

1864
1865 | return;
1866 | }

1867
1868
1869 | if (millis() -
1870 | | motorTestTimer <
1871 | 1800)
1872 | {
1873 | return;
1874 | }

1875
1876
1877 | motorTestTimer =
1878 | millis();

1879
1880
1881 | switch (motorTestStep)
1882 | {
1883 | case 0:

1884
1885 | | Serial.println(
1886 | | "TEST: CENTER"
1887 | );

1888
1889 | | commandSteering(0);

1891 | motorTestStep++;

1892
1893 | break;

1894
1895
1896 | case 1:

1897
1898 | Serial.println(
1899 | "TEST: LEFT"
1900 | );

1901
1902 | commandSteering(
1903 | +300
1904 | );

1905
1906 | motorTestStep++;

1907
1908 | break;

1909
1910
1911 | case 2:

1912
1913 | Serial.println(
1914 | "TEST: CENTER"
1915 | );

1916
1917 | commandSteering(0);

1918
1919 | motorTestStep++;

1920
1921 | break;

1922
1923
1924 | case 3:

1925
1926 | Serial.println(
1927 | "TEST: RIGHT"
1928 | );

1929
1930 | commandSteering(
1931 | -300
1932 | );

1933
1934 | motorTestStep++;

1935
1936 | break;

1937
1938
1939 | case 4:

1940
1941 | Serial.println(
1942 | "TEST: CENTER"
1943 | );

1944
1945 | commandSteering(0);

1946
1947 | motorTestStep++;

1948
1949 | break;

1950
1951
1952 | default:

1953
1954 | motorTestActive =
1955 | false;

1956
1957
1958 | state =
1959 | STATE_WAIT_READY;

1960
1961
1962 | centerServos();

1963
1964
1965 | Serial.println();

1966
1967 | Serial.println(
1968 | "MOTOR TEST COMPLETE"
1969 | );

1970
1971 | Serial.println();

1972
1973 | break;
1974 | }
1975 | }

1976
1977
1978 | // =================================================================
1979 | // NAVIGATION CALCULATION
1980 | // =================================================================

1981
1982 | void updateNavigation()
1983 | {
1984 | if (!gpsQualityOK())
1985 | {
1986 | headingValid =
1987 | false;

1988
1989 | headingSource =
1990 | "NONE";

1991
1992 | return;
1993 | }

1994
1995
1996 | // --------------------------------------------------------------
1997 | // GPS position
1998 | // --------------------------------------------------------------

1999
2000 | currentLatitude =
2001 | gps.location.lat();

2002
2003
2004 | currentLongitude =
2005 | gps.location.lng();

2006
2007
2008 | // --------------------------------------------------------------
2009 | // Distance
2010 | // --------------------------------------------------------------

2011
2012 | distanceToTarget =
2013 | TinyGPSPlus::distanceBetween(
2014 | currentLatitude,
2015 | currentLongitude,
2016 | TARGET_LAT,
2017 | TARGET_LON
2018 | );

2019
2020
2021 | // --------------------------------------------------------------
2022 | // Bearing
2023 | // --------------------------------------------------------------

2024
2025 | targetBearing =
2026 | TinyGPSPlus::courseTo(
2027 | currentLatitude,
2028 | currentLongitude,
2029 | TARGET_LAT,
2030 | TARGET_LON
2031 | );

2032
2033
2034 | targetBearing =
2035 | wrap360(
2036 | targetBearing
2037 | );

2038
2039
2040 // --------------------------------------------------------------

2041 | // Determine heading
2042 | // --------------------------------------------------------------

2043
2044 | headingValid =
2045 | false;

2046
2047
2048 | headingSource =
2049 | "NONE";

2050
2051
2052 | // GPS course when moving
2053 | if (gps.speed.isValid() &&
2054 | gps.course.isValid() &&
2055 | currentSpeed >=
2056 | GPS_COURSE_MIN_SPEED_MPS)
2057 | {
2058 | currentDirection =
2059 | wrap360(
2060 | gps.course.deg()
2061 | );

2062
2063
2064 | headingValid =
2065 | true;

2066
2067
2068 | headingSource =
2069 | "GPS COURSE";
2070 | }

2071
2072
2073 | // Compass when slow/stationary
2074 | else if (compassOK)
2075 | {
2076 | currentDirection =
2077 | navigationCompassHeading();

2078
2079
2080 | headingValid =
2081 | true;

2082
2083
2084 | headingSource =
2085 | "COMPASS";
2086 | }

2087
2088
2089 | // --------------------------------------------------------------
2090 | // Course error
2091 | // --------------------------------------------------------------

2092
2093 | if (headingValid)
2094 | {
2095 | courseError =
2096 | wrap180(
2097 | targetBearing -
2098 | currentDirection
2099 | );
2100 | }
2101 | }

2102
2103
2104 | // =================================================================
2105 | // AUTONOMOUS STEERING
2106 | // =================================================================

2107
2108 | void updateSteering()
2109 | {
2110 | // Manual motor test owns the servos
2111 | if (motorTestActive)
2112 | return;

2113
2114
2115 // Servo unavailable

2116 | if (!servosReady())
2117 | {
2118 | steeringDemand = 0;

2119
2120 | return;
2121 | }

2122
2123
2124 | // Only steer during AUTONAV
2125 | if (state !=
2126 | STATE_AUTONAV)
2127 | {
2128 | return;
2129 | }

2130
2131
2132 | // GPS required
2133 | if (!gpsQualityOK())
2134 | {
2135 | centerServos();

2136
2137 | return;
2138 | }

2139
2140
2141 | // Target captured
2142 | if (distanceToTarget <=
2143 | TARGET_CAPTURE_RADIUS_M)
2144 | {
2145 | centerServos();

2146
2147 | return;
2148 | }

2149
2150
2151 | // No heading
2152 | if (!headingValid)
2153 | {
2154 | centerServos();

2155
2156 | return;
2157 | }

2158
2159
2160 | // --------------------------------------------------------------
2161 | // Absolute error
2162 | // --------------------------------------------------------------

2163
2164 | double absoluteError =
2165 | fabs(courseError);

2166
2167
2168 | // --------------------------------------------------------------
2169 | // Deadband
2170 | // --------------------------------------------------------------

2171
2172 | if (absoluteError <=
2173 | STEERING_DEADBAND_DEG)
2174 | {
2175 | steeringDemand = 0;
2176 | }
2177 | else
2178 | {
2179 | double usableError =
2180 | absoluteError -
2181 | STEERING_DEADBAND_DEG;

2182
2183
2184 | double usableRange =
2185 | FULL_STEERING_ERROR_DEG -
2186 | STEERING_DEADBAND_DEG;

2187
2188
2189 | double normalized =
2190 | usableError /

2191 | usableRange;

2192
2193
2194 | normalized =
2195 | constrain(
2196 | normalized,
2197 | 0.0,
2198 | 1.0
2199 | );

2200
2201
2202 | int demand =
2203 | (int)round(
2204 | normalized *
2205 | MAX_STEERING_COUNTS
2206 | );

2207
2208
2209 | if (courseError > 0.0)
2210 | {
2211 | steeringDemand =
2212 | demand;
2213 | }
2214 | else
2215 | {
2216 | steeringDemand =
2217 | -demand;
2218 | }
2219 | }

2220
2221
2222 | // --------------------------------------------------------------
2223 | // Target positions
2224 | // --------------------------------------------------------------

2225
2226 | int target1 =
2227 | SERVO_NEUTRAL -
2228 | steeringDemand;

2229
2230
2231 | int target2 =
2232 | SERVO_NEUTRAL +
2233 | steeringDemand;

2234
2235
2236 | target1 =
2237 | constrain(
2238 | target1,
2239 | SERVO_MIN_POS,
2240 | SERVO_MAX_POS
2241 | );

2242
2243
2244 | target2 =
2245 | constrain(
2246 | target2,
2247 | SERVO_MIN_POS,
2248 | SERVO_MAX_POS
2249 | );

2250
2251
2252 | // --------------------------------------------------------------
2253 | // Slew limit
2254 | // --------------------------------------------------------------

2255
2256 | int new1 =
2257 | slewTo(
2258 | servo1Position,
2259 | target1,
2260 | MAX_SLEW_COUNTS
2261 | );

2262
2263
2264 | int new2 =
2265 | slewTo(

2266 | servo2Position,
2267 | target2,
2268 | MAX_SLEW_COUNTS
2269 | );

2270
2271
2272 | // --------------------------------------------------------------
2273 | // Send only if changed
2274 | // --------------------------------------------------------------

2275
2276 | if (new1 != servo1Position ||
2277 | new2 != servo2Position)
2278 | {
2279 | st.WritePosEx(
2280 | SERVO1_ID,
2281 | new1,
2282 | STEERING_SERVO_SPEED,
2283 | STEERING_SERVO_ACCEL
2284 | );

2285
2286
2287 | st.WritePosEx(
2288 | SERVO2_ID,
2289 | new2,
2290 | STEERING_SERVO_SPEED,
2291 | STEERING_SERVO_ACCEL
2292 | );

2293
2294
2295 | servo1Position =
2296 | new1;

2297
2298
2299 | servo2Position =
2300 | new2;
2301 | }
2302 | }

2303
2304
2305 | // =================================================================
2306 | // SLEW LIMIT
2307 | // =================================================================

2308
2309 | int slewTo(
2310 | int currentValue,
2311 | int targetValue,
2312 | int maxStep)
2313 | {
2314 | if (targetValue >
2315 | currentValue)
2316 | {
2317 | int difference =
2318 | targetValue -
2319 | currentValue;

2320
2321
2322 | if (difference >
2323 | maxStep)
2324 | {
2325 | return currentValue +
2326 | maxStep;
2327 | }

2328
2329
2330 | return targetValue;
2331 | }

2332
2333
2334 | if (targetValue <
2335 | currentValue)
2336 | {
2337 | int difference =
2338 | currentValue -
2339 | targetValue;

2341
2342 | if (difference >
2343 | maxStep)
2344 | {
2345 | return currentValue -
2346 | maxStep;
2347 | }

2348
2349
2350 | return targetValue;
2351 | }

2352
2353
2354 | return currentValue;
2355 | }

2356
2357
2358 | // =================================================================
2359 | // DEPLOYMENT
2360 | // =================================================================

2361
2362 | void startDeployment()
2363 | {
2364 | if (deploymentDone)
2365 | {
2366 | Serial.println(
2367 | "DEPLOYMENT ALREADY COMPLETED"
2368 | );

2369
2370 | return;
2371 | }

2372
2373
2374 | if (!gpsQualityOK())
2375 | {
2376 | Serial.println(
2377 | "DEPLOY BLOCKED: GPS NOT READY"
2378 | );

2379
2380 | return;
2381 | }

2382
2383
2384 | if (!servosReady())
2385 | {
2386 | Serial.println(
2387 | "DEPLOY BLOCKED: ST-3009 NOT READY"
2388 | );

2389
2390 | return;
2391 | }

2392
2393
2394 | // Center steering first
2395 | centerServos();

2396
2397
2398 delay(100);

2399
2400
2401 | // Attach SG90
2402 | deployServo.attach(
2403 | DEPLOY_SERVO_PIN
2404 | );

2405
2406
2407 delay(100);

2408
2409
2410 | // Deployment position
2411 | deployServo.write(
2412 | DEPLOY_ANGLE
2413 | );

2414

2416 | deploymentStartMs =
2417 | millis();

2418
2419
2420 | deploymentServoActive =
2421 | true;

2422
2423
2424 | deploymentDone =
2425 | true;

2426
2427
2428 | state =
2429 | STATE_DEPLOYING;

2430
2431
2432 | stateEnteredMs =
2433 | millis();

2434
2435
2436 Serial.println();

2437
2438 | Serial.println(
2439 | "========================================"
2440 | );

2441
2442 | Serial.println(
2443 | "STARTING DEPLOYMENT"
2444 | );

2445
2446 | Serial.print(
2447 | "SG90 -> "
2448 | );

2449
2450 | Serial.print(
2451 | DEPLOY_ANGLE
2452 | );

2453
2454 | Serial.println(
2455 | " degrees"
2456 | );
2457 | }

2458
2459
2460 | // =================================================================
2461 | // SG90 PREP
2462 | // =================================================================

2463
2464 | void prepareDeploymentServo()
2465 | {
2466 | deployServo.attach(
2467 | DEPLOY_SERVO_PIN
2468 | );

2469
2470
2471 delay(100);

2472
2473
2474 | deployServo.write(
2475 | PREP_ANGLE
2476 | );

2477
2478
2479 | Serial.print(
2480 | "SG90 -> "
2481 | );

2482
2483 | Serial.print(
2484 | PREP_ANGLE
2485 | );

2486
2487 | Serial.println(
2488 | " degrees"
2489 | );

2491
2492 delay(1000);

2493
2494
2495 deployServo.detach();

2496
2497
2498 | Serial.println(
2499 | "SG90 detached"
2500 | );
2501 | }

2502
2503
2504 | // =================================================================
2505 | // STATE MACHINE
2506 | // =================================================================

2507
2508 | void updateStateMachine()
2509 | {
2510 | // --------------------------------------------------------------
2511 | // Manual test
2512 | // --------------------------------------------------------------

2513
2514 | if (state ==
2515 | STATE_MANUAL_TEST)
2516 | {
2517 | return;
2518 | }

2519
2520
2521 | // --------------------------------------------------------------
2522 | // WAIT READY
2523 | // --------------------------------------------------------------

2524
2525 | if (state ==
2526 | STATE_WAIT_READY)
2527 | {
2528 | if (AUTO_DEPLOY_AFTER_READY &&
2529 | !deploymentDone &&
2530 | gpsQualityOK() &&
2531 | servosReady())
2532 | {
2533 | Serial.println();

2534
2535 | Serial.println(
2536 | "GPS + ST-3009 READY"
2537 | );

2538
2539 | Serial.println(
2540 | "AUTO DEPLOY ENABLED"
2541 | );

2542
2543
2544 | startDeployment();
2545 | }

2546
2547
2548 | return;
2549 | }

2550
2551
2552 | // --------------------------------------------------------------
2553 | // DEPLOYING
2554 | // --------------------------------------------------------------

2555
2556 | if (state ==
2557 | STATE_DEPLOYING)
2558 | {
2559 | steeringDemand =
2560 | 0;

2561
2562
2563 | if (millis() -
2564 | deploymentStartMs >=
2565 | DEPLOY_MOVE_TIME_MS)

2566 | {
2567 | // Detach SG90
2568 | deployServo.detach();

2569
2570
2571 | deploymentServoActive =
2572 | false;

2573
2574
2575 | // Center steering
2576 | if (servosReady())
2577 | {
2578 | centerServos();
2579 | }

2580
2581
2582 | // Stabilization starts
2583 | stabilizationStartMs =
2584 | millis();

2585
2586
2587 | state =
2588 | STATE_STABILIZING;

2589
2590
2591 | Serial.println();

2592
2593 | Serial.println(
2594 | "SG90 detached"
2595 | );

2596
2597 | Serial.println(
2598 | "5 second stabilization started"
2599 | );
2600 | }

2601
2602
2603 | return;
2604 | }

2605
2606
2607 | // --------------------------------------------------------------
2608 | // STABILIZING
2609 | // --------------------------------------------------------------

2610
2611 | if (state ==
2612 | STATE_STABILIZING)
2613 | {
2614 | steeringDemand =
2615 | 0;

2616
2617
2618 | if (millis() -
2619 | stabilizationStartMs >=
2620 | DEPLOY_STABILIZE_TIME_MS)
2621 | {
2622 | if (gpsQualityOK() &&
2623 | servosReady())
2624 | {
2625 | state =
2626 | STATE_AUTONAV;

2627
2628
2629 | Serial.println();

2630
2631 | Serial.println(
2632 | "========================================"
2633 | );

2634
2635 | Serial.println(
2636 | "AUTONOMOUS NAVIGATION STARTED"
2637 | );

2638
2639 | Serial.println(
2640 | "========================================"

2641 | );
2642 | }
2643 | }

2644
2645
2646 | return;
2647 | }

2648
2649
2650 | // --------------------------------------------------------------
2651 | // AUTONAV
2652 | // --------------------------------------------------------------

2653
2654 | if (state ==
2655 | STATE_AUTONAV)
2656 | {
2657 | // GPS / servo failure
2658 | if (!gpsQualityOK() ||
2659 | !servosReady())
2660 | {
2661 | steeringDemand =
2662 | 0;

2663
2664
2665 | if (servosReady())
2666 | {
2667 | centerServos();
2668 | }

2669
2670
2671 | state =
2672 | STATE_FAILSAFE;

2673
2674
2675 | failsafeGoodSinceMs =
2676 | 0;

2677
2678
2679 | Serial.println();

2680
2681 | Serial.println(
2682 | "!!! NAVIGATION FAILSAFE !!!"
2683 | );

2684
2685 | Serial.println(
2686 | "GPS or ST-3009 unavailable"
2687 | );

2688
2689
2690 | return;
2691 | }

2692
2693
2694 | // Target capture
2695 | if (distanceToTarget <=
2696 | TARGET_CAPTURE_RADIUS_M)
2697 | {
2698 | centerServos();

2699
2700
2701 | state =
2702 | STATE_CAPTURED;

2703
2704
2705 | Serial.println();

2706
2707 | Serial.println(
2708 | "========================================"
2709 | );

2710
2711 | Serial.println(
2712 | "TARGET CAPTURED"
2713 | );

2714
2715 | Serial.print(

2716 | "Distance = "
2717 | );

2718
2719 | Serial.print(
2720 | distanceToTarget,
2721 | 2
2722 | );

2723
2724 | Serial.println(
2725 | " m"
2726 | );

2727
2728 | Serial.println(
2729 | "ST-3009 -> CENTER"
2730 | );

2731
2732 | Serial.println(
2733 | "========================================"
2734 | );
2735 | }

2736
2737
2738 | return;
2739 | }

2740
2741
2742 | // --------------------------------------------------------------
2743 | // CAPTURED
2744 | // --------------------------------------------------------------

2745
2746 | if (state ==
2747 | STATE_CAPTURED)
2748 | {
2749 | steeringDemand =
2750 | 0;

2751
2752 | return;
2753 | }

2754
2755
2756 | // --------------------------------------------------------------
2757 | // FAILSAFE
2758 | // --------------------------------------------------------------

2759
2760 | if (state ==
2761 | STATE_FAILSAFE)
2762 | {
2763 | steeringDemand =
2764 | 0;

2765
2766
2767 | if (servosReady())
2768 | {
2769 | centerServos();
2770 | }

2771
2772
2773 | if (gpsQualityOK() &&
2774 | servosReady())
2775 | {
2776 | if (failsafeGoodSinceMs ==
2777 | 0)
2778 | {
2779 | failsafeGoodSinceMs =
2780 | millis();

2781
2782
2783 | Serial.println(
2784 | "GPS + ST-3009 recovered"
2785 | );

2786
2787
2788 | Serial.println(
2789 | "Waiting 3 seconds..."
2790 | );

2791 | }
2792 | else if (millis() -
2793 | failsafeGoodSinceMs >=
2794 | FAILSAFE_RECOVERY_MS)
2795 | {
2796 | state =
2797 | STATE_AUTONAV;

2798
2799
2800 | failsafeGoodSinceMs =
2801 | 0;

2802
2803
2804 | Serial.println(
2805 | "FAILSAFE RECOVERY COMPLETE"
2806 | );

2807
2808
2809 | Serial.println(
2810 | "AUTONAV RESUMED"
2811 | );
2812 | }
2813 | }
2814 | else
2815 | {
2816 | failsafeGoodSinceMs =
2817 | 0;
2818 | }

2819
2820
2821 | return;
2822 | }
2823 | }

2824
2825
2826 | // =================================================================
2827 | // SERIAL INPUT
2828 | // =================================================================

2829
2830 | void processSerialCommands()
2831 | {
2832 | while (Serial.available() > 0)
2833 | {
2834 | char c =
2835 | (char)Serial.read();

2836
2837
2838 | // --------------------------------------------------------------
2839 | // Newline
2840 | // --------------------------------------------------------------

2841
2842 | if (c == ’\r’ ||
2843 | c == ’\n’)
2844 | {
2845 | if (commandIndex > 0)
2846 | {
2847 | commandBuffer[
2848 | commandIndex] =
2849 | ’\0’;

2850
2851
2852 | processCommand(
2853 | commandBuffer
2854 | );

2855
2856
2857 | commandIndex =
2858 | 0;
2859 | }

2860
2861
2862 | continue;
2863 | }

2864

2866 | // --------------------------------------------------------------
2867 | // Store
2868 | // --------------------------------------------------------------

2869
2870 | if (commandIndex <
2871 | COMMAND_BUFFER_SIZE - 1)
2872 | {
2873 | commandBuffer[
2874 | commandIndex++] =
2875 | c;
2876 | }
2877 | else
2878 | {
2879 | commandIndex = 0;

2880
2881 | Serial.println(
2882 | "ERROR: COMMAND TOO LONG"
2883 | );
2884 | }
2885 | }
2886 | }

2887
2888
2889 | // =================================================================
2890 | // COMMAND PROCESSOR
2891 | // =================================================================

2892
2893 | void processCommand(
2894 | char *cmd)
2895 | {
2896 | // Remove leading spaces
2897 | while (*cmd == ’ ’ ||
2898 | *cmd == ’\t’)
2899 | {
2900 | cmd++;
2901 | }

2902
2903
2904 | // Remove trailing spaces
2905 | int len =
2906 | strlen(cmd);

2907
2908
2909 | while (len > 0 &&
2910 | (cmd[len - 1] == ’ ’ ||
2911 | cmd[len - 1] == ’\t’))
2912 | {
2913 | cmd[len - 1] =
2914 | ’\0’;

2915
2916 | len--;
2917 | }

2918
2919
2920 | if (len == 0)
2921 | return;

2922
2923
2924 | Serial.print(
2925 | "CMD RECEIVED: ["
2926 | );

2927
2928 | Serial.print(
2929 | cmd
2930 | );

2931
2932 | Serial.println(
2933 | "]"
2934 | );

2935
2936
2937 | // ==============================================================
2938 | // STATUS
2939 | // ==============================================================

2941 | if (strcmp(
2942 | cmd,
2943 | "STATUS") == 0)
2944 | {
2945 | printStatus();
2946 | return;
2947 | }

2948
2949
2950 | // ==============================================================
2951 | // MOTORTEST
2952 | // ==============================================================

2953
2954 | if (strcmp(
2955 | cmd,
2956 | "MOTORTEST") == 0)
2957 | {
2958 | startMotorTest();
2959 | return;
2960 | }

2961
2962
2963 | // ==============================================================
2964 | // LEFT
2965 | // ==============================================================

2966
2967 | if (strcmp(
2968 | cmd,
2969 | "LEFT") == 0)
2970 | {
2971 | motorTestActive =
2972 | false;

2973
2974
2975 | state =
2976 | STATE_MANUAL_TEST;

2977
2978
2979 | commandSteering(
2980 | +300
2981 | );

2982
2983
2984 | return;
2985 | }

2986
2987
2988 | // ==============================================================
2989 | // RIGHT
2990 | // ==============================================================

2991
2992 | if (strcmp(
2993 | cmd,
2994 | "RIGHT") == 0)
2995 | {
2996 | motorTestActive =
2997 | false;

2998
2999
3000 | state =
3001 | STATE_MANUAL_TEST;

3002
3003
3004 | commandSteering(
3005 | -300
3006 | );

3007
3008
3009 | return;
3010 | }

3011
3012
3013 | // ==============================================================
3014 | // CENTER
3015 | // ==============================================================

3016
3017 | if (strcmp(
3018 | cmd,
3019 | "CENTER") == 0)
3020 | {
3021 | motorTestActive =
3022 | false;

3023
3024
3025 | if (servosReady())
3026 | {
3027 | centerServos();

3028
3029
3030 | Serial.println(
3031 | "ST-3009 -> CENTER"
3032 | );
3033 | }
3034 | else
3035 | {
3036 | Serial.println(
3037 | "ST-3009 BUS NOT READY"
3038 | );
3039 | }

3040
3041
3042 | state =
3043 | STATE_WAIT_READY;

3044
3045
3046 | return;
3047 | }

3048
3049
3050 | // ==============================================================
3051 | // AUTONAV
3052 | // ==============================================================

3053
3054 | if (strcmp(
3055 | cmd,
3056 | "AUTONAV") == 0)
3057 | {
3058 | motorTestActive =
3059 | false;

3060
3061
3062 | if (gpsQualityOK() &&
3063 | servosReady())
3064 | {
3065 | state =
3066 | STATE_AUTONAV;

3067
3068
3069 | Serial.println(
3070 | "AUTONAV ENABLED"
3071 | );
3072 | }
3073 | else
3074 | {
3075 | Serial.println(
3076 | "AUTONAV BLOCKED"
3077 | );

3078
3079
3080 | Serial.print(
3081 | "GPS = "
3082 | );

3083
3084 | Serial.println(
3085 | gpsQualityOK()
3086 | ? "GOOD"
3087 | : "BAD"
3088 | );

3089

3091 | Serial.print(
3092 | "SERVO = "
3093 | );

3094
3095 | Serial.println(
3096 | servosReady()
3097 | ? "GOOD"
3098 | : "BAD"
3099 | );
3100 | }

3101
3102
3103 | return;
3104 | }

3105
3106
3107 | // ==============================================================
3108 | // DEPLOY
3109 | // ==============================================================

3110
3111 | if (strcmp(
3112 | cmd,
3113 | "DEPLOY") == 0)
3114 | {
3115 | motorTestActive =
3116 | false;

3117
3118
3119 | startDeployment();

3120
3121 | return;
3122 | }

3123
3124
3125 | // ==============================================================
3126 | // PREP
3127 | // ==============================================================

3128
3129 | if (strcmp(
3130 | cmd,
3131 | "PREP") == 0)
3132 | {
3133 | motorTestActive =
3134 | false;

3135
3136
3137 | prepareDeploymentServo();

3138
3139 | return;
3140 | }

3141
3142
3143 | // ==============================================================
3144 | // RESET
3145 | // ==============================================================

3146
3147 | if (strcmp(
3148 | cmd,
3149 | "RESET") == 0)
3150 | {
3151 | motorTestActive =
3152 | false;

3153
3154
3155 | resetSystem();

3156
3157 | return;
3158 | }

3159
3160
3161 | // ==============================================================
3162 | // HELP
3163 | // ==============================================================

3164
3165 if (strcmp(

3166 | cmd,
3167 | "HELP") == 0)
3168 | {
3169 | Serial.println();

3170
3171 | Serial.println(
3172 | "STATUS"
3173 | );

3174
3175 | Serial.println(
3176 | "MOTORTEST"
3177 | );

3178
3179 | Serial.println(
3180 | "LEFT"
3181 | );

3182
3183 | Serial.println(
3184 | "RIGHT"
3185 | );

3186
3187 | Serial.println(
3188 | "CENTER"
3189 | );

3190
3191 | Serial.println(
3192 | "AUTONAV"
3193 | );

3194
3195 | Serial.println(
3196 | "DEPLOY"
3197 | );

3198
3199 | Serial.println(
3200 | "PREP"
3201 | );

3202
3203 | Serial.println(
3204 | "RESET"
3205 | );

3206
3207 | Serial.println(
3208 | "HELP"
3209 | );

3210
3211
3212 | Serial.println();

3213
3214 | Serial.println(
3215 | "TARGET IS FIXED IN CODE"
3216 | );

3217
3218
3219 | return;
3220 | }

3221
3222
3223 | // Unknown
3224 | Serial.print(
3225 | "UNKNOWN COMMAND: "
3226 | );

3227
3228 | Serial.println(
3229 | cmd
3230 | );
3231 | }

3232
3233
3234 | // =================================================================
3235 | // RESET
3236 | // =================================================================

3237
3238 | void resetSystem()
3239 | {
3240 | // Stop deployment servo

3241 | if (deploymentServoActive)
3242 | {
3243 | deployServo.detach();

3244
3245 | deploymentServoActive =
3246 | false;
3247 | }

3248
3249
3250 | // Stop motor test
3251 | motorTestActive =
3252 | false;

3253
3254
3255 | // Center if available
3256 | if (servosReady())
3257 | {
3258 | centerServos();
3259 | }

3260
3261
3262 | // Reset flags
3263 | deploymentDone =
3264 | false;

3265
3266
3267 | steeringDemand =
3268 | 0;

3269
3270
3271 | failsafeGoodSinceMs =
3272 | 0;

3273
3274
3275 | // Return to wait state
3276 | state =
3277 | STATE_WAIT_READY;

3278
3279
3280 | stateEnteredMs =
3281 | millis();

3282
3283
3284 Serial.println();

3285
3286 | Serial.println(
3287 | "========================================"
3288 | );

3289
3290 | Serial.println(
3291 | "SYSTEM RESET"
3292 | );

3293
3294 | Serial.print(
3295 | "TARGET = "
3296 | );

3297
3298 | Serial.print(
3299 | TARGET_LAT,
3300 | 7
3301 | );

3302
3303 | Serial.print(
3304 | ", "
3305 | );

3306
3307 | Serial.println(
3308 | TARGET_LON,
3309 | 7
3310 | );

3311
3312 | Serial.println(
3313 | "========================================"
3314 | );
3315 | }

3316
3317
3318 | // =================================================================
3319 | // STATUS
3320 | // =================================================================

3321
3322 | void printStatus()
3323 | {
3324 | Serial.println();

3325
3326 | Serial.println(
3327 | "================================================"
3328 | );

3329
3330 | Serial.println(
3331 | " | STATUS"
3332 | );

3333
3334 | Serial.println(
3335 | "================================================"
3336 | );

3337
3338
3339 | // System
3340 | Serial.print(
3341 | "State | : "
3342 | );

3343
3344 | Serial.println(
3345 | stateName(state)
3346 | );

3347
3348
3349 | // Target
3350 | Serial.print(
3351 | "Target latitude | : "
3352 | );

3353
3354 | Serial.println(
3355 | TARGET_LAT,
3356 | 7
3357 | );

3358
3359
3360 | Serial.print(
3361 | "Target longitude | : "
3362 | );

3363
3364 | Serial.println(
3365 | TARGET_LON,
3366 | 7
3367 | );

3368
3369
3370 | // GPS
3371 | Serial.print(
3372 | "GPS fix | : "
3373 | );

3374
3375 | Serial.println(
3376 | gpsFix
3377 | ? "YES"
3378 | : "NO"
3379 | );

3380
3381
3382 | Serial.print(
3383 | "GPS quality | : "
3384 | );

3385
3386 | Serial.println(
3387 | gpsQualityOK()
3388 | ? "GOOD"
3389 | : "BAD"
3390 | );

3391
3392
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

3691 | void printLiveData()
3692 | {
3693 | Serial.print(
3694 | "[LIVE] State="
3695 | );

3696
3697 | Serial.print(
3698 | stateName(state)
3699 | );

3700
3701
3702 | // GPS
3703 | Serial.print(
3704 | " GPS="
3705 | );

3706
3707 | Serial.print(
3708 | gpsQualityOK()
3709 | ? "GOOD"
3710 | : "BAD"
3711 | );

3712
3713
3714 | Serial.print(
3715 | " SAT="
3716 | );

3717
3718 | Serial.print(
3719 | gpsSats
3720 | );

3721
3722
3723 | Serial.print(
3724 | " HDOP="
3725 | );

3726
3727 | Serial.print(
3728 | gpsHDOP,
3729 | 1
3730 | );

3731
3732
3733 | if (gpsFix)
3734 | {
3735 | Serial.print(
3736 | " LAT="
3737 | );

3738
3739 | Serial.print(
3740 | currentLatitude,
3741 | 6
3742 | );

3743
3744
3745 | Serial.print(
3746 | " LON="
3747 | );

3748
3749 | Serial.print(
3750 | currentLongitude,
3751 | 6
3752 | );
3753 | }

3754
3755
3756 | // Navigation
3757 | if (gpsQualityOK())
3758 | {
3759 | Serial.print(
3760 | " DIST="
3761 | );

3762
3763 | Serial.print(
3764 | distanceToTarget,
3765 | 1

3766 | );

3767
3768
3769 | Serial.print(
3770 | "m BRG="
3771 | );

3772
3773 | Serial.print(
3774 | targetBearing,
3775 | 1
3776 | );
3777 | }

3778
3779
3780 | // Heading
3781 | if (headingValid)
3782 | {
3783 | Serial.print(
3784 | " HDG="
3785 | );

3786
3787 | Serial.print(
3788 | currentDirection,
3789 | 1
3790 | );

3791
3792
3793 | Serial.print(
3794 | " SRC="
3795 | );

3796
3797 | Serial.print(
3798 | headingSource
3799 | );

3800
3801
3802 | Serial.print(
3803 | " ERR="
3804 | );

3805
3806 | Serial.print(
3807 | courseError,
3808 | 1
3809 | );
3810 | }
3811 | else
3812 | {
3813 | Serial.print(
3814 | " HDG=NONE"
3815 | );
3816 | }

3817
3818
3819 | // Steering
3820 | Serial.print(
3821 | " DEM="
3822 | );

3823
3824 | Serial.print(
3825 | steeringDemand
3826 | );

3827
3828
3829 | Serial.print(
3830 | " S1="
3831 | );

3832
3833 | Serial.print(
3834 | servo1Position
3835 | );

3836
3837
3838 | Serial.print(
3839 | " S2="
3840 | );

3841
3842 | Serial.print(
3843 | servo2Position
3844 | );

3845
3846
3847 | // Compass
3848 | Serial.print(
3849 | " CMP="
3850 | );

3851
3852 | Serial.print(
3853 | compassOK
3854 | ? "OK"
3855 | : "FAIL"
3856 | );

3857
3858
3859 | Serial.print(
3860 | " CHP="
3861 | );

3862
3863 | Serial.print(
3864 | compassHeading,
3865 | 1
3866 | );

3867
3868
3869 | Serial.print(
3870 | " NAV="
3871 | );

3872
3873 | Serial.print(
3874 | navCompassHeading,
3875 | 1
3876 | );

3877
3878
3879 | // IMU
3880 | Serial.print(
3881 | " IMU="
3882 | );

3883
3884 | Serial.print(
3885 | imuOK
3886 | ? "OK"
3887 | : "FAIL"
3888 | );

3889
3890
3891 | // Servos
3892 | Serial.print(
3893 | " SERVO="
3894 | );

3895
3896 | Serial.println(
3897 | servosReady()
3898 | ? "OK"
3899 | : "FAIL"
3900 | );
3901 | }

3902
3903
3904 | // =================================================================
3905 | // STATE NAME
3906 | // =================================================================

3907
3908 | const char *stateName(
3909 | SystemState s)
3910 | {
3911 | switch (s)
3912 | {
3913 | case STATE_WAIT_READY:
3914 | return "WAIT_READY";

3916
3917 | case STATE_DEPLOYING:
3918 | return "DEPLOYING";

3919
3920
3921 | case STATE_STABILIZING:
3922 | return "STABILIZING";

3923
3924
3925 | case STATE_AUTONAV:
3926 | return "AUTONAV";

3927
3928
3929 | case STATE_CAPTURED:
3930 | return "CAPTURED";

3931
3932
3933 | case STATE_FAILSAFE:
3934 | return "FAILSAFE";

3935
3936
3937 | case STATE_MANUAL_TEST:
3938 | return "MANUAL_TEST";

3939
3940
3941 | default:
3942 | return "UNKNOWN";
3943 | }
3944 | }
A.6 | Archived source 6: Teensy_Parafoil_Final_SingleServo_MATLAB.ino
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
